CodingGhost/CCIPN/README.md

# CCIPN
Computer controlled intelligent power network
#Add Informations and news to this Project here.
#change 1
