CodingGhost/CCIPN/CCMR/Docs/CCMR.pptx

## CCMR

FPA in NWT
Klasse 10c
Lehrer: hr.Bujok

Computer Controlled Methane Reactor

## Inhalt

1. Einleitung
2. Aufbau
3. Hardware
4. Betriebsablauf
5. Software
6. Fazit

## Einleitung

- Idee:

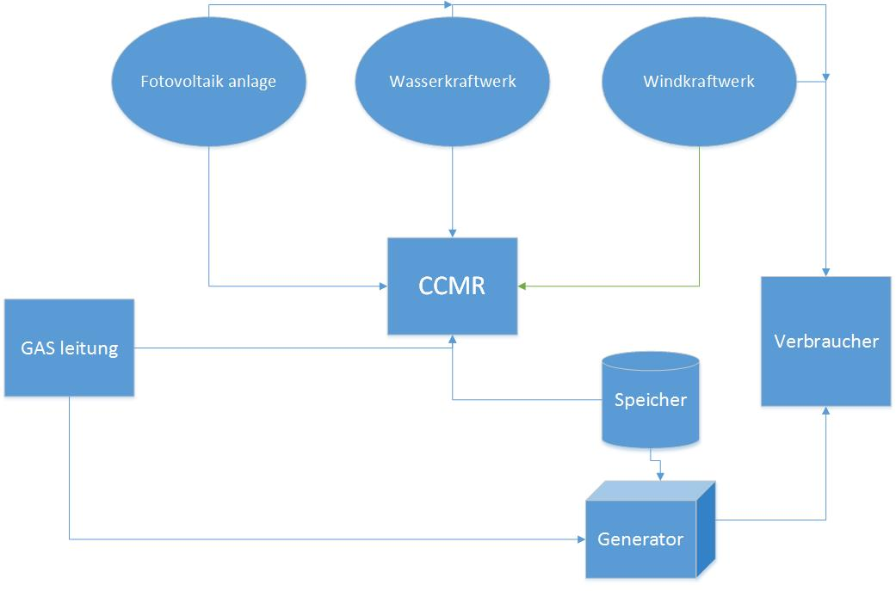
[picture p1: figure]

## Slide 4

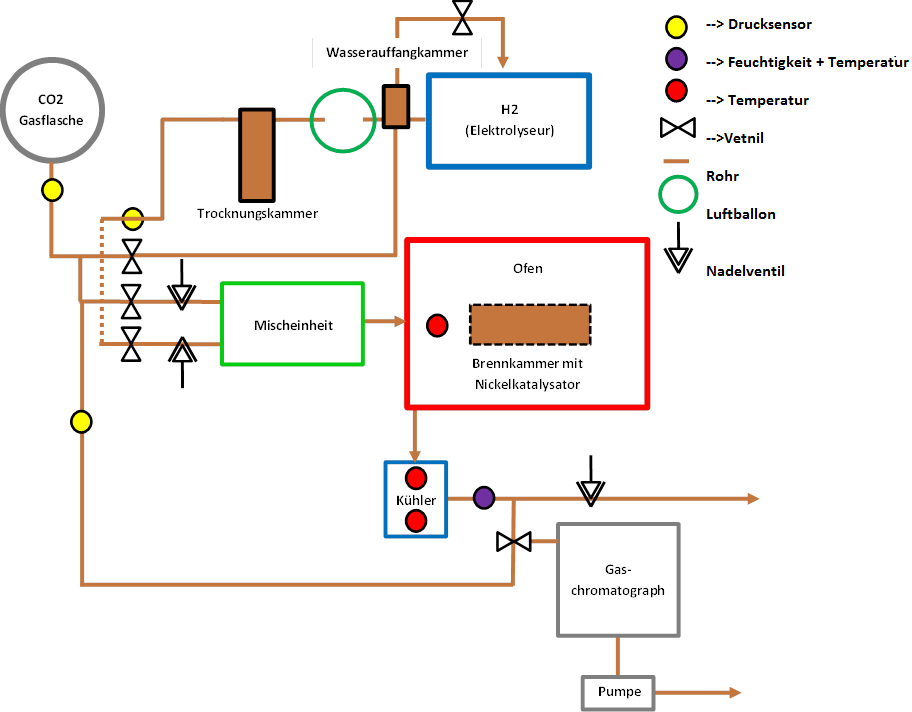
[picture p2: figure]

## Hardware

Sensoren:
- Drucksensor
- Temperatursensor
- Feuchtigkeitssensor
- Thermoelement
- Infrarotsensor
- Ultraschallsensor
- Potentiometer
- Selbstgebauter Gas Sensor

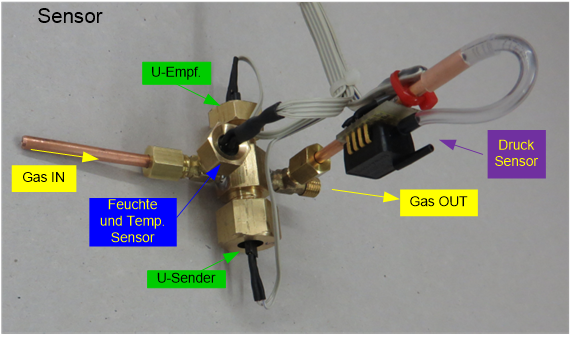
[picture p3: figure]

## Hardware

I2C Verteiler
Zur Vermeidung von Adresskonflikten

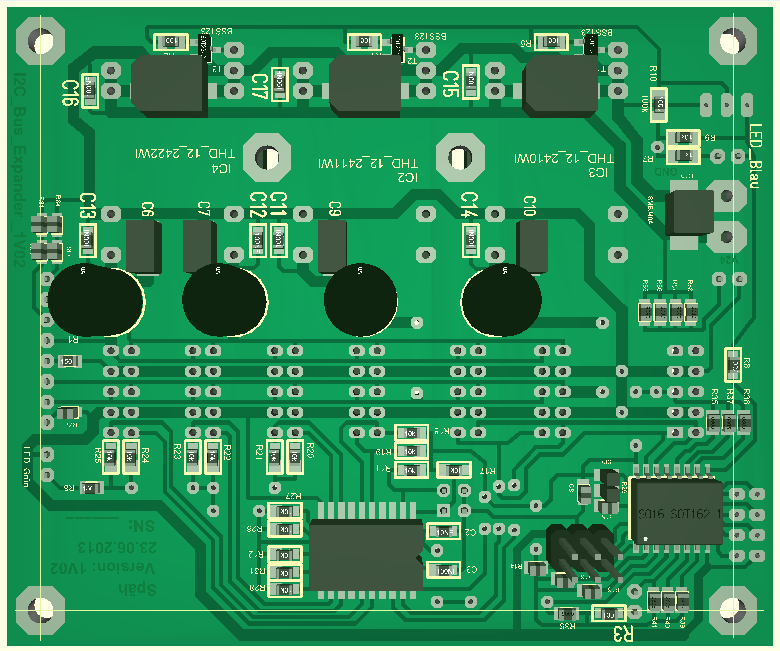
[picture p4: figure]

## Hardware

Sensor Platine
Zur Digitalisierung alle Analogwerte mittels AD Wandler
Außerdem ein DA Wandler der nicht verwendet wird.

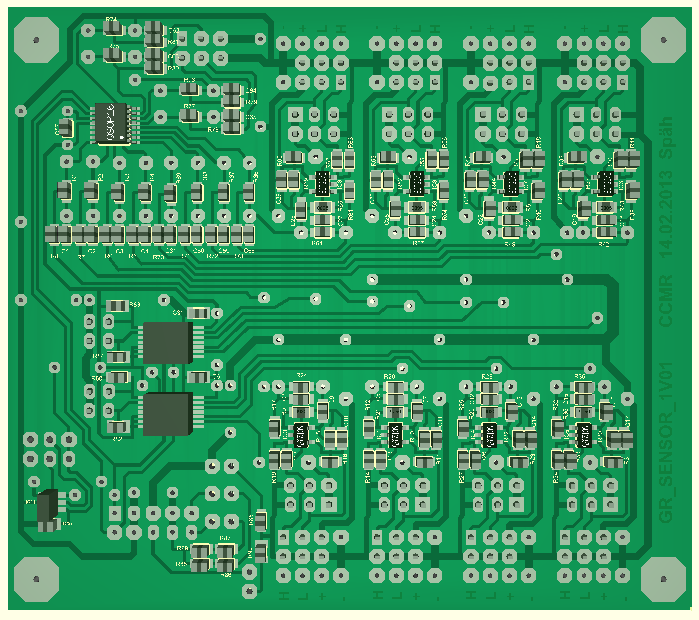
[picture p5: figure]

## Hardware

FET Platine
Zur Steuerung aller Leistungsbauteile

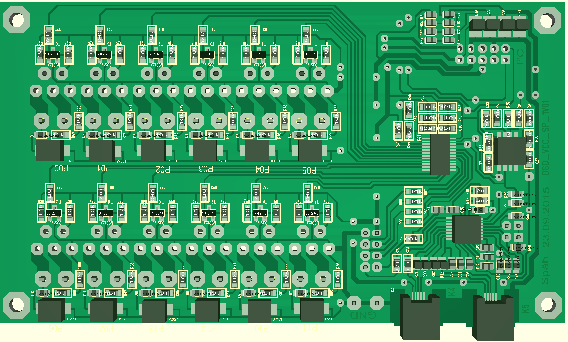
[picture p6: figure]

## Hardware

- Ultraschall Sensorplatine
- Momentan zu langsam
- Einsatz von FPGAs geplant

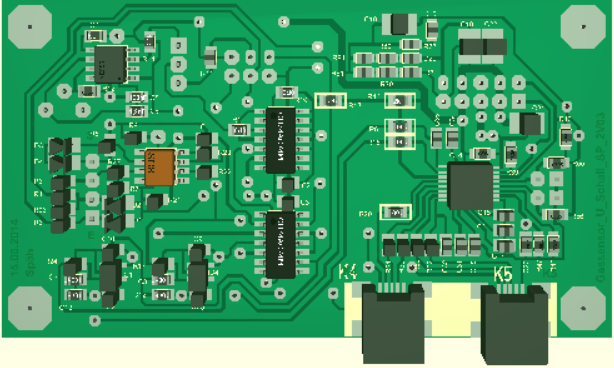
[picture p7: figure]

## Betriebsablauf

1. Gasflasche Manuell aufdrehen
2. Spülung mit Co2
3. Wasserstoff vorproduzieren
4. Ofen vorheizen
5. Beide Gase werden in de Mischkammer geleitet
6. Gase in Brennkammer leiten
7. Gase Reagieren zu CH4 = Methan

## Software

- Atmega 8 / Eclipse
- Atmega 2560 / Visual Studio
- Sprachen: VB, und C++ (später noch VHDL)

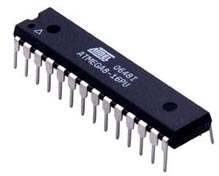
[picture p8: figure]
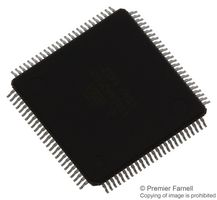
[picture p9: figure]

## Software

- Besteht aus 3 Teilen
- Hauptprogramm / Bibliothek / Adressverzeichnis
- Ventil öffnen: CCMR.valves.CO2(true/false);

## Fazit

- Dieses Modell könnte viele Probleme seitens Speicherung lösen
- Momentan Arbeit an Gemeinschaftsprojekt mit 2 CCMRs einem Speicher und Kraftwerk + Generator.

## Quellen

- http://www.newark.com/productimages/standard/en_US/68T2776-40.jpg
- http://www.robotplatform.com/images/components/Atmega8.jpg
- Frederic Forster; Tobias Dingler; Phillip Weber; Jürgen Späh (Team)
