CodingGhost/CCIPN/CCMR/Docs/ccmr-highres-V12.PNG

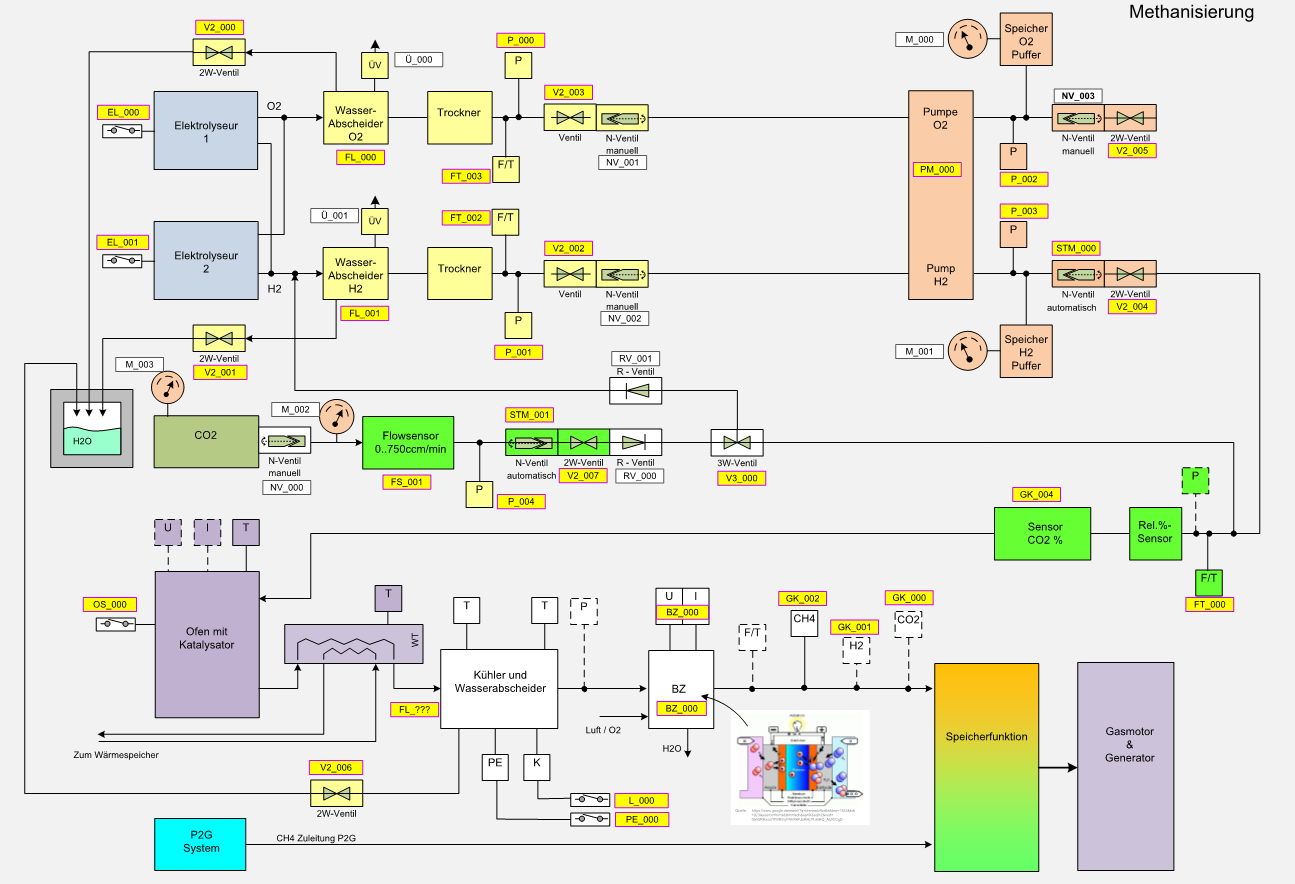
CCMR/Docs/ccmr-highres-V12.PNG
