CodingGhost/CCIPN/CCMR/Docs/ccmr.PNG

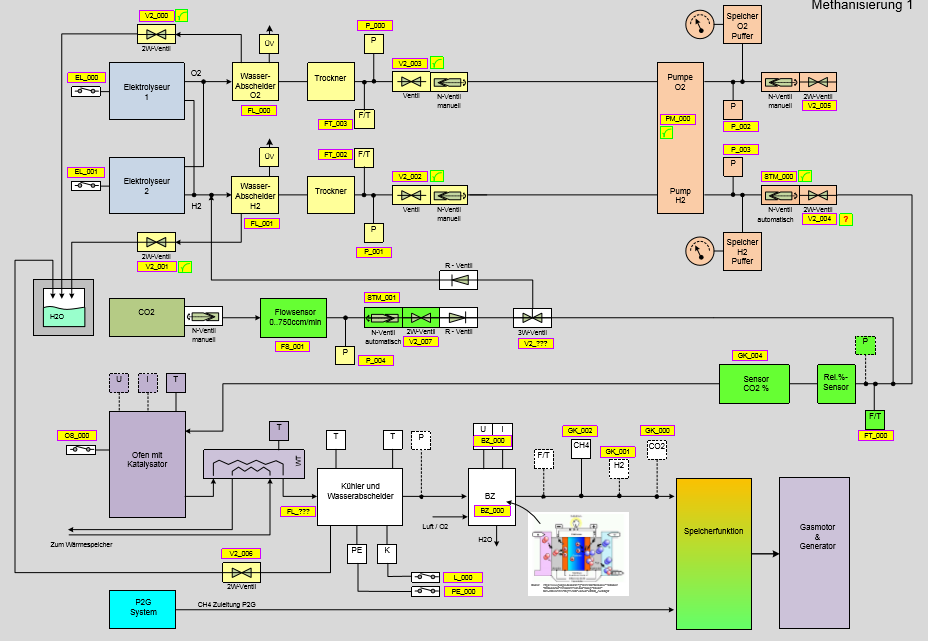
CCMR/Docs/ccmr.PNG
