CodingGhost/CCIPN/CCMR/Docs/ICD_Zayed_SP_V12_sfz.xls

Sheet: Datentransfer
Datum | 2016-03-28
File & Version | Zayed_Methanisierung_Parameter_SP_0V01
Standort | SFZ Überlingen
Parameter |  |  |  | Datenaustausch der Sub-Funktionen |  |  |  |  | Info
 |  |  |  | Methan | Speicher | Gaskr. | Internet
Betriebszustände Methanisierung | x | x | x | x | x | x | x | x | x
 | Power off |  |  |  |  |  | s
 | Initialisierung |  |  |  |  |  | s
 | Standby |  |  | r | r |  | s
 | CH4 Produktion |  |  | r | r |  | s |  | Speicherinhalt <70%
 | Shutdown |  |  | r | r |  | s
 | Fail |  |  | r | r |  | s
Betriebszustände Gaskraftwerk | x | x | x | x | x | x | x | x | x
 | Power off |  |  |  |  |  | s
 | Initialisierung |  |  |  |  |  | s
 | Standby |  |  |  | r | r | s
 | Generatorbetrieb |  |  |  | r | r | s |  | Speicherinhalt > 30%
 | Shutdown |  |  |  | r | r | s
 | Fail |  |  |  | r | r | s
Betriebszustände Speicher | x | x | x | x | x | x | x | x | x
 | Power off |  |  |  |  |  | s
 | Initialisierung |  |  |  |  |  | s
 | Standby |  |  | r | r | r | s
 | Gasspeicher leer |  |  | r | r | r | s |  | Speicherinhalt < 10%
 | Gasspeicher voll |  |  | r | r | r | s |  | Speicherinhalt > 90%
 | Gasspeicher füllen |  |  | r | r | r | s |  | 10%< Speicherinhalt < 90%
 | Gasspeicher füllen & Gasentnahme |  |  | r | r | r | s |  | 10%< Speicherinhalt < 90%
 | Gasentnahme |  |  | r | r | r | s |  | 10%< Speicherinhalt < 90%
 | Fail |  |  | r | r | r | s
Leistungsparameter | x | x | x | x | x | x | x | x | x
 | Einganssleistung Elektrolyseur | W |  | s |  |  | s
 | Elektrische Leistung Brennstoffzelle (Abgabe) | W |  | s |  |  | s
 | Elektrische Leistung Generator (Abgabe) | W |  |  |  | s | s
 | Füllstand CH4 Speicher | 0…100% |  |  | s |  | s
 | Energie eingespeist | Wh |  | s |  |  | s
 | Energie abgegeben | Wh |  |  |  | s | s
Regelparameter | x | x | x | x | x | x | x | x | x
 | Ofentemperatur | 0…400°C |  | r |  |  | o
 | Kühlertemperatur | -10…60°C |  | r |  |  | o
 | Strom Elektrolyseuer 1 | 0…5A |  | r |  |  | o
 | Strom Elektrolyseuer 2 | 0…5A |  | r |  |  | o
 | Spannung Elektrolyseuer 1 | 0…16V |  | r |  |  | o
 | Spannung Elektrolyseuer 2 | 0…16V |  | r |  |  | o
 | Brennstoffzellen Spannung | 0…16V |  | r |  |  | o
 | Brennstoffzellen Strom | 0…4A |  | r |  |  | o
 | Druck CH4 Speicher | 0…10bar |  |  | r |  | o |  | TBC
 | Druck CO2 | 0…2000mbar |  | r |  |  | o |  | TBC
 | Druck H2 | 0…2000mbar |  | r |  |  | o |  | TBC
 | Druck O2 | 0…2000mbar |  | r |  |  | o |  | TBC
 | Mischverhältnis CO2 / H2 | 0..100% |  | r |  |  | o
 | Feuchte/Temperatur Gasgemisch (Ofeneingang) | 0 … 100 % rF, -40 … 125 °C |  | r |  |  | o
 | Feuchte/Temperatur Reaktionsprodukt (Ofenausgang) | 0 … 100 % rF, -40 … 125 °C |  | r |  |  | o
 | Feuchte/Temperatur Gas Speichereingang | 0 … 100 % rF, -40 … 125 °C |  |  | r |  | o
 | Generator Strom | 0…10A |  |  |  | r | o |  | TBC
 | Generator Spannung | 0…30V |  |  |  | r | o |  | TBC
 | Gerenator Drehzahl | 0…..3000U/min |  |  |  | r | o
 | Gasmotordrehzahl | 0…1500U/min |  |  |  | r | o |  | TBC

Sheet: Daten_Protokoll
Datenprotokoll
Übertragung (File) |  |  |  |  |  |  |  |  | Zusatzinfo
Allocation |  | Index |  | Time Stamp |  | Value | Zeilen- umbruch |  | Typ | Min | Max | Einheit | Funktion | Allocation |  | Fehlercode |  |  | Index
 |  | 41 |  |  |  |  |  |  |  |  |  |  |  |  |  | Num | Value | Comment
AXXX | ; | 000 | ; | 0 | ; | 0 | CR |  | Status | 0 | 1 | - | File Anfang | MEXX | Methanisierung Eingabe | 000 | - | Kein Fehler | 000 … 099 | File Info
0XXX | ; | 000 | ; | 0 | ; | 0 | CR |  |  |  |  |  |  | MAXX | Methanisierung Ausgabe | 001 | - | Fehler in CH4-Modul | 100 … 199 | Status
 |  |  |  |  |  |  |  | x | x | x | x | x | x | GEXX | Gasmotor Eingabe | 002 | - | Fehler in Speichermodul | 200 … 599 | Parameter
MAXX | ; | 100 | ; | 0 | ; | 0 | CR |  | Status | 0 | 1 | - | System on =1 | GAXX | Gasmotor Ausgabe | 003 | - | Fehler in Gasmotormodul | …
MAXX | ; | 101 | ; | 0 | ; | 0 | CR |  | Status | 0 | 1 | - | Initialisierung = 1 | PEXX | Power 2 GAS Eingabe | … |  |  | …
MAXX | ; | 102 | ; | 0 | ; | 0 | CR |  | Status | 0 | 1 | - | Standby = 1 | PAXX | Power 2 GAS Ausgabe | 100 | - | H2 Erzeugung defekt | … 999
MAXX | ; | 103 | ; | 0 | ; | 0 | CR |  | Status | 0 | 1 | - | CH4 Produktion =1 | SEXX | Speicher Eingabe | 101 | - | Ofenheizung defekt
MAXX | ; | 104 | ; | 0 | ; | 0 | CR |  | Status | 0 | 1 | - | Shutdown =1 | SAXX | Speicher Ausgabe | 102 | - | H2 Überdruck Elektrolyseur
MAXX | ; | 105 | ; | 0 | ; | 0 | CR |  | Status | 0 | 1 | - | Fail = 1 | FAIL | Fehlermeldung | 103 |  | H2 Überdruck Druckspeicher
MAXX | ; | 200 | ; | 0 | ; | 0 | CR |  | Leistung | 0 | 150 | W | Einganssleistung Elektrolyseur | AXXX | File Anfang | 104 |  | H2 Wasserabscheider Füllstandsanzeige
MAXX | ; | 201 | ; | 0 | ; | 0 | CR |  | Leistung | 0 | 50 | W | Elektrische Leistung Brennstoffzelle (Abgabe) | EXXX | File Ende | 105 |  | CH4 Wasserabscheider Füllstandsanzeige
MAXX | ; | 202 | ; | 0 | ; | 0 | CR |  | Energie | 0 | - | Wh | Energie eingespeist ( in Elektrolyseur ) | 0XXX | No Information / Spare | 106 |  | O2 Wasserabscheider Füllstandsanzeige
MAXX | ; | 203 | ; | 0 | ; | 0 | CR |  | Temperatur | 0 | 400 | °C | Ofentemperatur |  |  | …
MAXX | ; | 204 | ; | 0 | ; | 0 | CR |  | Temperatur | -10 | 60 | °C | Kühlertemperatur |  |  | …
MAXX | ; | 205 | ; | 0 | ; | 0 | CR |  | Strom | 0 | 5 | A | Strom Elektrolyseuer 1 |  |  | …
MAXX | ; | 206 | ; | 0 | ; | 0 | CR |  | Strom | 0 | 5 | A | Strom Elektrolyseuer 2 |  |  | …
MAXX | ; | 207 | ; | 0 | ; | 0 | CR |  | Spannung | 0 | 16 | V | Spannung Elektrolyseuer 1 |  |  | …
MAXX | ; | 208 | ; | 0 | ; | 0 | CR |  | Spannung | 0 | 16 | V | Spannung Elektrolyseuer 2 |  |  | 999
MAXX | ; | 209 | ; | 0 | ; | 0 | CR |  | Druck | 0 | 2000 | mbar | Druck CO2
MAXX | ; | 210 | ; | 0 | ; | 0 | CR |  | Druck | 0 | 2000 | mbar | Druck H2
0XXX | ; | 000 | ; | 0 | ; | 0 | CR
 |  |  |  |  |  |  |  | x | x | x | x | x | x
SAXX | ; | 101 | ; | 0 | ; | 0 | CR |  | Status | 0 | 1 | - | Initialisierung =1
SAXX | ; | 102 | ; | 0 | ; | 0 | CR |  | Status | 0 | 1 | - | Standby =1
SAXX | ; | 103 | ; | 0 | ; | 0 | CR |  | Status | 0 | 1 | - | Gasspeicher leer =1
SAXX | ; | 104 | ; | 0 | ; | 0 | CR |  | Status | 0 | 1 | - | Gasspeicher voll =1
SAXX | ; | 105 | ; | 0 | ; | 0 | CR |  | Status | 0 | 1 | - | Gasspeicher füllen =1
SAXX | ; | 106 | ; | 0 | ; | 0 | CR |  | Status | 0 | 1 | - | Gasspeicher füllen & Gasentnahme =1
SAXX | ; | 107 | ; | 0 | ; | 0 | CR |  | Status | 0 | 1 | - | Gasentnahme =1
SAXX | ; | 200 | ; | 0 | ; | 0 | CR |  | Füllstand | 0 | 100 | % | Füllstand CH4 Speicher
SAXX | ; | 201 | ; | 0 | ; | 0 | CR |  | Druck | 0 | 10 | bar | Druck CH4 Speicher
0XXX | ; | 000 | ; | 0 | ; | 0 | CR
 |  |  |  |  |  |  |  | x | x | x | x | x | x
GAXX | ; | 100 | ; | 0 | ; | 0 | CR |  | Status | 0 | 1 | - | Standby = 1
GAXX | ; | 101 | ; | 0 | ; | 0 | CR |  | Status | 0 | 1 | - | Generatorbetrieb = 1
GAXX | ; | 102 | ; | 0 | ; | 0 | CR |  | Status | 0 | 1 | - | Shutdown =1
GAXX | ; | 103 | ; | 0 | ; | 0 | CR |  | Status | 0 | 1 | - | Fail = 1
GAXX | ; | 200 | ; | 0 | ; | 0 | CR |  | Drehzahl | 0 | 8000 | u/min | Gerenator Drehzahl
GAXX | ; | 201 | ; | 0 | ; | 0 | CR |  | Drehzahl | 0 | 2000 | u/min | Gasmotordrehzahl
0XXX | ; | 000 | ; | 0 | ; | 0 | CR
 |  |  |  |  |  |  |  | x | x | x | x | x | x
FAIL | ; | 001 | ; | 0 | ; | 0 | CR |  | Status | - | - | - | Methanisierung
FAIL | ; | 101 | ; | 0 | ; | 0 | CR |  | Status | - | - | - | Ofenheizung
0XXX | ; | 000 | ; | 0 | ; | 0 | CR
 |  |  |  |  |  |  |  | x | x | x | x | x | x
EXXX | ; | 000 | ; | 0 | ; | 0 | CR |  | Status | - | - | - | Ende File

Sheet: Komponentenüberischt
 |  |  |  |  |  | Platinen-bezeichnung
 |  |  |  |  | Interface | ?
ICD-Eintrag | System | Funktion | Aktuator/Sensor | System IF_Type Instanz | IF-Type | Platine | Steuerung | digital analog I2C
 |  |  |  | 85
l | Methanisierung | Zuflusseinstellung zum H2-Mixer (Steppermotor STP, POT) | Nadelventil | STM_000 | STP_1A0 | STM0 | A | a,d
l | Methanisierung | Manuelle Spülung des H2-Pfades mit CO2 | Nadelventil | NV_000 | manuell | - | M | -
l | Methanisierung | Zuflusseinstellung zum H2-Speicher | Nadelventil | NV_001 | manuell | - | M | -
l | Methanisierung | Zuflusseinstellung zum O2-Speicher | Nadelventil | NV_002 | manuell | - | M | -
l | Methanisierung | Zuflusseinstellung H2 zum Mixer | Nadelventil | NV_003 | manuell | - | M | -
l | Methanisierung | Zuflusseinstellung O2 | Nadelventil | NV_004 | manuell | - | M | -
l | Methanisierung | Zuflusseinstellung CO2 (Steppermotor STP, POT) | Nadelventil | STM_001 | STP_1A0 | STM1 | A | a,d
l | Methanisierung | Druchflussmenge CO2 aus Gasflasche | Flow-Sensor | FS_001 | AI_V0P_V2P5 | STM1 | A | a
 | Methanisierung
l | Methanisierung | Wasserabscheider H2 | Ventil 2-Weg | V2_000 | DSO 24V_OPN | P2G0 | A | d
l | Methanisierung | Wasserabscheider O2 | Ventil 2-Weg | V2_001 | DSO 24V_OPN | P2G0 | A | d
l | Methanisierung | Messung Humidity & Temperature Zufluss zum H2-Speicher | Feuchte & Temperatur | FT_002 | I2C | P2G0 | A | I2C
l | Methanisierung | Messung Humidity & Temperature Zufluss zum O2-Speicher | Feuchte & Temperatur | FT_003 | I2C | P2G0 | A | I2C
l | Methanisierung | Zufluss zum H2-Speicher | Ventil 2-Weg | V2_002 | DSO 24V_OPN | P2G0 | A | d
l | Methanisierung | Zufluss zum O2-Speicher | Ventil 2-Weg | V2_003 | DSO 24V_OPN | P2G0 | A | d
l | Methanisierung | Auslass H2-Speicher | Ventil 2-Weg | V2_004 | DSO 24V_OPN | P2G0 | A | d
l | Methanisierung | Auslass O2-Speicher | Ventil 2-Weg | V2_005 | DSO 24V_OPN | P2G0 | A | d
 | Methanisierung | Wasserabscheider Küler Syntheseprodukt (CH4) | Ventil 2-Weg | V2_006 | DSO 24V_OPN | ? | A | d
x | Methanisierung | Auslass CO2 to Mixer | Ventil 2-Weg | V2_007 | DSO 24V_OPN | P2G0 | A | d
 | Methanisierung | Bypass Wärmetauschereingang | Wärmetauscher | V2_008 | DSO 24V_OPN | ? | A | d
 | Methanisierung | Überdruckventil Druckerzeuger | Überdruckventil | ÜV_000 | manuell | - | M | -
 | Methanisierung | Überdruckventil Druckerzeuger | Überdruckventil | ÜV_000 | manuell | - | M | -
x | Methanisierung | Ofensteuerung ( Switch) | Ofensteuerung | OS_000 | DSO_GNDOPN_10A0 | PSW0 | A | d
x | Methanisierung | Brennstoffzelle ( Switch, Umon, Imon) | Brenstoffzelle | BZ_000 | DSO_GNDOPN_5A0_UI | P2G0 | A | a
x | Methanisierung | Messung Ofentemperatur | Temperatur TH-Typ-K | TH_000 | CVAI | P2G0 | A | a | Konfig als TH-Eingang mit Ensprender Wid. Beschaltung
 | Methanisierung | Messung Kühlertemperatur | Temperatur | T_000 | I2C | ? | A | I2C
 | Methanisierung | Messung Kühlertemperatur | Temperatur | T_001 | I2C | ? | A | I2C
x | Methanisierung | Steuerung Lüfter für Kühler | Lüfter | L_000 | DSI_&_DSO_HS_OPN_V12P_1 | PSW0 | A | d
x | Methanisierung | Steuerung Peltierelemente 1 und 2 (in Serie geschaltet) | Peltierelement | PE_000 | DSO_GNDOPN_10A0 | PSW0 | A | d
 | Methanisierung | Messung Raumtemperatur | Temperatur | T_002 | I2C | P2G0 | A | I2C
 | Methanisierung | Messung Verhältnis H2 <=> CO2 | Ultraschall Rel._%_Sensor | USS_000 | ?? | ? | A | a
x | Methanisierung | Pumpe für H2, O2 Speicher | Pumpe | PM_000 | DSO 24V_OPN | P2G0 | A | d
x | Methanisierung | Messung O2 Druck Eletrolyser | Drucksensor | P_000 | AI_V0P_V5P | P2G0 | A | a
x | Methanisierung | Messung H2/CO2 Druck (Eletrolyser) | Drucksensor | P_001 | AI_V0P_V5P | P2G0 | A | a
x | Methanisierung | Messung O2 Druck O2-Speicher | Drucksensor | P_002 | AI_V0P_V5P | P2G0 | A | a
x | Methanisierung | Messung H2/CO2 Druck (H2/CO2-Speicher) | Drucksensor | P_003 | AI_V0P_V5P | P2G0 | A | a
x | Methanisierung | Messung Druck CO2 | Drucksensor | P_004 | AI_V0P_V5P | STM1 | A | a
 | Methanisierung | Messung Druck zwischen Ofen und Brennstoffzelle | Drucksensor | P_005 | AI_V0P_V5P | ? | A | a
x | Methanisierung | Elektrolyser 1 (Switch, Umon, Imon) | Eletrolyser 1 | EL_000 | DSO GNDOPN_V4P_V14P | P2G0 | A | d
x | Methanisierung | Elektrolyser 2 (Switch, Umon, Imon) | Eletrolyser 2 | EL_001 | DSO GNDOPN_V4P_V14P | P2G0 | A | d
x | Methanisierung | Messung Durchflussmenge(Flow-Sensor) CO2,H2 Gemisch | Flow-Sensor | FS_000 | I2C | P2G0 | A | I2C
x | Methanisierung | Füllstandsensor O2 Wasserabscheider | Füllstandsensor | FL_000 | AI_V0P_V2P5 | P2G0 | A | a
x | Methanisierung | Füllstandsensor H2 Wasserabscheider | Füllstandsensor | FL_001 | AI_V0P_V2P5 | P2G0 | A | a
x | Methanisierung | Füllstandsensor Syntheseprodukt (CH4) Wasserabscheider | Füllstandsensor | FL_002 | AI_V0P_V5P | PSW0 | A | a
x | Methanisierung | Messung Humidity & Temperature CO2,H2 Gemisch | Feuchte & Temperatur | FT_000 | I2C | P2G0 | A | I2C
 | Methanisierung | Messung Humidity & Temperature Syntheseprodukt (CH4) | Feuchte & Temperatur | FT_001 | I2C | PSW0 | A | I2C
x | Methanisierung | Messung CO2 Konzentration von Gemisch CO2, H2 | CO2-Sensor | GK_004 | AI_V0P_V5P | STM1 | A | a
x | Methanisierung | Messung CO2 Konzentration Syntheseprodukt (CH4) | CO2-Sensor | GK_000 | CVAI | P2G0 | A | a
x | Methanisierung | Messung H2 Konzentration von Syntheseprodukt (CH4) | CO2 Sensor | GK_001 | CVAI | P2G0 | A | a
x | Methanisierung | Messung CH4 Konzentration von Syntheseprodukt (CH4) | CH4 Sensor | GK_002 | CVAI | P2G0 | A | a
 | Methanisierung | Manometer O2 Speicher | Manometer 2,5 bar | M_000 | manuell | - | M | -
 | Methanisierung | Manometer H2 Speicher | Manometer 2,5 bar | M_002 | manuell | - | M | -
 | Methanisierung | Manometer CO2 Speicher (Manometer 50bar, Druckred. 6bar) | Manometer 6 bar | M_003 | manuell | - | M | -
 | Methanisierung | Schalter Softwarehalt | Halt-Switch | HS_000 | DSI | P2G0 | A | d
 | Methanisierung | Temperatur Wärmetauscher optional | Temperatur |  | I2C | ? | A | I2C
 | Methanisierung | Spare |  |  | DSI | P2G0
 | Methanisierung | Spare |  |  | DSI | P2G0
 | Methanisierung | Spare |  |  | DSI | P2G0
 | Methanisierung | Spare |  |  | DSI | P2G0
 | Methanisierung | ???? |  |  | DSO_GNDOPN_10A0
x | x | x | x | x | x | x | x | x | x | x
 | Speicher | Manometer CH4 Speicher | Manometer 15 bar | M_100 | manuell | - | M | -
 | Speicher | Manometer CH4 Gasmotorzuführung | Manometer 1,5 bar | M_101 | manuell | - | M | -
 | Speicher | Rückschlagventil CH4 Zuleitung Methanisierung | Rückschlagventil | RV_100 | manuell | - | M | -
 | Speicher | Rückschlagventil CH4 Zuleitung P2G | Rückschlagventil | RV_101 | manuell | - | M | -
 | Speicher | Rückschlagventil CH4 Druckspeicher | Rückschlagventil | RV_102 | manuell | - | M | -
 | Speicher | Rückschlagventil Pumpe CH4 Druckerzeuger | Rückschlagventil | RV_103 | manuell | - | M | -
 | Speicher | Ventil CH4 Zuleitung Methanisierung | Ventil 2-Weg | V2_100 | DSO 24V_OPN | PSW1 | A | d | ?
 | Speicher | Ventil CH4 Zuleitung P2G | Ventil 2-Weg | V2_101 | DSO 24V_OPN | PSW1 | A | d | ?
 | Speicher | Ventil Wasserrücklauf Druckerzeuger | Ventil 2-Weg | V2_102 | DSO 24V_OPN | PSW1 | A | d | ?
 | Speicher | Ventil CH4 Druckspeicher Zuleitung | Ventil 2-Weg | V2_103 | DSO 24V_OPN | PSW1 | A | d | ?
 | Speicher | Ventil CH4 Motor Zuleitung | Ventil 2-Weg | V2_104 | DSO 24V_OPN | PSW1 | A | d | ?
 | Speicher | Ventil CH4 Motor Zuleitung | Druckreduzierer | DR_100 | manuell | - | M | m
 | Speicher | Messung CH4 Druckerzeuger | Drucksensor | P_100 | AI_V0P_V5P | PSW1 | A | a | ?
 | Speicher | Messung CH4 Druckspeicher | Drucksensor | P_101 | AI_V0P_V5P | PSW1 | A | a | ?
 | Speicher | Überdruckventil Druckerzeuger | Überdruckventil | ÜV_100 | manuell | - | M
 | Speicher | Druchflussbegrenzer Wasserückfluss Druckerzeuger | Begrenzer | B_100 | manuell | - | - | -
 | Speicher | Füllstandsensor Wasserbehälter Druckerzeuger | Füllstandsensor | FL_100 | AI_V0P_V5P | PSW1 | A | a | ?
 | Speicher | Schwingkolbenpumpe | SK-Pumpe | SK_000 | 220VAC | ACS0 |  |  | 230VAC Steuerung ansteuerbar über I2C !!
 | Speicher | Schalter Softwarehalt | Halt-Switch | HS_100 | DSI | PSW1 | A | d | ?
x | x | x | x | x | x | x | x | x | x | x
x | Gasmotor | Regelung Zufluss CH4, Butan zum Motor | Nadelventil | STM_200 | STP_1A0 | STM2 | A | a,d
x | Gasmotor | Steuerung Zufluss CH4, Butan zum Motor in/off | Ventil 2-Weg | V2_202 | DSO 24V_OPN | STM2 | A | d | Wird über HW-Wired-Or-Schaltung mit V2_200 oder V2_001 angesteuert
x | Gasmotor | Steuerung CH4 Zuleitung Motor | Ventil 2-Weg | V2_200 | DSO 24V_OPN | STM2 | A | d
x | Gasmotor | Steuerung Butan Zuleitung Motor | Ventil 2-Weg | V2_201 | DSO 24V_OPN | STM2 | A | d
x | Gasmotor | Druck Zufluss CH4, Butan zum Motor | Drucksensor | P_200 | AI_V0P_V5P | PSW1 | A
x | Gasmotor | Druchfluss CH4, Butan zum Motor | Flow-Sensor | FS_200 | I2C | PSW1 | A | I2C | ?
 | Gasmotor | Elektrosstarter Gasmotor | E-Motor | EM_200 | DSO 24V_OPN | ? | ? | ? | Optional
 | Gasmotor | Drehstrom Gleichrichter | ? | DG_200 | DSO_GNDOPN_5A0_UI | PSW1 | ? | ? | ?
 | Gasmotor | Drehzahlmessung Gasmotor | ? | D_200 | ? | ? | ? | ? | ?
x | Gasmotor | Schalter Softwarehalt | Halt-Switch | HS_200 | DSI | PSW1 | A | d
x | x | x | x | x | x | x | x | x | x | x

Sheet: Pivot
Platine | IF-Type | System IF_Type Instanz
- | manuell | B_100
 |  | DR_100
 |  | M_000
 |  | M_002
 |  | M_003
 |  | M_100
 |  | M_101
 |  | NV_000
 |  | NV_001
 |  | NV_002
 |  | NV_003
 |  | NV_004
 |  | NV_006
 |  | RV_100
 |  | RV_101
 |  | RV_102
 |  | RV_103
 |  | ÜV_000
 |  | ÜV_100
 | manuell Ergebnis
- Ergebnis
? | ? | D_200
 | ? Ergebnis
 | ?? | USS_000
 | ?? Ergebnis
 | AI_V0P_V5P | P_005
 | AI_V0P_V5P Ergebnis
 | DSO 24V_OPN | EM_200
 |  | V2_006
 |  | V2_008
 | DSO 24V_OPN Ergebnis
 | DSO_GNDOPN_10A0 | OST_000
 |  | PE_000
 | DSO_GNDOPN_10A0 Ergebnis
 | I2C | T_000
 |  | T_001
 |  | (Leer)
 | I2C Ergebnis
? Ergebnis
ACS0 | 220VAC | SK_000
 | 220VAC Ergebnis
ACS0 Ergebnis
P2G0 | AI_V0P_V2P5 | FL_000
 |  | FL_001
 | AI_V0P_V2P5 Ergebnis
 | AI_V0P_V5P | P_000
 |  | P_001
 |  | P_002
 |  | P_003
 | AI_V0P_V5P Ergebnis
 | CVAI | GK_000
 |  | GK_001
 |  | GK_002
 |  | TH_000
 | CVAI Ergebnis
 | DSI | HS_000
 |  | (Leer)
 | DSI Ergebnis
 | DSO 24V_OPN | PM_000
 |  | V2_000
 |  | V2_001
 |  | V2_002
 |  | V2_003
 |  | V2_004
 |  | V2_005
 |  | V2_007
 | DSO 24V_OPN Ergebnis
 | DSO GNDOPN_V4P_V14P | EL_000
 |  | EL_001
 | DSO GNDOPN_V4P_V14P Ergebnis
 | DSO_GNDOPN_5A0_UI | BZ_000
 | DSO_GNDOPN_5A0_UI Ergebnis
 | I2C | FS_000
 |  | FT_000
 |  | FT_002
 |  | FT_003
 |  | T_002
 | I2C Ergebnis
P2G0 Ergebnis
PSW0 | AI_V0P_V5P | FL_002
 | AI_V0P_V5P Ergebnis
 | DSI_&_DSO_HS_OPN_V12P_1 | L_000
 | DSI_&_DSO_HS_OPN_V12P_1 Ergebnis
 | I2C | FT_001
 | I2C Ergebnis
PSW0 Ergebnis
PSW1 | AI_V0P_V5P | FL_100
 |  | P_100
 |  | P_101
 |  | P_200
 | AI_V0P_V5P Ergebnis
 | DSI | HS_100
 |  | HS_200
 | DSI Ergebnis
 | DSO 24V_OPN | V2_100
 |  | V2_101
 |  | V2_102
 |  | V2_103
 |  | V2_104
 | DSO 24V_OPN Ergebnis
 | DSO_GNDOPN_5A0_UI | DG_200
 | DSO_GNDOPN_5A0_UI Ergebnis
 | I2C | FS_200
 | I2C Ergebnis
PSW1 Ergebnis
STM0 | STP_1A0 | STM_000
 | STP_1A0 Ergebnis
STM0 Ergebnis
STM1 | AI_V0P_V5P | GK_004
 |  | P_004
 | AI_V0P_V5P Ergebnis
 | STP_1A0 | STM_001
 | STP_1A0 Ergebnis
STM1 Ergebnis
STM2 | DSO 24V_OPN | V2_200
 |  | V2_201
 |  | V2_202
 | DSO 24V_OPN Ergebnis
 | STP_1A0 | STM_200
 | STP_1A0 Ergebnis
STM2 Ergebnis
x | x | x
 | x Ergebnis
x Ergebnis
(Leer) | DSO_GNDOPN_10A0 | (Leer)
 | DSO_GNDOPN_10A0 Ergebnis
 | (Leer) | 85
 |  | (Leer)
 | (Leer) Ergebnis
(Leer) Ergebnis
Gesamtergebnis

Sheet: Interface-Konzept
Typ | Interface | versatil konfig. | Config Type | Anzahl & Zuordnung |  |  |  |  |  |  | Funktion | Monitor |  | Stecker / Pin |  |  |  |  |  | Strom
 |  |  |  | P2G0 | STPM_0 | STPM_1 | STPM_2 | PSW0 | PSW1 | ACS0
Ausgänge | DSO 24V_OPN |  |  | 8 | 2 | 2 | 2 |  |  |  | on/off |  |  | OUT |  |  |  |  |  | 1A5
Ausgänge | DSO_12V_OPN |  |  |  |  |  |  |  |  |  | on/off |  |  | OUT
Ausgänge | DSI_&_DSO_HS_OPN_xxxxxx |  |  |  |  |  |  |  |  |  | on/off |  |  | OUT | IN | V5P
Ausgänge | DSI_A_&_DSO_HS_OPN_xxxxxx |  |  |  |  |  |  |  |  |  | on/off |  |  | OUT | IN | GND | V5P
Ausgänge | DSO_GNDOPN_1A5 |  |  |  |  |  |  |  |  |  | on/off |  |  | OUT |  |  |  |  |  | 1A5
Ausgänge | DSO_GNDOPN_5A0 |  |  |  |  |  |  |  |  |  | on/off |  |  | OUT | V_IO
Ausgänge | DSO_GNDOPN_5A0_I |  |  |  |  |  |  |  |  |  | on/off |  | Imon | OUT | V_IO
Ausgänge | DSO_GNDOPN_10A0 |  |  |  |  |  |  |  |  |  | on/off |  |  | OUT | V_IO
Ausgänge | DSO_GNDOPN_5A0_UI |  |  | 1 |  |  |  |  |  |  | on/off | Umon | Imon | OUT | IN+ |  |  |  |  | 5A0
Ausgänge | DSO_GNDOPN_10A0_UI |  |  |  |  |  |  |  |  |  | on/off | Umon | Imon | OUT | IN+ |  |  |  |  | 10A
Ausgänge | DSO GNDOPN_V4P_V14P | y |  | 2 |  |  |  |  |  |  | on/off | Umon | Imon | OUT | V4P…V14P |  |  |  |  | 6A0
Diskrete Eingänge | CVDI | y | H | 5 |  |  |  |  |  |  | on/off |  |  | IN | V5P |  |  |  |  | 0A2
Diskrete Eingänge | DSI_A |  |  |  |  |  |  |  |  |  | on/off |  |  | IN | GND | V5P
Analoge Eingänge | CVAI | y | HS | 4 |  |  |  |  |  |  | 0V..5V |  |  | IN+ | IN- | GND | V5P |  |  | 0A2
Analoge Eingänge | AI_V0P_V5P |  |  | 4 | 2 | 2 | 2 |  |  |  | 0V..5V |  |  | IN+ | GND | V5P |  |  |  | 0A2
Analoge Eingänge | AI_V0P_V2P5 |  |  | 2 |  |  |  |  |  |  | 0V..2V5 |  |  | IN1+ | IN2+ | GND | V5P |  |  | 0A2
Steppermotor | STP_1A0 |  |  |  | 1 | 1 | 1 |  |  |  | 4V…12V |  |  | OUT_A | OUT_B | OUT_C | OUT_D
I2C | I2C |  |  | x | x | x | x |  |  |  | I2C |  |  | SCL | SDA | GND | V5P | V12P | V12N
I2C_BusmultiplexerMUX | I2C_MUX |  |  | 1 |  |  |  |  |  |  | I2C
Rel._%_Sensor | USS |  |  |  |  |  |  |  |  |  | ?? |  |  | EX_Q- | EX_Q+ | GND | U_IN- | U_IN+
220VAC Switch | 220VAC_SW |  |  |  |  |  |  |  |  | 1 | 220VAC
INIT_CVAI |  | y | S | x |  |  |  |  |  |  | I2C
VCC_CONFIG | Konfiguraton Versorgung
ADR_CONFIG | Konfiguration Adressenvon I2C
nschluss | Pins für Anschluss
kein IF | manuell |  |  |  |  |  |  |  |  |  | -

Sheet: ICD
 |  |  | V2_xxxx |  |  |  |  |  |  |  |  |  |  |  |  | DSO 24V_OPN
 |  |  | STM1 |  |  |  | Umrechnung
 |  |  | STM0 |  |  |  | Bin | Dez | Hex |  | Wenn TBD dann |  | ? |  | eintragen
 |  |  |  |  |  |  | 100101 | 37 | 25
 |  |  |  |  |  |  | 01001010 | 74 | 4a
 |  |  |  |  |  |  | 00111111 | 63 | 3F
 |  |  |  |  |  |  |  |  |  |  |  |  |  |  |  |  |  |  |  |  |  |  | Bereiche
System | JW Status | Angschlossen | System-Funktion Interfacefunktionen | IF-Type | in / out | offset init. | System Instanz | Platine | Adr | Baustein | Port | In/Out | Name auf Platine |  | Stecker/Pin | Signale am Stecker | Comment | Value |  | Ref. | Sensor- Sig. | Sensor | Min | Max | Res. LSB == | Verstärkung | Umrechnung /Verstäkung
 |  |  |  |  |  |  |  |  |  | 15
m |  |  | Elektrolyser 1 Switch | DSO GNDOPN_V4P_V14P | o | - | EL_000 | P2G0 | 21 | PCF8575 | P05 | DSO_LS | P05 |  | K8/2 |  |  | on =0 | off=1 | -
m |  |  | Elektrolyser 2 Switch | DSO GNDOPN_V4P_V14P | o | - | EL_001 | P2G0 | 21 | PCF8575 | P06 | DSO_LS | P06 |  | K9/2 |  |  | on =0 | off=1 | -
m |  |  | Elektrolyser 1 Umon | DSO GNDOPN_V4P_V14P | i | - | EL_000 | P2G0 | 35 | MAX1238 | AIN1 | AI | VDD_1 |  | K8/1 |  |  | 0 | 4096 | 4.0960 |  |  | 0.00 V | 28.00 V | 0.011 V |  | AD* (4,096/4096)*(1/(4,99/34,99)) | 0.007012
m |  |  | Elektrolyser 2 Umon | DSO GNDOPN_V4P_V14P | i | - | EL_001 | P2G0 | 35 | MAX1238 | AIN0 | AI | VDD_2 |  | K9/1 |  |  | 0 | 4096 | 4.0960 |  |  | 0.00 V | 28.00 V | 0.011 V |  | AD* (4,096/4096)*(1/(4,99/34,99)) | 0.007012
m |  |  | Elektrolyser 1 Imon | DSO GNDOPN_V4P_V14P | i | - | EL_000 | P2G0 | 35 | MAX1238 | AIN2 | AI | Imon_1 |  | - |  |  | 0 | 4096 | 4.0960 | 0,05Ohm |  | 0.00 A | 7.00 A | 0.002 A |  | AD* (4,096/(4096)*(1/(1+(100/10)))*(1/0,05) | 0.001818 | 0.568
m |  |  | Elektrolyser 2 Imon | DSO GNDOPN_V4P_V14P | i | - | EL_001 | P2G0 | 35 | MAX1238 | AIN3 | AI | Imon_2 |  | - |  |  | 0 | 4096 | 4.0960 | 0,05Ohm |  | 0.00 A | 7.00 A | 0.002 A |  | AD* (4,096/(4096)*(1/(1+(100/10)))*(1/0,05) | 0.001818
m |  |  | Messung O2 Druck Elektrolyser | AI_V0P_V5P | i | - | P_000 | P2G0 | 35 | MAX1238 | AIN4 | AI | PR0 |  | K32/3,2,1 | IN+,V5P, GND |  | 0 | 4096 | 4.0960 | 0V..5V | MPX5100 | 0 mbar | 1000 mbar | 0.244 mbar |  | AD* (4,096/4096)*(1/(4,99/5,99)) | 0.001200
m |  |  | Messung H2/CO2 Druck Elektrolyser | AI_V0P_V5P | i | - | P_001 | P2G0 | 35 | MAX1238 | AIN5 | AI | PR1 |  | K34/3,2,1 | IN+,V5P, GND |  | 0 | 4096 | 4.0960 | 0V..5V | MPX5100 | 0 mbar | 1000 mbar | 0.244 mbar |  | AD* (4,096/4096)*(1/(4,99/5,99)) | 0.001200
m |  |  | Messung O2 Druck O2-Speicher | AI_V0P_V5P | i | - | P_002 | P2G0 | 35 | MAX1238 | AIN7 | AI | CO2 |  | K41/3,2,1 | IN+,V5P, GND |  | 0 | 4096 | 4.0960 | 0V..5V | ? | 0.00 % | 20.00 % | 0.005 % |  | AD* (4,096/4096)*(1/(4,99/5,99)) | 0.001200
m |  |  | Messung H2/CO2 Druck H2/CO2-Speicher | AI_V0P_V5P | i | - | P_003 | P2G0 | 35 | MAX1238 | AIN6 | AI | PR2 |  | K36/3,2,1 | IN+,V5P, GND
m |  |  | Brennstoffzelle Umon | DSO_GNDOPN_5A0_UI | i | - | BZ_000 | P2G0 | 48 | AD7828 | CH2 | AI | VDD_3 |  | K10/1 |  |  | 0 | 4096 | 2.5000 |  |  | 0.00 V | 28.00 V | 0.011 V |  | AD* (2,500/4096)*(1/(2/22)) | 0.006714 | Jumper K50/2-4
m |  |  | Brennstoffzelle Imon | DSO_GNDOPN_5A0_UI | i | - | BZ_000 | P2G0 | 48 | AD7828 | CH7 | AI | Imon_3 |  | - |  |  | 0 | 4096 | 2.5000 |  |  | 0.00 A | 4.54 A | 0.001 A |  | AD* (2,500/(4096)*(1/(1+(100/10)))*(1/0,05) | 0.001110 | Jumper K50/1-3
m |  |  | Brennstoffzelle Switch | DSO_GNDOPN_5A0_UI | 0 | - | BZ_000 | P2G0 | 21 | PCF8575 | P07 | DSO_LS | - |  | K10/2 | OUT |  | on =0 | off=1 | -
m |  |  | ? | CVDI | i | - | ? | P2G0 | 21 | PCF8575 | P00 | DSI | PS1_H |  | K13/2,1 | IN+,V5P |  | close =0 | open=1 | -
m |  |  | ? | CVDI | i | - | ? | P2G0 | 21 | PCF8575 | P01 | DSI | PS1_L |  | K13/3,1 | IN+,V5P |  | close =0 | open=1 | -
m |  |  | ? | CVDI | i | - | ? | P2G0 | 21 | PCF8575 | P02 | DSI | PS2_H |  | K11/2,1 | IN+,V5P |  | close =0 | open=1 | -
m |  |  | ? | CVDI | i | - | ? | P2G0 | 21 | PCF8575 | P03 | DSI | PS2_L |  | K11/3l1 | IN+,V5P |  | close =0 | open=1 | -
m |  |  | Schalter SW 2 ST/SP (Option Software Start/Stop) | DSI_A | i | - | HS_000 | P2G0 | 21 | PCF8575 | P04 | DSI | ST_SP |  | K14/2,1,3 | IN+,V5P, GND | Paralle zu SW2 auf Platine | close =1 | open=0 | -
m |  |  | Raumtemperatur Platine P2G | I2C | b | - | T_000 | P2G0 | 4E | TMP100 | - | I2C | - |  | - | - |  | - | - | - |  | TMP100 | -55.0 C° | 125.0 C° | 0.5 C°
m |  |  | ? | DSO 24V_OPN | o | - | ? | P2G0 | 21 | PCF8575 | P17 | DSO_HS | - |  | K7/1 | OUT | 40V @ 10A (Achtung Kühlung) | on =0 | off=1 |  |  |  |  | 40V@10A |  |  |  |  | 40V @ 10A (Achtung Kühlung)
m |  |  | ? | DSO 24V_OPN | o | - | ? | P2G0 | 21 | PCF8575 | P15 | DSO_HS | - |  | K6/1 | OUT | 40V @ 10A (Achtung Kühlung) | on =0 | off=1 |  | 0V …0,04V |  |  | 40V@10A |  |  |  |  | 40V @ 10A (Achtung Kühlung)
m |  |  | Füllstandsensor O2 Wasserabscheider | AI_V0P_V2P5 | i | - | FL_000 | P2G0 | 48 | AD7828 | CH3 | AI | - |  | K48/2,1,5 | IN+,V5P, GND | Wasserabscheider high | 0 | 4096 | 2.5000
m |  |  | Füllstandsensor O2 Wasserabscheider | AI_V0P_V2P5 | i | - | FL_000 | P2G0 | 48 | AD7828 | CH4 | AI | - |  | K48/3,1,5 | IN+,V5P, GND | Wasserabscheider low | 0 | 4096 | 2.5000
m |  |  | Füllstandsensor H2 Wasserabscheider | AI_V0P_V2P5 | i | - | FL_001 | P2G0 | 48 | AD7828 | CH6 | AI | - |  | K47/2,1,5 | IN+,V5P, GND | Wasserabscheider high | 0 | 4096 | 2.5000
m |  |  | Füllstandsensor H2 Wasserabscheider | AI_V0P_V2P5 | i | - | FL_001 | P2G0 | 48 | AD7828 | CH5 | AI | - |  | K47/3,1,5 | IN+,V5P, GND | Wasserabscheider low | 0 | 4096 | 2.5000
m |  |  | Phase 0 Gassensor Mischverhältnis | USS | i | - | ? | P2G0 | 48 | AD7828 | CH0 | AI | PHASE_0 |  | -
m |  |  | Phase 1 Gassensor Mischverhältnis | USS | i | - | ? | P2G0 | 48 | AD7828 | CH1 | AI | PHASE_1 |  | -
m | y |  | Wasserabscheider O2 | DSO 24V_OPN | o | - | V2_000 | P2G0 | 21 | PCF8575 | P11 | DSO_HS | - | blau | K26/1 | OUT |  | on =0 | off=1 |  | 0V …40V |  |  |  |  |  | ? | ?
m | y |  | Zufluss zum H2-Speicher (nach Trockner zur Pumpe) | DSO 24V_OPN | o | - | V2_002 | P2G0 | 21 | PCF8575 | P12 | DSO_HS | - | gel/grün | K1/2 | OUT |  | on =0 | off=1 |  | 0V …40V |  |  |  |  |  | ? | ?
m | y |  | Zufluss zum O2-Speicher (nach Trockner zur Pumpe) | DSO 24V_OPN | o | - | V2_003 | P2G0 | 21 | PCF8575 | P13 | DSO_HS | - | schwarz | K1/1 | OUT |  | on =0 | off=1 |  | 0V …40V |  |  |  |  |  | ? | ?
m |  |  | Pumpe für H2, O2 Speicher | DSO 24V_OPN | o | - | PM_000 | P2G0 | 21 | PCF8575 | P14 | DSO_HS | - | orange | K6/2 | OUT |  | on =0 | off=1 |  | 0V …40V |  |  |  |  |  | ? | ?
m | y |  | Auslass O2-Speicher | DSO 24V_OPN | o | - | V2_005 | P2G0 | 21 | PCF8575 | P16 | DSO_HS | - | Weiß | K7/2 | OUT |  | on =0 | off=1 |  | 0V …40V |  |  |  |  |  | ? | ?
m | y |  | Wasserabscheider H2 | DSO 24V_OPN | o | - | V2_001 | P2G0 | 21 | PCF8575 | P10 | DSO_HS | - | grau | K26/2 | OUT |  | on =0 | off=1 |  | 0V …40V |  |  |  |  |  | ? | ?
m |  |  | Messung Ofentemperatur | CVAI | i | y | TH_000 | P2G0 | 35 | MAX1238 | AIN11 | AI | TH |  | K23/1,2,3,4 | GND, V5P, IN+, IN- | Konfig als TH mit Verstärkung _001
m |  |  | Messung CO2 Konzentration Syntheseprodukt (CH4) | CVAI | i | y | GK_000 | P2G0 | 35 | MAX1238 | AIN10 | AI | Spare1 |  | K40/1,2,3,4 | GND, V5P, IN+, IN- | Konfig als AI_V0P_V5P _002
m |  |  | Messung H2 Konzentration von Syntheseprodukt (CH4) | CVAI | i | y | GK_001 | P2G0 | 35 | MAX1238 | AIN9 | AI | Spare2 |  | K30/1,2,3,4 | GND, V5P, IN+, IN- | Konfig als AI_V0P_V5P _003
m |  |  | Messung CH4 Konzentration von Syntheseprodukt (CH4) | CVAI | i | y | GK_002 | P2G0 | 35 | MAX1238 | AIN8 | AI | Spare3 |  | K39/1,2,3,4 | GND, V5P, IN+, IN- | Konfig als AI_V0P_V5P _004
m |  |  | ? | DSO 24V_OPN | o | - | ? | STM0 | 26 | PCF8574 | P00 | DSO_HS |  |  | K9/1 | OUT
m | y |  | Zuflusseinstellung H2 nach Speicher zum Ofen (Steppermotor STP) | STP_1A0 | o | - | STM_000 | STM0 | 26 | PCF8574 | P01 | DIR |  |  | - |  | Steppermotor Richtung
m | y |  | Zuflusseinstellung H2 nach Speicher zum Ofen (Steppermotor STP) | STP_1A0 | o | - | STM_000 | STM0 | 26 | PCF8574 | P02 | STEP |  |  | - |  | Steppermotor Schritt
m | y |  | Zuflusseinstellung H2 nach Speicher zum Ofen (Steppermotor STP) | STP_1A0 | o | - | STM_000 | STM0 | 26 | PCF8574 | P03 | ENABLEn |  |  | - |  | Steppermotor Enable (active low)
m | y |  | Ventil Zufluß H2 nach Speicher zum Ofen | DSO 24V_OPN | o | - | V2_004 | STM0 | 26 | PCF8574 | P04 | DSO_HS |  |  | K9/2 | OUT
m | y |  | Zuflusseinstellung H2 nach Speicher zum Ofen (Steppermotor STP) | STP_1A0 | o | - | STM_000 | STM0 | 26 | PCF8574 | P05 | RESET |  |  | - |  | Steppermotor Reset (active high)
m | y |  | Zuflusseinstellung H2 nach Speicher zum Ofen (Steppermotor STP) | STP_1A0 | o | - | STM_000 | STM0 | 26 | PCF8574 | P06 | MS1n |  |  | - |  | Steppermotor MS1 (Schrittgröße)
m | y |  | Zuflusseinstellung H2 nach Speicher zum Ofen (Steppermotor STP) | STP_1A0 | o | - | STM_000 | STM0 | 26 | PCF8574 | P07 | MS0n |  |  | - |  | Steppermotor MS0 (Schrittgröße)
m | y |  | Zuflusseinstellung H2 nach Speicher zum Ofen (Steppermotor POT) | CVAI | i | - | STM_000 | STM0 | 4B | AD7828 | CH0 | OUT01 |  |  | K23/1,2,3,4 | GND,V5P,IN-,IN+ | Spannung Poti für Steppermotor Position | 0 | 4096 | 2.5000 | 0V …5V | Poti (5k) | 0.00 V | 5.00 V |  | k= 0,5
m |  |  | ? | AI_V0P_V5P | i | - | ? | STM0 | 4B | AD7828 | CH1 | AI |  |  | K15/1,2,3 | GND,V5P,IN |  | 0 | 4096 | 2.5000 | 0V …5V | Poti (5k) | 0.00 V | 5.00 V |  | k= 0,5
m |  |  | ? | AI_V0P_V5P | i | - | ? | STM0 | 4B | AD7828 | CH2 | AI |  |  | K32/1,2,3 | GND,V5P,IN |  | 0 | 4096 | 2.5000 | 0V …5V | Poti (5k) | 0.00 V | 5.00 V |  | k= 0,5
m |  |  | Versogungsspannung Steppermotor STM0 | AI_V0P_V5P | i | - | STM_000 | STM0 | 4B | AD7828 | CH3 | VDD4 |  |  | - | VDD_4 für STM | Versorgungsspannung für Steppermotor | 0 | 4096 | 2.5000 | 0V…32V | PSU |  |  |  | k = 0,07692
m |  |  | GND | connected to GND | i | - | - | STM0 | 4B | AD7828 | CH4 | GND | - |  | - | - |  | 0 | 4096 | 2.5000
m |  |  | GND | connected to GND | i | - | - | STM0 | 4B | AD7828 | CH5 | GND | - |  | - | - |  | 0 | 4096 | 2.5000
m |  |  | GND | connected to GND | i | - | - | STM0 | 4B | AD7828 | CH6 | GND | - |  | - | - |  | 0 | 4096 | 2.5000
m |  |  | GND | connected to GND | i | - | - | STM0 | 4B | AD7828 | CH7 | GND | - |  | - | - |  | 0 | 4096 | 2.5000
m | y |  | Zufluß CO2 on/off | DSO 24V_OPN | o | - | V2_007 | STM1 | 25 | PCF8574 | P00 | DSO_HS |  |  | K9/1 | OUT
m | y |  | Zuflusseinstellung CO2 (Steppermotor STP) | STP_1A0 | o | - | STM_001 | STM1 | 25 | PCF8574 | P01 | DIR |  |  | - |  | Steppermotor Richtung
m | y |  | Zuflusseinstellung CO2 (Steppermotor STP) | STP_1A0 | o | - | STM_001 | STM1 | 25 | PCF8574 | P02 | STEP |  |  | - |  | Steppermotor Schritt
m | y |  | Zuflusseinstellung CO2 (Steppermotor STP) | STP_1A0 | o | - | STM_001 | STM1 | 25 | PCF8574 | P03 | ENABLEn |  |  | - |  | Steppermotor Enable (active low)
m | y |  | Spülung CO2 oder Zumischung CO2 | DSO 24V_OPN | o | - | V3_000 | STM1 | 25 | PCF8574 | P04 | DSO_HS |  |  | K9/2 | OUT | 3 Wege-Ventil
m | y |  | Zuflusseinstellung CO2 (Steppermotor STP) | STP_1A0 | o | - | STM_001 | STM1 | 25 | PCF8574 | P05 | RESET |  |  | - |  | Steppermotor Reset (active high)
m | y |  | Zuflusseinstellung CO2 (Steppermotor STP) | STP_1A0 | o | - | STM_001 | STM1 | 25 | PCF8574 | P06 | MS1n |  |  | - |  | Steppermotor MS0 (Schrittgröße)
m | y |  | Zuflusseinstellung CO2 (Steppermotor STP) | STP_1A0 | o | - | STM_001 | STM1 | 25 | PCF8574 | P07 | MS0n |  |  | - |  | Steppermotor MS0 (Schrittgröße)
m | y |  | Zuflusseinstellung CO2 (Steppermotor POT) | CVAI | i | - | STM_001 | STM1 | 4A | AD7828 | CH0 | OUT01 |  |  | K23/1,2,3,4 | GND,V5P,IN-,IN+ | Spannung Poti für Steppermotor Position | 0 | 4096 | 2.5000 | 0V …5V | Poti (5k) | 0.00 V | 5.00 V |  | k= 0,5
m |  |  | Messung Druck CO2 | AI_V0P_V5P | i | - | P_004 | STM1 | 4A | AD7828 | CH1 | AI |  |  | K15/1,2,3 | GND,V5P,IN |  | 0 | 4096 | 2.5000 | 0V …5V | Poti (5k) | 0.00 V | 5.00 V |  | k= 0,5
m |  |  | Messung CO2 Konzentration von Gemisch CO2, H2 | AI_V0P_V5P | i | - | GK_004 | STM1 | 4A | AD7828 | CH2 | AI |  |  | K32/1,2,3 | GND,V5P,IN |  | 0 | 4096 | 2.5000 | 0V …5V | Poti (5k) | 0.00 V | 5.00 V |  | k= 0,5
m | y |  | Zuflusseinstellung CO2 (Steppermotor STP, POT) | AI_V0P_V5P | i | - | STM_001 | STM1 | 4A | AD7828 | CH3 | VDD4 |  |  | - | VDD_4 für STM | Versorgungsspannung für Steppermotor | 0 | 4096 | 2.5000 | 0V…32V | PSU |  |  |  | k = 0,07692
m |  |  | GND | connected to GND | i | - | - | STM1 | 4A | AD7828 | CH4 | GND | - |  | - | - |  | 0 | 4096 | 2.5000
m |  |  | GND | connected to GND | i | - | - | STM1 | 4A | AD7828 | CH5 | GND | - |  | - | - |  | 0 | 4096 | 2.5000
m |  |  | GND | connected to GND | i | - | - | STM1 | 4A | AD7828 | CH6 | GND | - |  | - | - |  | 0 | 4096 | 2.5000
m |  |  | GND | connected to GND | i | - | - | STM1 | 4A | AD7828 | CH7 | GND | - |  | - | - |  | 0 | 4096 | 2.5000
gs |  |  | ? | DSO 24V_OPN | o | - | ? | STM2 | 20 | PCF8574 | P00 | DSO_HS |  |  | K9/1 | OUT
gs |  |  | Regelung Zufluss CH4, Butan zum Motor | STP_1A0 | o | - | STM_200 | STM2 | 20 | PCF8574 | P01 | DIR |  |  | - |  | Steppermotor Richtung
gs |  |  | Regelung Zufluss CH4, Butan zum Motor | STP_1A0 | o | - | STM_200 | STM2 | 20 | PCF8574 | P02 | STEP |  |  | - |  | Steppermotor Schritt
gs |  |  | Regelung Zufluss CH4, Butan zum Motor | STP_1A0 | o | - | STM_200 | STM2 | 20 | PCF8574 | P03 | ENABLEn |  |  | - |  | Steppermotor Enable (active low)
gs |  |  | ? | DSO 24V_OPN | o | - | ? | STM2 | 20 | PCF8574 | P04 | DSO_HS |  |  | K9/2 | OUT
gs |  |  | Regelung Zufluss CH4, Butan zum Motor | STP_1A0 | o | - | STM_200 | STM2 | 20 | PCF8574 | P05 | RESET |  |  | - |  | Steppermotor Reset (active high)
gs |  |  | Regelung Zufluss CH4, Butan zum Motor | STP_1A0 | o | - | STM_200 | STM2 | 20 | PCF8574 | P06 | MS1n |  |  | - |  | Steppermotor MS0 (Schrittgröße)
gs |  |  | Regelung Zufluss CH4, Butan zum Motor | STP_1A0 | o | - | STM_200 | STM2 | 20 | PCF8574 | P07 | MS0n |  |  | - |  | Steppermotor MS0 (Schrittgröße)
gs |  |  | Regelung Zufluss CH4, Butan zum Motor | CVAI | i | - | STM_200 | STM2 | 4B | AD7828 | CH0 | OUT01 |  |  | K23/1,2,3,4 | GND,V5P,IN-,IN+ | Spannung Poti für Steppermotor Position | 0 | 4096 | 2.5000 | 0V …5V | Poti (5k) | 0.00 V | 5.00 V |  | k= 0,5
gs |  |  | ? | AI_V0P_V5P | i | - | ? | STM2 | 4B | AD7828 | CH1 | AI |  |  | K15/1,2,3 | GND,V5P,IN |  | 0 | 4096 | 2.5000 | 0V …5V | Poti (5k) | 0.00 V | 5.00 V |  | k= 0,5
gs |  |  | ? | AI_V0P_V5P | i | - | ? | STM2 | 4B | AD7828 | CH2 | AI |  |  | K32/1,2,3 | GND,V5P,IN |  | 0 | 4096 | 2.5000 | 0V …5V | Poti (5k) | 0.00 V | 5.00 V |  | k= 0,5
gs |  |  | Regelung Zufluss CH4, Butan zum Motor | AI_V0P_V5P | i | - | STM_200 | STM2 | 4B | AD7828 | CH3 | VDD4 |  |  | - | VDD_4 für STM | Versorgungsspannung für Steppermotor | 0 | 4096 | 2.5000 | 0V…32V | PSU |  |  |  | k = 0,07692
gs |  |  | GND | connected to GND | i | - | - | STM2 | 4B | AD7828 | CH4 | GND | - |  | - | - |  | 0 | 4096 | 2.5000
gs |  |  | GND | connected to GND | i | - | - | STM2 | 4B | AD7828 | CH5 | GND | - |  | - | - |  | 0 | 4096 | 2.5000
gs |  |  | GND | connected to GND | i | - | - | STM2 | 4B | AD7828 | CH6 | GND | - |  | - | - |  | 0 | 4096 | 2.5000
gs |  |  | GND | connected to GND | i | - | - | STM2 | 4B | AD7828 | CH7 | GND | - |  | - | - |  | 0 | 4096 | 2.5000
m |  |  | Steuerung Lüfter für Kühler | DSI_&_DSO_HS_OPN_xxxxxx | b | - | L_000 | PSW0 | 21 | PCF8575 | P00 | DSI/DSO | PS1_H |  | K13/2,1 ; K1/1 | IN+,V5P, OUT ( 12V, VIO, VIN) | DSI und HS-Switch ohne Monitor U,I | on =0 | off=1
 |  |  | ? | DSI_&_DSO_HS_OPN_xxxxxx | b | - | ? | PSW0 | 21 | PCF8575 | P01 | DSI/DSO | PS1_L |  | K13/3,1 ; K26/1 | IN+,V5P, OUT ( 12V, VIO, VIN) | DSI und HS-Switch ohne Monitor U,I | on =0 | off=1
 |  |  | ? | DSI_&_DSO_HS_OPN_xxxxxx | b | - | ? | PSW0 | 21 | PCF8575 | P02 | DSI/DSO | PS2_H |  | K11/2,1 ; K1/2 | IN+,V5P, OUT ( 12V, VIO, VIN) | DSI und HS-Switch ohne Monitor U,I | on =0 | off=1
 |  |  | ? | DSI_&_DSO_HS_OPN_xxxxxx | b | - | ? | PSW0 | 21 | PCF8575 | P03 | DSI/DSO | PS2_L |  | K11/3,1, ; K26/2 | IN+,V5P, OUT ( 12V, VIO, VIN) | DSI und HS-Switch ohne Monitor U,I | on =0 | off=1
 |  |  | ? | DSI_A_&_DSO_GNDOPN_xxxxxx | b | - | ? | PSW0 | 21 | PCF8575 | P04 | DSI/DSO | ST_SP |  | K14/2,1,3; K52/2; K52/1 | IN+,V5P, GND, OUT, (V_IO1) | DSI und LS-Switch ohne Monitor U,I | on =0 | off=1
m |  |  | Ofensteuerung ( Switch) | DSO_GNDOPN_10A0 | o | - | OS_000 | PSW0 | 21 | PCF8575 | P05 | DSO |  |  | K8/2,1 | OUT, V_IO | LS-Switch I Monitor TBD da 10A output | on =0 | off=1
m |  |  | Steuerung Peltierelemente 1 und 2 (in Serie geschaltet) | DSO_GNDOPN_10A0 | o | - | PE_000 | PSW0 | 21 | PCF8575 | P06 | DSO |  |  | K42/2,1 | OUT, V_IO | LS-Switch I Monitor TBD da 10A output | on =0 | off=1
 |  |  | ? | DSO_GNDOPN_10A0 | o | - | ? | PSW0 | 21 | PCF8575 | P07 | DSO |  |  | K43/2,1 | OUT, V_IO | LS-Switch I Monitor TBD da 10A output | on =0 | off=1
 |  |  | ? | DSO_GNDOPN_10A0 | o | - | ? | PSW0 | 21 | PCF8575 | P10 | DSO |  |  | K44/2,1 | OUT, V_IO | LS-Switch I Monitor TBD da 10A output | on =0 | off=1
m |  |  | Wasserabscheider Kühler Syntheseprodukt (CH4) Switch | DSO_GNDOPN_5A0_I | o | - | V2_006 | PSW0 | 21 | PCF8575 | P11 | DSO |  |  | K45/2,1 | OUT, V_IO | LS-Switch I Monitor | on =0 | off=1
 |  |  | ? | DSO_GNDOPN_5A0_I | o | - | ? | PSW0 | 21 | PCF8575 | P12 | DSO |  |  | K46/2,1 | OUT, V_IO | LS-Switch I Monitor | on =0 | off=1
 |  |  | ? | DSO_GNDOPN_5A0_I | o | - | ? | PSW0 | 21 | PCF8575 | P13 | DSO |  |  | K47/2,1 | OUT, V_IO | LS-Switch I Monitor | on =0 | off=1
 |  |  | ? | DSO_GNDOPN_5A0_I | o | - | ? | PSW0 | 21 | PCF8575 | P14 | DSO |  |  | K48/2,1 | OUT, V_IO1 | LS-Switch I Monitor | on =0 | off=1
 |  |  | ? | DSO_GNDOPN_5A0_I | o | - | ? | PSW0 | 21 | PCF8575 | P15 | DSO |  |  | K49/2,1 | OUT, V_IO1 | LS-Switch I Monitor | on =0 | off=1
 |  |  | ? | DSO_GNDOPN_5A0_I | o | - | ? | PSW0 | 21 | PCF8575 | P16 | DSO |  |  | K50/2,1 | OUT, V_IO1 | LS-Switch I Monitor | on =0 | off=1
 |  |  | ? | DSO_GNDOPN_5A0_I | o | - | ? | PSW0 | 21 | PCF8575 | P17 | DSO |  |  | K51/2,1 | OUT, V_IO1 | LS-Switch I Monitor | on =0 | off=1
m |  |  | Ofensteuerung ( Switch) | Imon | i | - | OS_000 | PSW0 | 35 | MAx1238 | CH0 | AI | P05_Imon |  | - |  |  | 0 | 4096 | 4.0960 | 0V..5V |  |  |  |  | k=11
m |  |  | Steuerung Peltierelemente 1 und 2 (in Serie geschaltet) | Imon | i | - | PE_000 | PSW0 | 35 | MAx1238 | CH1 | AI | P06_Imon |  | - |  |  | 0 | 4096 | 4.0960 | 0V..5V |  |  |  |  | k=11
 |  |  | ? | Imon | i | - | ? | PSW0 | 35 | MAx1238 | CH2 | AI | P07_Imon |  | - |  |  | 0 | 4096 | 4.0960 | 0V..5V |  |  |  |  | k=11
 |  |  | ? | Imon | i | - | ? | PSW0 | 35 | MAx1238 | CH3 | AI | P10_Imon |  | - |  |  | 0 | 4096 | 4.0960 | 0V..5V |  |  |  |  | k=11
m |  |  | Wasserabscheider Kühler Syntheseprodukt (CH4) Imon | Imon | i | - | V2_006 | PSW0 | 35 | MAx1238 | CH4 | AI | P11_Imon |  | - |  |  | 0 | 4096 | 4.0960 | 0V..5V |  |  |  |  | k=11
 |  |  | ? | Imon | i | - | ? | PSW0 | 35 | MAx1238 | CH5 | AI | P12_Imon |  | - |  |  | 0 | 4096 | 4.0960 | 0V..5V |  |  |  |  | k=11
 |  |  | ? | Imon | i | - | ? | PSW0 | 35 | MAx1238 | CH6 | AI | P13_Imon |  | - |  |  | 0 | 4096 | 4.0960 | 0V..5V |  |  |  |  | k=11
 |  |  | ? | Imon | i | - | ? | PSW0 | 35 | MAx1238 | CH7 | AI | P14_Imon |  | - |  |  | 0 | 4096 | 4.0960 | 0V..5V |  |  |  |  | k=11
 |  |  | ? | Imon | i | - | ? | PSW0 | 35 | MAx1238 | CH8 | AI | P15_Imon |  | - |  |  | 0 | 4096 | 4.0960 | 0V..5V |  |  |  |  | k=11
 |  |  | ? | Imon | i | - | ? | PSW0 | 35 | MAx1238 | CH9 | AI | P16_Imon |  | - |  |  | 0 | 4096 | 4.0960 | 0V..5V |  |  |  |  | k=11
 |  |  | ? | Imon | i | - | ? | PSW0 | 35 | MAx1238 | CH10 | AI | P17_Imon |  | - |  |  | 0 | 4096 | 4.0960 | 0V..5V |  |  |  |  | k=11
 |  |  | ? | Umon | i | - | ? | PSW0 | 35 | MAx1238 | CH11 | AI | V_IO_Umon |  | - | gemessen gegen GND_1 |  | 0 | 4096 | 4.0960 | 0V..32V |  |  |  |  | k=1/11
m |  |  | Raumtemperatur Platine PSW0 | I2C | b | - | T_001 | PSW0 | 4E | TMP100 | - | I2C | - |  | - | - |  | - | - | - |  | TMP100 | -55.0 C° | 125.0 C° | 0.5 C°
m |  |  | Füllstandsensor Syntheseprodukt (CH4) Wasserabscheider | AI_V0P_V5P | i | - | FL_002 | PSW0 | 35 | MAX1238 | AIN1 | AI | AIN_1 |  | K54/1,2,5 | V5P, IN+, GND | Wasserabscheider high | 0 | 4096 | 4.0960 | 0V..5V
 |  |  | Strommonitor für für V_IO auf PSW-Platine | internal use | i |  | internal use | PSW0 | 35 | MAX1238 | AIN0 | AI | Imon_V_IO |  | - | Strommonitor für Versorgung V_IO | 0A…10A | 0 | 4096 | 4.0960 | 0V..5V
m |  |  | Füllstandsensor Syntheseprodukt (CH4) Wasserabscheider | AI_V0P_V5P | i | - | FL_002 | PSW0 | 35 | MAX1238 | AIN2 | AI | AIN_2 |  | K54/1,3,5 | V5P, IN+, GND | Wasserabscheider low | 0 | 4096 | 4.0960 | 0V..5V
 |  |  | not used, da Füllstandsensor angeschlossen auf dem Stecker | internal use | i |  | internal use | PSW0 | 35 | MAX1238 | AIN3 | AI | V5P |  | - | - | for internal use V5P/2 for Offest shift ACS72 LL10AB | 0 | 4096 | 4.0960 | 0V..5V
 |  |  | ? | AI_V0P_V5P | i |  | ? | PSW0 | 35 | MAX1238 | AIN4 | AI | PR0 |  | K32/3,2,1 | IN+,V5P, GND |  | 0 | 4096 | 4.0960 | 0V..5V
 |  |  | ? | AI_V0P_V5P | i |  | ? | PSW0 | 35 | MAX1238 | AIN5 | AI | PR1 |  | K34/3,2,1 | IN+,V5P, GND |  | 0 | 4096 | 4.0960 | 0V..5V
 |  |  | ? | AI_V0P_V5P | i |  | ? | PSW0 | 35 | MAX1238 | AIN7 | AI | PR3 |  | K41/3,2,1 | IN+,V5P, GND |  | 0 | 4096 | 4.0960 | 0V..5V
 |  |  | ? | AI_V0P_V5P | i |  | ? | PSW0 | 35 | MAX1238 | AIN6 | AI | PR2 |  | K36/3,2,1 | IN+,V5P, GND |  | 0 | 4096 | 4.0960 | 0V..5V
 |  |  | ? | CVAI | i | y | ? | PSW0 | 35 | MAX1238 | AIN11 | CVAI |  |  | K23/1,2,3,4 | GND, V5P, IN+, IN- | _001 | 0 | 4096 | 4.0960 | 0V..5V
 |  |  | ? | CVAI | i | y | ? | PSW0 | 35 | MAX1238 | AIN10 | CVAI |  |  | K40/1,2,3,4 | GND, V5P, IN+, IN- | _002 | 0 | 4096 | 4.0960 | 0V..5V
 |  |  | ? | CVAI | i | y | ? | PSW0 | 35 | MAX1238 | AIN9 | CVAI |  |  | K30/1,2,3,4 | GND, V5P, IN+, IN- | _003 | 0 | 4096 | 4.0960 | 0V..5V
 |  |  | ? | CVAI | i | y | ? | PSW0 | 35 | MAX1238 | AIN8 | CVAI |  |  | K39/1,2,3,4 | GND, V5P, IN+, IN- | _004 | 0 | 4096 | 4.0960 | 0V..5V
gs |  |  | ? | DSI_&_DSO_HS_OPN_xxxxxx | b | - | ? | PSW1 | 21 | PCF8575 | P00 | DSI/DSO | PS1_H |  | K13/2,1 ; K1/1 | IN+,V5P, OUT ( 12V, VIO, VIN) | DSI und HS-Switch ohne Monitor U,I | on =0 | off=1
gs |  |  | ? | DSI_&_DSO_HS_OPN_xxxxxx | b | - | ? | PSW1 | 21 | PCF8575 | P01 | DSI/DSO | PS1_L |  | K13/3,1 ; K26/1 | IN+,V5P, OUT ( 12V, VIO, VIN) | DSI und HS-Switch ohne Monitor U,I | on =0 | off=1
gs |  |  | ? | DSI_&_DSO_HS_OPN_xxxxxx | b | - | ? | PSW1 | 21 | PCF8575 | P02 | DSI/DSO | PS2_H |  | K11/2,1 ; K1/2 | IN+,V5P, OUT ( 12V, VIO, VIN) | DSI und HS-Switch ohne Monitor U,I | on =0 | off=1
gs |  |  | ? | DSI_&_DSO_HS_OPN_xxxxxx | b | - | ? | PSW1 | 21 | PCF8575 | P03 | DSI/DSO | PS2_L |  | K11/3,1, ; K26/2 | IN+,V5P, OUT ( 12V, VIO, VIN) | DSI und HS-Switch ohne Monitor U,I | on =0 | off=1
gs |  |  | Schalter Softwarehalt | DSI_A_&_DSO_GNDOPN_xxxxxx | b | - | HS_200 | PSW1 | 21 | PCF8575 | P04 | DSI/DSO | ST_SP |  | K14/2,1,3; K52/2; K52/1 | IN+,V5P, GND, OUT (V_IO1) | DSI und LS-Switch ohne Monitor U,I | on =0 | off=1
gs |  |  | Speicher CH4 Zuleitung Methanisierung | DSO_GNDOPN_5A0_I | o | - | V2_100 | PSW1 | 21 | PCF8575 | P05 | DSO |  |  | K8/2,1 | OUT, V_IO | LS-Switch I Monitor | on =0 | off=1
gs |  |  | Speicher CH4 Zuleitung Power to Gas P2G | DSO_GNDOPN_5A0_I | o | - | V2_101 | PSW1 | 21 | PCF8575 | P06 | DSO |  |  | K42/2,1 | OUT, V_IO | LS-Switch I Monitor | on =0 | off=1
gs |  |  | Absperrventil Druckerzeiger zu CH4 Speicher | DSO_GNDOPN_5A0_I | o | - | V2_103 | PSW1 | 21 | PCF8575 | P07 | DSO |  |  | K43/2,1 | OUT, V_IO | LS-Switch I Monitor | on =0 | off=1
gs |  |  | Steuerung CH4 Zuleitung Motor | DSO_GNDOPN_5A0_I | o | - | V2_200 | PSW1 | 21 | PCF8575 | P10 | DSO |  |  | K44/2,1 | OUT, V_IO | LS-Switch I Monitor | on =0 | off=1
gs |  |  | Steuerung Butan Zuleitung Motor | DSO_GNDOPN_5A0_I | o | - | V2_201 | PSW1 | 21 | PCF8575 | P11 | DSO |  |  | K45/2,1 | OUT, V_IO | LS-Switch I Monitor | on =0 | off=1
gs |  |  | Auslassventil CH4 Speicher zu Druckregler | DSO_GNDOPN_5A0_I | o | - | V2_104 | PSW1 | 21 | PCF8575 | P12 | DSO |  |  | K46/2,1 | OUT, V_IO | LS-Switch I Monitor | on =0 | off=1
gs |  |  | ? | DSO_GNDOPN_5A0_I | o | - | ? | PSW1 | 21 | PCF8575 | P13 | DSO |  |  | K47/2,1 | OUT, V_IO | LS-Switch I Monitor | on =0 | off=1
gs |  |  | ? | DSO_GNDOPN_5A0_I | o | - | ? | PSW1 | 21 | PCF8575 | P14 | DSO |  |  | K48/2,1 | OUT, V_IO1 | LS-Switch I Monitor | on =0 | off=1
gs |  |  | ? | DSO_GNDOPN_5A0_I | o | - | ? | PSW1 | 21 | PCF8575 | P15 | DSO |  |  | K49/2,1 | OUT, V_IO1 | LS-Switch I Monitor | on =0 | off=1
gs |  |  | ? | DSO_GNDOPN_5A0_I | o | - | ? | PSW1 | 21 | PCF8575 | P16 | DSO |  |  | K50/2,1 | OUT, V_IO1 | LS-Switch I Monitor | on =0 | off=1
gs |  |  | ? | DSO_GNDOPN_5A0_I | o | - | ? | PSW1 | 21 | PCF8575 | P17 | DSO |  |  | K51/2,1 | OUT, V_IO1 | LS-Switch I Monitor | on =0 | off=1
gs |  |  | Speicher CH4 Zuleitung Methanisierung | Imon | i | - | V2_100 | PSW1 | 35 | MAx1238 | CH0 | AI | P05_Imon |  | - |  |  | 0 | 4096 | 4.0960 | 0V..5V |  |  |  |  | k=11
gs |  |  | Speicher CH4 Zuleitung Power to Gas P2G | Imon | i | - | V2_101 | PSW1 | 35 | MAx1238 | CH1 | AI | P06_Imon |  | - |  |  | 0 | 4096 | 4.0960 | 0V..5V |  |  |  |  | k=11
gs |  |  | Absperrventil Druckerzeiger zu CH4 Speicher | Imon | i | - | V2_103 | PSW1 | 35 | MAx1238 | CH2 | AI | P07_Imon |  | - |  |  | 0 | 4096 | 4.0960 | 0V..5V |  |  |  |  | k=11
gs |  |  | Steuerung CH4 Zuleitung Motor | Imon | i | - | V2_200 | PSW1 | 35 | MAx1238 | CH3 | AI | P10_Imon |  | - |  |  | 0 | 4096 | 4.0960 | 0V..5V |  |  |  |  | k=11
gs |  |  | Steuerung Butan Zuleitung Motor | Imon | i | - | V2_201 | PSW1 | 35 | MAx1238 | CH4 | AI | P11_Imon |  | - |  |  | 0 | 4096 | 4.0960 | 0V..5V |  |  |  |  | k=11
gs |  |  | Auslassventil CH4 Speicher zu Druckregler | Imon | i | - | V2_104 | PSW1 | 35 | MAx1238 | CH5 | AI | P12_Imon |  | - |  |  | 0 | 4096 | 4.0960 | 0V..5V |  |  |  |  | k=11
 |  |  | ? | Imon | i | - | ? | PSW1 | 35 | MAx1238 | CH6 | AI | P13_Imon |  | - |  |  | 0 | 4096 | 4.0960 | 0V..5V |  |  |  |  | k=11
 |  |  | ? | Imon | i | - | ? | PSW1 | 35 | MAx1238 | CH7 | AI | P14_Imon |  | - |  |  | 0 | 4096 | 4.0960 | 0V..5V |  |  |  |  | k=11
 |  |  | ? | Imon | i | - | ? | PSW1 | 35 | MAx1238 | CH8 | AI | P15_Imon |  | - |  |  | 0 | 4096 | 4.0960 | 0V..5V |  |  |  |  | k=11
 |  |  | ? | Imon | i | - | ? | PSW1 | 35 | MAx1238 | CH9 | AI | P16_Imon |  | - |  |  | 0 | 4096 | 4.0960 | 0V..5V |  |  |  |  | k=11
 |  |  | ? | Imon | i | - | ? | PSW1 | 35 | MAx1238 | CH10 | AI | P17_Imon |  | - |  |  | 0 | 4096 | 4.0960 | 0V..5V |  |  |  |  | k=11
 |  |  | ? | Umon | i | - | ? | PSW1 | 35 | MAx1238 | CH11 | AI | V_IO_Umon |  | - | gemessen gegen GND_1 |  | 0 | 4096 | 4.0960 | 0V..32V |  |  |  |  | k=1/11
gs |  |  | Raumtemperatur Platine PSW1 | I2C | b | - | T_200 | PSW1 | 4E | TMP100 | - | I2C | - |  | - | - |  | - | - | - |  | TMP100 | -55.0 C° | 125.0 C° | 0.5 C°
gs |  |  | Füllstandsensor Verdichter Wassersnad | AI_V0P_V5P | i |  | FL_100 | PSW1 | 35 | MAX1238 | AIN1 | AI | AIN_1 |  | K54/1,2,5 | V5P, IN+, GND |  | 0 | 4096 | 4.0960 | 0V..5V
gs |  |  | Strommonitor für für V_IO auf PSW-Platine | internal use | i |  | internal use | PSW1 | 35 | MAX1238 | AIN0 | AI | Imon_V_IO |  | - | Strommonitor für Versorgiung V_IO | 0A…10A | 0 | 4096 | 4.0960 | 0V..5V
gs |  |  | Füllstandsensor Verdichter Wassersnad | AI_V0P_V5P | i |  | FL_100 | PSW1 | 35 | MAX1238 | AIN2 | AI | AIN_2 |  | K54/1,3,5 | V5P, IN+, GND |  | 0 | 4096 | 4.0960 | 0V..5V
gs |  |  | not used, da Füllstandsensor angeschlossen auf dem Stecker | internal use | i |  | internal use | PSW1 | 35 | MAX1238 | AIN3 | AI | V5P |  | - | - | for internal use V5P/2 for Offest shift ACS72 LL10AB | 0 | 4096 | 4.0960 | 0V..5V
gs |  |  | Druck Zufluss CH4, Butan zum Motor | AI_V0P_V5P | i |  | P_200 | PSW1 | 35 | MAX1238 | AIN4 | AI | PR0 |  | K32/3,2,1 | IN+,V5P, GND |  | 0 | 4096 | 4.0960 | 0V..5V
gs |  |  | Druckmesser CH4 Druckerzeuger | AI_V0P_V5P | i |  | P_100 | PSW1 | 35 | MAX1238 | AIN5 | AI | PR1 |  | K34/3,2,1 | IN+,V5P, GND |  | 0 | 4096 | 4.0960 | 0V..5V
gs |  |  | Druckmesser CH4 Speicher | AI_V0P_V5P | i |  | P_101 | PSW1 | 35 | MAX1238 | AIN7 | AI | PR3 |  | K41/3,2,1 | IN+,V5P, GND |  | 0 | 4096 | 4.0960 | 0V..5V
 |  |  | ? | AI_V0P_V5P | i |  | ? | PSW1 | 35 | MAX1238 | AIN6 | AI | PR2 |  | K36/3,2,1 | IN+,V5P, GND |  | 0 | 4096 | 4.0960 | 0V..5V
 |  |  | ? | CVAI | i | y | ? | PSW1 | 35 | MAX1238 | AIN11 | CVAI |  |  | K23/1,2,3,4 | GND, V5P, IN+, IN- | _001 | 0 | 4096 | 4.0960 | 0V..5V
 |  |  | ? | CVAI | i | y | ? | PSW1 | 35 | MAX1238 | AIN10 | CVAI |  |  | K40/1,2,3,4 | GND, V5P, IN+, IN- | _002 | 0 | 4096 | 4.0960 | 0V..5V
 |  |  | ? | CVAI | i | y | ? | PSW1 | 35 | MAX1238 | AIN9 | CVAI |  |  | K30/1,2,3,4 | GND, V5P, IN+, IN- | _003 | 0 | 4096 | 4.0960 | 0V..5V
 |  |  | ? | CVAI | i | y | ? | PSW1 | 35 | MAX1238 | AIN8 | CVAI |  |  | K39/1,2,3,4 | GND, V5P, IN+, IN- | _004 | 0 | 4096 | 4.0960 | 0V..5V
gs |  |  | Ansterung Schwingkolbenpumpe | 220VAC_SW | o | n | SK_100 | ASP1 | ? | PCF8574 | P00 | DSO
gs |  |  | not used and not connected (pullup) | not used | - | n | not connected | ASP1 | ? | PCF8574 | P01 | DSO
gs |  |  | not used and not connected (pullup) | not used | - | n | not connected | ASP1 | ? | PCF8574 | P02 | DSO
gs |  |  | not used and not connected (pullup) | not used | - | n | not connected | ASP1 | ? | PCF8574 | P03 | DSO
gs |  |  | not used and not connected (pullup) | not used | - | n | not connected | ASP1 | ? | PCF8574 | P04 | DSO
gs |  |  | not used and not connected (pullup) | not used | - | n | not connected | ASP1 | ? | PCF8574 | P05 | DSO
gs |  |  | not used and not connected (pullup) | not used | - | n | not connected | ASP1 | ? | PCF8574 | P06 | DSO
gs |  |  | not used and not connected (pullup) | not used | - | n | not connected | ASP1 | ? | PCF8574 | P07 | DSO
x |  |  | Anschlüsse Interface z.B. Motoren | x |  | x | x | x | x | x | x | x | x |  | x | x | x | x | x | x | x | x | x | x | x |  | x | x | x
m |  |  | Steppermotoranschluß STM0 | Anschluss | o |  | STM_000 | STM0 | - |  |  |  |  |  | K4/1,2,3,4 | OAM,OBM,OAP,OBP | Steppermotor- Anschluss | 00 HEX
m |  |  | Steppermotoranschluß STM1 | Anschluss | o |  | STM_001 | STM1 | - |  |  |  |  |  | K4/1,2,3,4 | OAM,OBM,OAP,OBP | Steppermotor- Anschluss | 00 HEX
gs |  |  | Steppermotoranschluß STM2 | Anschluss | o |  | STM_200 | STM2 | - |  |  |  |  |  | K4/1,2,3,4 | OAM,OBM,OAP,OBP | Steppermotor- Anschluss | 00 HEX
x |  |  | Allgemeine Systemfunktionen | x |  | x | x | x | x | x | x | x | x |  | x | x | x | x | x | x | x | x | x | x | x |  | x | x | x
m |  |  | Umschaltung I2C Bussysteme | I2C_MUX | b | - | internal | P2G0 | 70 | PCA9545 | - | I2C | - |  | - |  | I2C-BUS_0…3 off | 00 HEX
m |  |  | Umschaltung I2C Bussysteme | I2C_MUX | b | - | internal | P2G0 | 70 | PCA9545 | SCL0,SDA0 | I2C | I2C_Bus_0 |  | K12 |  | I2C-BUS_0 on | 01 HEX
m |  |  | Umschaltung I2C Bussysteme | I2C_MUX | b | - | internal | P2G0 | 70 | PCA9545 | SCL1,SDA1 | I2C | I2C_Bus_1 |  | K15 |  | I2C-BUS_1 on | 02 HEX
m |  |  | Umschaltung I2C Bussysteme | I2C_MUX | b | - | internal | P2G0 | 70 | PCA9545 | SCL2,SDA2 | I2C | I2C_Bus_2 |  | K16 |  | I2C-BUS_2 on | 04 HEX
m |  |  | Umschaltung I2C Bussysteme | I2C_MUX | b | - | internal | P2G0 | 70 | PCA9545 | SCL3,SDA3 | I2C | I2C_Bus_3 |  | K17 |  | I2C-BUS_3 on | 08 HEX
m |  |  | Umschaltung I2C Bussysteme | I2C_MUX | b | - | internal | PSW0 | 71 | PCA9545 |  | I2C | - |  | - |  | I2C-BUS_0…3 off | 00 HEX
m |  |  | Umschaltung I2C Bussysteme | I2C_MUX | b | - | internal | PSW0 | 71 | PCA9545 | SCL0,SDA0 | I2C | I2C_Bus_0 |  | K12 |  | I2C-BUS_0 on | 01 HEX
m |  |  | Umschaltung I2C Bussysteme | I2C_MUX | b | - | internal | PSW0 | 71 | PCA9545 | SCL1,SDA1 | I2C | I2C_Bus_1 |  | K15 |  | I2C-BUS_1 on | 02 HEX
m |  |  | Umschaltung I2C Bussysteme | I2C_MUX | b | - | internal | PSW0 | 71 | PCA9545 | SCL2,SDA2 | I2C | I2C_Bus_2 |  | K16 |  | I2C-BUS_2 on | 04 HEX
m |  |  | Umschaltung I2C Bussysteme | I2C_MUX | b | - | internal | PSW0 | 71 | PCA9545 | SCL3,SDA3 | I2C | I2C_Bus_3 |  | K17 |  | I2C-BUS_3 on | 08 HEX
gs |  |  | Umschaltung I2C Bussysteme | I2C_MUX | b | - | internal | PSW1 | 71 | PCA9545 | - | I2C | - |  | - |  | I2C-BUS_0…3 off | 00 HEX
gs |  |  | Umschaltung I2C Bussysteme | I2C_MUX | b | - | internal | PSW1 | 71 | PCA9545 | SCL0,SDA0 | I2C | I2C_Bus_0 |  | K12 |  | I2C-BUS_0 on | 01 HEX
gs |  |  | Umschaltung I2C Bussysteme | I2C_MUX | b | - | internal | PSW1 | 71 | PCA9545 | SCL1,SDA1 | I2C | I2C_Bus_1 |  | K15 |  | I2C-BUS_1 on | 02 HEX
gs |  |  | Umschaltung I2C Bussysteme | I2C_MUX | b | - | internal | PSW1 | 71 | PCA9545 | SCL2,SDA2 | I2C | I2C_Bus_2 |  | K16 |  | I2C-BUS_2 on | 04 HEX
gs |  |  | Umschaltung I2C Bussysteme | I2C_MUX | b | - | internal | PSW1 | 71 | PCA9545 | SCL3,SDA3 | I2C | I2C_Bus_3 |  | K17 |  | I2C-BUS_3 on | 08 HEX
x |  |  | Initialisierungen | x |  | x | x | x | x | x | x | x | x |  | x | x | x | x | x | x | x | x | x | x | x |  | x | x | x
m |  |  | Offset Messung Ofentemperatur | INIT_CVAI | b | x | TH_000 | P2G0 | 10 | MAX5815 | OUT_A | I2C | - |  | - | - | Offset für CVAI-Interface _001 | 0
m |  |  | Offset Messung CO2 Konzentration von Syntheseprodukt (CH4) | INIT_CVAI | b | x | ? | P2G0 | 10 | MAX5815 | OUT_B | I2C | - |  | - | - | Offset für CVAI-Interface _002 | 0
m |  |  | Offset Messung H2 Konzentration von Syntheseprodukt (CH4) | INIT_CVAI | b | x | ? | P2G0 | 10 | MAX5815 | OUT_C | I2C | - |  | - | - | Offset für CVAI-Interface _003 | 0
m |  |  | Offset Messung CH4 Konzentration von Syntheseprodukt (CH4) | INIT_CVAI | b | x | ? | P2G0 | 10 | MAX5815 | OUT_D | I2C | - |  | - | - | Offset für CVAI-Interface _004 | 0
m |  |  | Offset für CVAI (OUT_001) | INIT_CVAI | b | x | ? | PSW0 | 10 | MAX5815 | OUT_A | I2C | - |  | - | - | Offset für CVAI-Interface _001 | 0
m |  |  | Offset für CVAI (OUT_002) | INIT_CVAI | b | x | ? | PSW0 | 10 | MAX5815 | OUT_B | I2C | - |  | - | - | Offset für CVAI-Interface _002 | 0
m |  |  | Offset für CVAI (OUT_003) | INIT_CVAI | b | x | ? | PSW0 | 10 | MAX5815 | OUT_C | I2C | - |  | - | - | Offset für CVAI-Interface _003 | 0
m |  |  | Offset für CVAI (OUT_004) | INIT_CVAI | b | x | ? | PSW0 | 10 | MAX5815 | OUT_D | I2C | - |  | - | - | Offset für CVAI-Interface _004 | 0
gs |  |  | Offset für CVAI (OUT_001) | INIT_CVAI | b | x | ? | PSW1 | 10 | MAX5815 | OUT_A | I2C | - |  | - | - | Offset für CVAI-Interface _001 | 0
gs |  |  | Offset für CVAI (OUT_002) | INIT_CVAI | b | x | ? | PSW1 | 10 | MAX5815 | OUT_B | I2C | - |  | - | - | Offset für CVAI-Interface _002 | 0
gs |  |  | Offset für CVAI (OUT_003) | INIT_CVAI | b | x | ? | PSW1 | 10 | MAX5815 | OUT_C | I2C | - |  | - | - | Offset für CVAI-Interface _003 | 0
gs |  |  | Offset für CVAI (OUT_004) | INIT_CVAI | b | x | ? | PSW1 | 10 | MAX5815 | OUT_D | I2C | - |  | - | - | Offset für CVAI-Interface _004 | 0
x |  |  | Sensoren auf I2C-Buserweiterung | x |  | x | x | x | x | x | x | x | x |  | x | x | x | x | x | x | x | x | x | x | x |  | x | x | x
m |  |  | Messung Humidity & Temperature CO2,H2 Gemisch | I2C | b | - | FT_000 | P2G0 | 28 | HTY_271 | - | I2C | I2C_0 |  | K12
m |  |  | Messung Humidity & Temperature Zufluss zum H2-Speicher | I2C | b | - | FT_002 | P2G0 | 28 | HTY_271 | - | I2C | I2C_1 |  | K15
m |  |  | Messung Humidity & Temperature Zufluss zum O2-Speicher | I2C | b | - | FT_003 | P2G0 | 28 | HTY_271 | - | I2C | I2C_2 |  | K16
m |  |  | Messung Durchflussmenge(Flow-Sensor) CO2,H2 Gemisch | I2C | b | - | FS_000 | P2G0 | 49 | HAF750SCCM | - | I2C | I2C_3 |  | K17 |  | no other components to be connected !!
m |  |  | Messung Humidity & Temperature Syntheseprodukt (CH4) | I2C | b | - | FT_001 | PSW0 | 28 | HTY_271 | - | I2C | I2C_2 |  | K16
m |  |  | Kühlertemperatur (Lüfter) | I2C | b | - | T_002 | PSW0 | 4D | LM75 | - | I2C | I2C_2 |  | K16
m |  |  | Peltiertemperatur (Gastrockner) | I2C | b | - | T_003 | PSW0 | 4E | LM75 | - | I2C | I2C_2 |  | K16
m |  |  | Wärmetauschertemperatur (Wasser) | I2C | b | - | T_004 | PSW0 | 4F | LM75 | - | I2C | I2C_2 |  | K16
 |  |  | ? | I2C |  |  | ? | PSW0 | 49 | HAF750SCCM
gs |  |  | Druchfluss CH4, Butan zum Motor | I2C |  | - | FS_200 | PSW1 | 28 | HAF250SCCM | - | I2C | I2C_3 |  | K17
 |  |  | Druck H2-Speicher Drucksensor SM5812-060-G-3-LR | ? |  |  | ? |  | 95 | SM5812 | - | I2C
 |  |  | Druck O2-Speicher Drucksensor SM5812-060-G-3-LR | ? |  |  | ? |  | 95 | SM5812 | - | I2C
x |  |  | Stromversorgungen | x |  | x | x | x | x | x | x | x | x |  | x | x | x | x | x | x | x | x | x | x | x |  | x | x | x
m |  |  | Spannungsversorgung Platine | PSU |  | - | - | P2G0 | - | - |  |  |  |  | K27/1, K27/2 | VCC, GND |  |  |  |  |  |  | 9V | 36V |  |  | Pin1 == VCC, Pin2 == GND
m |  |  | Elektrolyser 1 Versorgungsspannung einstellen | VDD1 |  | - | EL_000 | P2G0 | - | R111 |  |  |  |  | - | - | Einstellung Versorgung VDD1
m |  |  | Elektrolyser 2 Versorgungsspannung einstellen | VDD2 |  | - | EL_001 | P2G0 | - | R102 |  |  |  |  | - | - | Einstellung Versorgung VDD2
m |  |  | Einstellung Versorgungsspannung Steppermotor STM0 | VDD_4 |  | - | STM_000 | STM0 | - | R35 |  |  |  |  | - | - | Spannungsversorgung( 12V) VDD_4 Poti -Einstellung Spannung
m |  |  | Spannungsversorgung Platine 24V | PSU |  | - | - | STM0 | - | - |  |  |  |  | K2/1, K2/2 | V24P, GND | Spannungsversorgung Platine 24V
m |  |  | Einstellung Versorgungsspannung Steppermotor STM1 | VDD_4 |  | - | STM_001 | STM1 | - | R35 |  |  |  |  | - | - | Spannungsversorgung( 12V) VDD_4 Poti -Einstellung Spannung
m |  |  | Spannungsversorgung Platine 24V | PSU |  | - | - | STM1 | - | - |  |  |  |  | K2/1, K2/2 | V24P, GND | Spannungsversorgung Platine 24V
gs |  |  | Einstellung Versorgungsspannung Steppermotor STM2 | VDD_4 |  | - | STM_200 | STM2 | - | R35 |  |  |  |  | - | - | Spannungsversorgung( 12V) VDD_4 Poti -Einstellung Spannung
gs |  |  | Spannungsversorgung Platine 24V | PSU |  | - | - | STM2 | - | - |  |  |  |  | K2/1, K2/2 | V24P, GND | Spannungsversorgung Platine 24V
m |  |  | Spannungsversorgung Platine | PSU |  | - | - | P2G0 | - | SW1 | - | - | - |  | - |  | Power off für alle PSU's | -
m |  |  | Spannungsversorgung Platine | PSU |  | - | - | PSW0 | - | SW1 | - | - | - |  | - |  | Power off für alle PSU's | -
m |  |  | Versorgung VIN | PSU |  | - | - | PSW0 | - | - |  |  | VIN |  | K9/4,4 |  | Versorgung VIN
m |  |  | Versorgung V_IO_0 | PSU |  | - | - | PSW0 | - | - |  |  | V_IO_0 |  | K9/1,2 |  | Versorgung V_IO_0
m |  |  | Versorgung V_IO | PSU |  | - | - | PSW0 | - | - |  |  | V_IO |  | K53/2; K24/1,2 |  | Versorgung V_IO
m |  |  | Versorgung V_IO_1 | PSU |  | - | - | PSW0 | - | - |  |  | V_IO_1 |  | K53/1 |  | Versorgung V_IO_1
m |  |  | Versorgung GND | PSU |  | - | - | PSW0 | - | - |  |  | GND |  | K7/3,4 |  | Versorgung GND
m |  |  | Versorgung GND_1 | PSU |  | - | - | PSW0 | - | - |  |  | GND_1 |  | K7/1,2 |  | Versorgung GND_1
gs |  |  | Spannungsversorgung Platine | PSU |  | - | - | PSW1 | - | SW1 | - |  |  |  |  |  | Power off für alle PSU's | -
 |  |  | Versorgung VIN | PSU |  | - | - | PSW1 | - | - |  |  | VIN |  | K9/4,4 |  | Versorgung VIN
 |  |  | Versorgung V_IO_0 | PSU |  | - | - | PSW1 | - | - |  |  | V_IO_0 |  | K9/1,2 |  | Versorgung V_IO_0
 |  |  | Versorgung V_IO | PSU |  | - | - | PSW1 | - | - |  |  | V_IO |  | K53/2; K24/1,2 |  | Versorgung V_IO
 |  |  | Versorgung V_IO_1 | PSU |  | - | - | PSW1 | - | - |  |  | V_IO_1 |  | K53/1 |  | Versorgung V_IO_1
 |  |  | Versorgung GND | PSU |  | - | - | PSW1 | - | - |  |  | GND |  | K7/3,4 |  | Versorgung GND
 |  |  | Versorgung GND_1 | PSU |  | - | - | PSW1 | - | - |  |  | GND_1 |  | K7/1,2 |  | Versorgung GND_1
x |  |  | I2C-Anschlüsse | x |  | x | x | x | x | x | x | x | x |  | x | x | x | x | x | x | x | x | x | x | x |  | x | x | x
m |  |  | I2C-Bus 6 Pin | I2C |  | - | - | STM0 | - | - |  |  |  |  | K12 |  | I2C-Bus 6 Pin
m |  |  | I2C-Bus 10 Pin | I2C |  | - | - | STM0 | - | - |  |  |  |  | K25 |  | I2C-Bus 10 Pin
m |  |  | I2C-Bus 6 Pin | I2C |  | - | - | STM1 | - | - |  |  |  |  | K12 |  | I2C-Bus 6 Pin
m |  |  | I2C-Bus 10 Pin | I2C |  | - | - | STM1 | - | - |  |  |  |  | K25 |  | I2C-Bus 10 Pin
gs |  |  | I2C-Bus 6 Pin | I2C |  | - | - | STM2 | - | - |  |  |  |  | K12 |  | I2C-Bus 6 Pin
gs |  |  | I2C-Bus 10 Pin | I2C |  | - | - | STM2 | - | - |  |  |  |  | K25 |  | I2C-Bus 10 Pin
m |  |  | I2C-Bus 10 Pin | I2C |  | - | - | P2G0 | - | - |  |  |  |  | K25 |  | I2C-Bus 10 Pin
m |  |  | I2C-Bus 6 Pin | I2C |  | - | - | P2G0 | - | - |  |  |  |  | K12 |  | I2C-Bus 6 Pin
m |  |  | I2C-Bus 6 Pin | I2C |  | - | - | P2G0 | - | - |  |  |  |  | K15 |  | I2C-Bus 6 Pin
m |  |  | I2C-Bus 6 Pin | I2C |  | - | - | P2G0 | - | - |  |  |  |  | K16 |  | I2C-Bus 6 Pin
m |  |  | I2C-Bus 6 Pin | I2C |  | - | - | P2G0 | - | - |  |  |  |  | K17 |  | I2C-Bus 6 Pin
m |  |  | I2C-Bus 10 Pin | I2C |  | - | - | PSW0 | - | - |  |  |  |  | K25 |  | I2C-Bus 10 Pin
m |  |  | I2C-Bus 6 Pin | I2C |  | - | - | PSW0 | - | - |  |  |  |  | K12 |  | I2C-Bus 6 Pin
m |  |  | I2C-Bus 6 Pin | I2C |  | - | - | PSW0 | - | - |  |  |  |  | K15 |  | I2C-Bus 6 Pin
m |  |  | I2C-Bus 6 Pin | I2C |  | - | - | PSW0 | - | - |  |  |  |  | K16 |  | I2C-Bus 6 Pin
m |  |  | I2C-Bus 6 Pin | I2C |  | - | - | PSW0 | - | - |  |  |  |  | K17 |  | I2C-Bus 6 Pin
 |  |  | I2C-Bus 10 Pin | I2C |  | - | - | PSW1 | - | - |  |  |  |  | K25 |  | I2C-Bus 10 Pin
 |  |  | I2C-Bus 6 Pin | I2C |  | - | - | PSW1 | - | - |  |  |  |  | K12 |  | I2C-Bus 6 Pin
 |  |  | I2C-Bus 6 Pin | I2C |  | - | - | PSW1 | - | - |  |  |  |  | K15 |  | I2C-Bus 6 Pin
 |  |  | I2C-Bus 6 Pin | I2C |  | - | - | PSW1 | - | - |  |  |  |  | K16 |  | I2C-Bus 6 Pin
 |  |  | I2C-Bus 6 Pin | I2C |  | - | - | PSW1 | - | - |  |  |  |  | K17 |  | I2C-Bus 6 Pin
x |  |  | Sonstige Config. | x |  | x | x | x | x | x | x | x | x |  | x | x | x | x | x | x | x | x | x | x | x |  | x | x | x
m |  |  | ? | US_SENES |  | ? | ? | P2G0 | - |  |  |  | - |  | K43/1,2,3,4,5 | U_EX+,U_EX-, GND, U_IN-, U_IN+
m |  |  | Jumper für Adresse P2G0 IF-Zugriffe über PCA9545 | ADR_CONFIG |  | - | P2G0 | P2G0 | 70 | PCA9545 |  |  |  |  | K18/1-2 , K18/3-4 |  | Jumper für Adresse PCA9545
m |  |  | Jumper für Messung Brennstoffzelle Umon | DSO_GNDOPN_5A0_UI |  | - | BZ_000 | P2G0 | - |  |  |  |  |  | K50/2-4 |  | ?
m |  |  | Jumper für Messung Brennstoffzelle Imon | DSO_GNDOPN_5A0_UI |  | - | BZ_000 | P2G0 | - |  |  |  |  |  | K50/1-3 |  | ?
m |  |  | Jumper für Adresse Raumtemperatur sensor | ADR_CONFIG | - | - | T_000 | P2G0 | 4E | TMP100 | - | - | - |  | K28/1-3;2-4 |  | Jumper für Adresse Raumtemperatur sensor
m |  |  | Jumper für Messung Ofentemperatur | INIT_CVAI |  | - | TH_000 | P2G0 | - | Jumper | - | - | - |  | K31/3-5 | - | Jumper für Sensor-Signal-Conditioning_001
m |  |  | Jumper für Messung CO2 Konzentration Syntheseprodukt (CH4) | INIT_CVAI |  | - | ? | P2G0 | - |  |  |  |  |  | K33/ |  | Jumper für Sensor-Signal-Conditioning_002
m |  |  | Jumper für Messung H2 Konzentration von Syntheseprodukt (CH4) | INIT_CVAI |  | - | ? | P2G0 | - |  |  |  |  |  | K35/ |  | Jumper für Sensor-Signal-Conditioning_003
m |  |  | Jumper für Messung CH4 Konzentration von Syntheseprodukt (CH4) | INIT_CVAI |  | - | ? | P2G0 | - |  |  |  |  |  | K37/ |  | Jumper für Sensor-Signal-Conditioning_004
m |  |  | Jumper für Adresse INIT_CVAI | ADR_CONFIG |  | - | ? | P2G0 | 10 | MAX5815 |  |  |  |  | K29/1-2;K38/1-2 |  | Jumper für Adresse INIT_CVAI
m |  |  | Jumper für Versorgung VDD1 | VCC_CONFIG |  | - | - | P2G0 | - |  |  |  |  |  | K5/1-2 |  | Jumper für Versorgung VDD1
m |  |  | Jumper für Versorgung VDD2 | VCC_CONFIG |  | - | - | P2G0 | - |  |  |  |  |  | K4/1-2 |  | Jumper für Versorgung VDD2
m |  |  | Jumper für Versorgung V5P | VCC_CONFIG |  | - | - | P2G0 | - |  |  |  |  |  | K21/1-2 |  | Jumper für Versorgung V5P
m |  |  | Jumper für Versorgung V12P | VCC_CONFIG |  | - | - | P2G0 | - |  |  |  |  |  | K20/1-2 |  | Jumper für Versorgung V12P
m |  |  | Jumper für Versorgung V12N | VCC_CONFIG |  | - | - | P2G0 | - |  |  |  |  |  | K22/1-2 |  | Jumper für Versorgung V12N
m |  |  | Jumper für Versorgung V12N vom I2C Bus | VCC_CONFIG |  | - | - | P2G0 | - |  |  |  |  |  | K2/- |  | Jumper für Versorgung V12N vom I2C Bus
m |  |  | Jumper für Versorgung V12P vom I2C Bus | VCC_CONFIG |  | - | - | P2G0 | - |  |  |  |  |  | K3/- |  | Jumper für Versorgung V12P vom I2C Bus
m |  |  | Jumper für Versorgung V5P vom I2C Bus | VCC_CONFIG |  | - | - | P2G0 | - |  |  |  |  |  | K19/- |  | Jumper für Versorgung V5P vom I2C Bus
m |  |  | Jumper Adresse ADS7828 | ADR_CONFIG |  | - | STM_000 | STM0 | 4B | ADS7828 |  |  |  |  | K6/1-2 ;K5/1-2 |  | Jumper Adresse ADS7828
m |  |  | Jumper Adresse PCF8574 | ADR_CONFIG |  | - | STM_000 | STM0 | 20 | PCF8574 |  |  |  |  | K1/ 1-2 ,3-4 , 5-6 |  | Jumper Adresse PCF8574
m |  |  | Configuration analoge Eingangsinterface für Poti-Input | INIT_CVAI |  | - | STM_000 | STM0 | - |  |  |  |  |  | K10/1-2, - |  | Jumper Ue- auf GND , Einagan Ue+ ist aktiv
m |  |  | Jumper Adresse ADS7828 | ADR_CONFIG |  | - | STM_001 | STM1 | 4A | ADS7828 |  |  |  |  | K6/ - ;K5/1-2 |  | Jumper Adresse ADS7828
m |  |  | Jumper Adresse PCF8574 | ADR_CONFIG |  | - | STM_001 | STM1 | 25 | PCF8574 |  |  |  |  | K1/ - ,3-4 , - |  | Jumper Adresse PCF8574
m |  |  | Configuration analoge Eingangsinterface für Poti-Input | INIT_CVAI |  | - | STM_001 | STM1 | - |  |  |  |  |  | K10/1-2, - |  | Jumper Ue- auf GND , Einagan Ue+ ist aktiv
gs |  |  | Jumper Adresse ADS7828 | ADR_CONFIG |  | - | STM_200 | STM2 | 4B | ADS7828 |  |  |  |  | K6/ - ;K5/1-2 |  | Jumper Adresse ADS7828
gs |  |  | Jumper Adresse PCF8574 | ADR_CONFIG |  | - | STM_200 | STM2 | 20 | PCF8574 |  |  |  |  | K1/ 1-2 ,3-4 , - |  | Jumper Adresse PCF8574
gs |  |  | Configuration analoge Eingangsinterface für Poti-Input | INIT_CVAI |  | - | STM_200 | STM2 | - |  |  |  |  |  | K10/1-2, - |  | Jumper Ue- auf GND , Einagan Ue+ ist aktiv
m |  |  | Jumper für Adresse PSW0 IF-Zugriffe über PCA9545 | ADR_CONFIG |  | - | PSW0 | PSW0 | 71 | PCA9545 |  |  |  |  | K18/- , K18/3-4 |  | Jumper für Adresse PCA9545
m |  |  | Jumper für Versorgung DSI_&_DSO_HS_OPN_CVONF | VCC_CONFIG |  | - | L_000 | PSW0 | - |  |  |  |  |  | K6/ - ; 3-4 ; - | VIN, V12P_1, V_IO | Jumper für DSO HS
 |  |  | Jumper für Versorgung DSI_&_DSO_HS_OPN_CVONF | VCC_CONFIG |  | - | ? | PSW0 | - |  |  |  |  |  | K27/ - ; - ; - | VIN, V12P_1, V_IO | Jumper für DSO HS
 |  |  | Jumper für Versorgung DSI_&_DSO_HS_OPN_CVONF | VCC_CONFIG |  | - | ? | PSW0 | - |  |  |  |  |  | K10/ - ; - ; - | VIN, V12P_1, V_IO | Jumper für DSO HS
 |  |  | Jumper für Versorgung DSI_&_DSO_HS_OPN_CVONF | VCC_CONFIG |  | - | ? | PSW0 | - |  |  |  |  |  | K4/ - ; - ; - | VIN, V12P_1, V_IO | Jumper für DSO HS
 |  |  | Jumper für Versorgung V12N vom I2C Bus | VCC_CONFIG |  | - | - | PSW0 | - |  |  |  |  |  | K2/- |  | Jumper für Versorgung V12N vom I2C Bus
 |  |  | Jumper für Versorgung V12P vom I2C Bus | VCC_CONFIG |  | - | - | PSW0 | - |  |  |  |  |  | K3/- |  | Jumper für Versorgung V12P vom I2C Bus
 |  |  | Jumper für Versorgung V5P vom I2C Bus | VCC_CONFIG |  | - | - | PSW0 | - |  |  |  |  |  | K19/- |  | Jumper für Versorgung V5P vom I2C Bus
 |  |  | Jumper für Versorgung V12N_1 DC/DC | VCC_CONFIG |  | - | - | PSW0 | - |  |  |  |  |  | K22/- | V12N_1 <=> V12N | Jumper für Versorgung V12N_1 DC/DC
 |  |  | Jumper für Versorgung V12P_1 DC/DC | VCC_CONFIG |  | - | - | PSW0 | - |  |  |  |  |  | K20/- | V12P_1 <=> V12P | Jumper für Versorgung V12P_1 DC/DC
 |  |  | Jumper für Versorgung V5P_1 DC/DC | VCC_CONFIG |  | - | - | PSW0 | - |  |  |  |  |  | K21/- | V5P_1 <=> V5P | Jumper für Versorgung V5P_1 DC/DC
 |  |  | Jumper für Versorgung V5P_1 DC/DC | VCC_CONFIG |  | - | - | PSW0 | - |  |  |  |  |  | K5/- | GND <=> GND_1 | Jumper für Versorgung V5P_1 DC/DC
m |  |  | Jumper für Adresse INIT_CVAI | ADR_CONFIG |  | - | ? | PSW0 | 10 | MAX5815 |  |  |  |  | K29/1-2;K38/1-2 |  | Jumper für Adresse INIT_CVAI
m |  |  | Jumper für Adresse Raumtemperatur sensor | ADR_CONFIG | - | - | T_001 | PSW0 | 4E | TMP100 | - | - | - |  | K28/1-3;2-4 |  | Jumper für Adresse Raumtemperatur sensor
 |  |  | Jumper für Sensor-Signal-Conditioning_001 | INIT_CVAI |  | - | ? | PSW0 | - |  |  |  |  |  | K31/ - |  | Jumper für Sensor-Signal-Conditioning_001
 |  |  | Jumper für Sensor-Signal-Conditioning_002 | INIT_CVAI |  | - | ? | PSW0 | - |  |  |  |  |  | K33/ - |  | Jumper für Sensor-Signal-Conditioning_002
 |  |  | Jumper für Sensor-Signal-Conditioning_003 | INIT_CVAI |  | - | ? | PSW0 | - |  |  |  |  |  | K35/ - |  | Jumper für Sensor-Signal-Conditioning_003
 |  |  | Jumper für Sensor-Signal-Conditioning_004 | INIT_CVAI |  | - | ? | PSW0 | - |  |  |  |  |  | K37/ - |  | Jumper für Sensor-Signal-Conditioning_004
gs |  |  | Jumper für Adresse PCA9545 | ADR_CONFIG |  | - | ? | PSW1 | 71 | PCA9545 |  |  |  |  | K18/- , K18/3-4 |  | Jumper für Adresse PCA9545
 |  |  | Jumper für Versorgung DSI_&_DSO_HS_OPN_CVONF | VCC_CONFIG |  | - | ? | PSW1 | - |  |  |  |  |  | K6/ - ; 3-4 ; - | VIN, V12P_1, V_IO | Jumper für DSO HS
 |  |  | Jumper für Versorgung DSI_&_DSO_HS_OPN_CVONF | VCC_CONFIG |  | - | ? | PSW1 | - |  |  |  |  |  | K27/ - ; - ; - | VIN, V12P_1, V_IO | Jumper für DSO HS
 |  |  | Jumper für Versorgung DSI_&_DSO_HS_OPN_CVONF | VCC_CONFIG |  | - | ? | PSW1 | - |  |  |  |  |  | K10/ - ; - ; - | VIN, V12P_1, V_IO | Jumper für DSO HS
 |  |  | Jumper für Versorgung DSI_&_DSO_HS_OPN_CVONF | VCC_CONFIG |  | - | ? | PSW1 | - |  |  |  |  |  | K4/ - ; - ; - | VIN, V12P_1, V_IO | Jumper für DSO HS
 |  |  | Jumper für Versorgung V12N vom I2C Bus | VCC_CONFIG |  | - | - | PSW1 | - |  |  |  |  |  | K2/- |  | Jumper für Versorgung V12N vom I2C Bus
 |  |  | Jumper für Versorgung V12P vom I2C Bus | VCC_CONFIG |  | - | - | PSW1 | - |  |  |  |  |  | K3/- |  | Jumper für Versorgung V12P vom I2C Bus
 |  |  | Jumper für Versorgung V5P vom I2C Bus | VCC_CONFIG |  | - | - | PSW1 | - |  |  |  |  |  | K19/- |  | Jumper für Versorgung V5P vom I2C Bus
 |  |  | Jumper für Versorgung V12N_1 DC/DC | VCC_CONFIG |  | - | - | PSW1 | - |  |  |  |  |  | K22/- | V12N_1 <=> V12N | Jumper für Versorgung V12N_1 DC/DC
 |  |  | Jumper für Versorgung V12P_1 DC/DC | VCC_CONFIG |  | - | - | PSW1 | - |  |  |  |  |  | K20/- | V12P_1 <=> V12P | Jumper für Versorgung V12P_1 DC/DC
 |  |  | Jumper für Versorgung V5P_1 DC/DC | VCC_CONFIG |  | - | - | PSW1 | - |  |  |  |  |  | K21/- | V5P_1 <=> V5P | Jumper für Versorgung V5P_1 DC/DC
 |  |  | Jumper für Versorgung V5P_1 DC/DC | VCC_CONFIG |  | - | - | PSW1 | - |  |  |  |  |  | K5/- | GND <=> GND_1 | Jumper für Versorgung V5P_1 DC/DC
gs |  |  | Jumper für Adresse INIT_CVAI | ADR_CONFIG |  | - | ? | PSW1 | 10 | MAX5815 |  |  |  |  | K29/1-2;K38/1-2 |  | Jumper für Adresse INIT_CVAI
gs |  |  | Jumper für Adresse Raumtemperatur sensor | ADR_CONFIG | - | - | T_200 | PSW1 | 4E | TMP100 | - | - | - |  | K28/1-3;2-4 |  | Jumper für Adresse Raumtemperatur sensor
 |  |  | Jumper für Sensor-Signal-Conditioning_001 | INIT_CVAI |  | - | ? | PSW1 | - |  |  |  |  |  | K31/ - |  | Jumper für Sensor-Signal-Conditioning_001
 |  |  | Jumper für Sensor-Signal-Conditioning_002 | INIT_CVAI |  | - | ? | PSW1 | - |  |  |  |  |  | K33/ - |  | Jumper für Sensor-Signal-Conditioning_002
 |  |  | Jumper für Sensor-Signal-Conditioning_003 | INIT_CVAI |  | - | ? | PSW1 | - |  |  |  |  |  | K35/ - |  | Jumper für Sensor-Signal-Conditioning_003
 |  |  | Jumper für Sensor-Signal-Conditioning_004 | INIT_CVAI |  | - | ? | PSW1 | - |  |  |  |  |  | K37/ - |  | Jumper für Sensor-Signal-Conditioning_004
gs |  |  | Jumper für für Adresse Ansteuerung Schwingkolbenpumpe | 220VAC_SW |  | - | SK_100 | ASP1 | 25 |  |  |  |  |  | K1/ - ; 3-4 ; -
x |  |  | Manuelle Steuerelemente | x |  | x | x | x | x | x | x | x | x |  | x | x | x | x | x | x | x | x | x | x | x |  | x | x | x
m |  |  | CO2 Durchflusseinstellung CO2 Quelle | manuell |  |  | NV_000 | other
m |  |  | O2 Durchflusseinstellung vor Pumpe | manuell |  |  | NV_001 | other
m |  |  | H2 Durchflusseinstellung vor Pumpe | manuell |  |  | NV_002 | other
m |  |  | O2 Durchflusseinstellung nach O2 Speicher | manuell |  |  | NV_003 | other
m |  |  | O2 Überdruckventil 1 bar | manuell |  |  | ÜV_000 | other
m |  |  | H2 Überdruckventil 1 bar | manuell |  |  | ÜV_001 | other
m |  |  | O2 Manometer Speicher | Manometer 0….4 bar |  |  | M_000 | other
m |  |  | H2 Manometer Speicher | Manometer 0….4 bar |  |  | M_001 | other
m |  |  | CO2 Manometer CO2-Flasche reduziert | Manometer 0….2 bar |  |  | M_002 | other
m |  |  | CO2 Manometer CO2-Flasche | Manometer 0….50 bar |  |  | M_003 | other
m |  |  | Rückschalgventil CO2 zu V2_007 | 0,1 bar |  |  | RV_000 | other
m |  |  | Rückschalgventil H2 zu V3_000 | 0,1 bar |  |  | RV_001 | other
 |  |  | Manometer CH4 Speicher | Manometer 15 bar |  |  |  | other
 |  |  | Manometer CH4 Gasmotorzuführung | Manometer 1,5 bar |  |  |  | other
 |  |  | Rückschlagventil CH4 Zuleitung Methanisierung | Rückschlagventil |  |  |  | other
 |  |  | Rückschlagventil CH4 Zuleitung P2G | Rückschlagventil |  |  |  | other
 |  |  | Rückschlagventil CH4 Druckspeicher | Rückschlagventil |  |  |  | other
 |  |  | Rückschlagventil Pumpe CH4 Druckerzeuger | Rückschlagventil |  |  |  | other
 |  |  | Ventil CH4 Motor Zuleitung | Druckreduzierer |  |  |  | other
 |  |  | Überdruckventil Druckerzeuger | Überdruckventil |  |  |  | other
 |  |  | Druchflussbegrenzer Wasserückfluss Druckerzeuger | Begrenzer |  |  |  | other
 |  |  | Gasmotor | Drehzahlmessung Gasmotor |  |  | ? | ?
 |  |  | Rückschlagventil Speicher CH4 Zuleitung Methanisierung |  |  |  | RV_100 | other
 |  |  | Rückschlagventil Speicher CH4 Zuleitung Power to Gas P2G |  |  |  | RV_101 | other
 |  |  | Rückschlagventil Wasserzuführung Druckerzeuger |  |  |  | RV_102 | other
 |  |  | Rückschlagventil CH4 Druckspeicher |  |  |  | RV_103 | other
 |  |  | Durchflussbegrenzer Druckerzeuger |  |  |  | DB_100 | other
 |  |  | Rückschlagventil CH4 Druckspeicher |  |  |  | ÜV_100 | other
 |  |  | Druckredurierer CH4 Speicher mit Manuellem Absperrventil | 10 => 0,6bar |  |  |  | other

Sheet: Info_2_ICD
Montor und Abschaltung Steppermotor

Sheet: Platinen
Platinen | Version | Platinen Nr.
P2G0 | Power_2_Gas_4L_SP_5V00 | 0
STM0 | Steppermotor Platine | 0
STM1 | Steppermotor Platine | 1
STM2 | Steppermotor Platine | 2
PSW0 | Power Switch | 0
PSW1 | Power Switch | 1
Bus Expand | Expand und PSU | -
USB to I2C | USB to I2C converter | -

Sheet: Busystem_Pullup
 | Bussystem pull up |  |  | 1724.137931 |  | Versorgung | 5.0 V
 | Strom |  |  | 2.9 mA
Platinen | Bussystem & Subsystem |  | Select Subsys | pull up | 1/R | Komponente
 |  |  |  |  | 0.00058
P2G0 | Methanisierung | Main | - | 50000 | 0.00002 | Stecker
STM0 | Methanisierung | Main | - | 50000 | 0.00002 | Stecker
STM1 | Methanisierung | Main | - | 50000 | 0.00002 | Stecker
PSW0 | Methanisierung | Main | - | 50000 | 0.00002 | Stecker
USB to I2C | Methanisierung | Main | - | 10000 | 0.00010 | Stecker
PSW1 | Speicher & Motor | Main | - | 50000 | 0.00002 | Stecker
STM2 | Speicher & Motor | Main | - | 50000 | 0.00002 | Stecker
USB to I2C | Speicher & Motor | Main | - | 10000 | 0.00010 | Stecker
P2G0 | Methanisierung | Bus 0 | P2G0_Bus 0 | 50000 | 0.00002 | Stecker
P2G0 | Methanisierung | Bus 0 | P2G0_Bus 0 | 50000 | 0.00002 | AD7828
P2G0 | Methanisierung | Bus 1 | P2G0_Bus 1 | 50000 | 0.00002 | Stecker
P2G0 | Methanisierung | Bus 2 | P2G0_Bus 2 | 50000 | 0.00002 | Stecker
P2G0 | Methanisierung | Bus 3 | P2G0_Bus 3 | 50000 | 0.00002 | Stecker
PSW0 | Methanisierung | Bus 0 | PSW0_Bus 0 | 50000 | 0.00002 | Stecker
PSW0 | Methanisierung | Bus 1 | PSW0_Bus 1 | 50000 | 0.00002 | Stecker
PSW0 | Methanisierung | Bus 2 | PSW0_Bus 2 | 50000 | 0.00002 | Stecker
PSW0 | Methanisierung | Bus 3 | PSW0_Bus 3 | 50000 | 0.00002 | Stecker
PSW1 | Speicher & Motor | Bus 0 | PSW1_Bus 0 | 50000 | 0.00002 | Stecker
PSW1 | Speicher & Motor | Bus 1 | PSW1_Bus 1 | 50000 | 0.00002 | Stecker
PSW1 | Speicher & Motor | Bus 2 | PSW1_Bus 2 | 50000 | 0.00002 | Stecker
PSW1 | Speicher & Motor | Bus 3 | PSW1_Bus 3 | 50000 | 0.00002 | Stecker
 |  |  | _
 |  |  | _
 |  |  | _
 |  |  | _
 |  |  | _
 |  |  | _
 |  |  | _
 |  |  | _
 |  |  | _
 |  |  | _
 |  |  | _
 |  |  | _
 |  |  | _

Sheet: I2C_Auslastung
SCL |  | 1e-05 |  |  |  |  |  |  |  |  |  | System
 |  |  |  |  |  |  |  |  |  |  |  | Bit/s
 |  |  |  |  |  |  |  |  |  |  |  | 0.44 ms
Timing Berechnung |  |  |  |  |  |  | Boards
 |  |  |  |  | Summe | Anzahl der SW Zugriffe | P2G | STPM_0 | STPM_1 | STPM_2 | Sensoren
PCF_8575 | 1 | Start | 1 | 1 | 31 | 4 | 1 |  |  |  |  | 1.24 ms
 | 1 | Adressen | 8 | 8
 | 2 | Daten | 8 | 16
 | 3 | ACK | 1 | 3
 | 1 | Stop | 1 | 1
 | 2 | Idel | 1 | 2
MAX_1238 | 1 | Start | 1 | 1 | 229 | 1 | 1 |  |  |  |  | 2.29 ms
 | 1 | Adressen | 8 | 8
 | 24 | Daten | 8 | 192
 | 25 | ACK | 1 | 25
 | 1 | Stop | 1 | 1
 | 2 | Idel | 1 | 2
AD_7828 | 1 | Start | 1 | 1 | 53 | 16 | 1 | 1 | 1 | 1 |  | 33.92 ms
 | 1 | Adressen | 8 | 8
 | 1 | Init Channel | 8 | 8
 | 2 | ACK | 1 | 2
 | 1 | Stop | 1 | 1
 | 2 | Idel | 1 | 2
 | 1 | Start | 1 | 1
 | 1 | Adressen | 8 | 8
 | 2 | Daten | 8 | 16
 | 3 | ACK | 1 | 3
 | 1 | Stop | 1 | 1
 | 2 | Idel | 1 | 2
TMP100 | 1 | Start | 1 | 1 | 31 | 1 | 1 |  |  |  |  | 0.31 ms
 | 1 | Adressen | 8 | 8
 | 2 | Daten | 8 | 16
 | 3 | ACK | 1 | 3
 | 1 | Stop | 1 | 1
 | 2 | Idel | 1 | 2
HTY_271 | 1 | Start | 1 | 1 | 49 | 3 |  |  |  |  | 2 | 2.94 ms
 | 1 | Adressen | 8 | 8
 | 4 | Daten | 8 | 32
 | 5 | ACK | 1 | 5
 | 1 | Stop | 1 | 1
 | 2 | Idel | 1 | 2
PCF_8574 | 1 | Start | 1 | 1 | 22 | 1 |  | 1 | 1 | 1 |  | 0.66 ms
 | 1 | Adressen | 8 | 8
 | 1 | Daten | 8 | 8
 | 2 | ACK | 1 | 2
 | 1 | Stop | 1 | 1
 | 2 | Idel | 1 | 2
PCA_9545 | 1 | Start | 1 | 1 | 22 | 14 | 1 |  |  |  |  | 3.08 ms
 | 1 | Adressen | 8 | 8
 | 1 | Daten | 8 | 8
 | 2 | ACK | 1 | 2
 | 1 | Stop | 1 | 1
 | 2 | Idel | 1 | 2

Sheet: STM_PCB
Funktion | Pins pro Funktion | Klemmen
Motorsteuerung | 4 | Schraubklemme 2x2 polig
Versorgung 24V | 2 | Schraubklemme 2 polig
24V auf 12V Wandler | 1 | -
Position (Poti) mit Versorgung | 3 | Federklemme 3 polig
Window Komp HW-Abschaltung | - | -
DSO_24V_OPN | 2 | Schraubklemme 2 polig
I2C Bus | 10 | Wanne 10-polig
I2C Bus | 6 | Wanne 6-polig
Postion einlesen | - | -
Messen der 24V | - | -
Messen der 12V | - | -
3 Analoge Eingang mit Versorgung | 3 | Federklemme 3 x 3 polig
4 analoge Eingänge spare V5P, GND | - | Postenleiste 6polig
Adresseinestellung ADS7828 | - | Postenleiste 6polig
Adresseinestellung PCF8574 | - | Postenleiste 6polig

Sheet: Tabelle1
HAFBLF0750C4AX5

Sheet: Layout_Regelung
Druck |  |  | Motor
Wert [mbar] | Bezeichnung | Instanz | Wert | Bezeichnung | Instanz
0 | H2 Eletrolyser | P_001 | 0 E/A | CH4 Ventil
0 | O2 Eletrolyser | P_000 | 0 E/A | Butan Ventil
0 | H2 Speicher | P_003 | 0 ml/s | Gas Duchflussmenge
0 | O2 Speicher | P_002 | 0 mbar | Druck Gaszufuhr
0
0
0
0
Gaskonzentration
Wert [%] | Bezeichnung | Instanz
0 | H2 Gemisch
0 | CO2 Gemisch
0 | CH4 Synthese
0 | H2 Synthese
0 | CO2 Synthese
Gasfluss
Wert [%] | Bezeichnung | Instanz
0 | H2 Gemisch
0 | CO2 Gemisch
