CodingGhost/CCIPN/CCMR/Docs/Steppermotor_Test_I2C_Control_0V01.xls

Sheet: Software
 |  |  |  |  |  | Instanz |  | FS_000 | STM_000 | P_000 | P_001 | P_002 | P_003 | FL_001 | FL_001 | FL_002 | STM_001 | P_00 | FS_000
 |  |  |  |  |  | Einheit |  | ccm/min | % | mbar | mbar | mbar | mbar | mV | mV | mV | % | mbar | ccm/min
 |  |  |  |  |  | Min, Low-Thr, |  | - | 20.0 | - | - | 200 | 200 | 1250 | 1250 | 1250 | 12.0 | 200 | -
 |  |  | PC-Time | 81213.62 |  | Max,High-Thr |  | - | 80.0 | 600 | 600 | 1800 | 1800 | 1250 | 1250 | 1250 | 88.0 | 1800 | -
 |  |  |  |  |  | Soll-Wert tol. |  | 200 | - | 100 | 100 | - | - | - | - | - | - | - | 200
 | Bin |  | Dez | HEX |  | Soll-Wert |  | 500 | - | 500 | 500 | 1500 | 1500 | - | - | - | - | 1500 | 500
 | 10000 |  | 16 | 10 |  | Ist-Wert
 | 11010111 |  | 215 | D7 |  | Step | Time | Flowsensor | H2/CO2 Vent. Postion | O2 Druck Elektorl. | H2 Druck Elektorl. | O2 Druck Puffersp. | H2 Druck Puffersp. | O2 Abscheider H2O | H2 Abscheider H2O | CH4 Abscheider H2O | CO2 Vent. Postion | H2 Druck Puffersp. | Flowsensor
 | 01001001 |  | 73 | 49
 | SystemParameter |  | MAF | MIF
 | Zyklus 1 |  | 10.0s | 1.00s
 | Zyklus 2
 | Motor Steptime |  |  | 0.010s
Karte | I2C Component | Bus | DEZ | HEX |  | 9 | 9.0 | 0 | 10.2 |  |  |  |  | 0.0 | 0.0 | 0.0 |  |  |  | 254.5166016 | 1 | 0 | 0.0
 |  |  |  |  | 0 | 0 | 0.0 | 0 | 0 | 0 | 0 | 0 | 0 |  |  |  | 0 | 0 | 0
 | Main_PCF8574 | M | 39 | 27 |  | 1 | 1.0 | 0 | 16.30859375 |  |  |  |  | 0 | 0 | 0 |  |  |  | 407.7148438 | 1 | 0 | 0.0
 |  |  |  |  |  | 2 | 2.0 | 0 | 14.42871094 |  |  |  |  | 0 | 0 | 0 |  |  |  | 360.7177734 | 1 | 0 | 0.0
P2G | P2G_PCA9545 | M | 112 | 70 |  | 3 | 3.0 | 0 | 12.67089844 |  |  |  |  | 0 | 0 | 0 |  |  |  | 316.7724609 | 1 | 0 | 0.0
P2G | P2G_MAX1238 | 0 | 53 | 35 |  | 4 | 4.0 | 0 | 10.7421875 |  |  |  |  | 0 | 0 | 0 |  |  |  | 268.5546875 | 1 | 0 | 0.0
P2G | P2G_MAX5815 | 0 | 00 | 00 |  | 5 | 5.0 | 0 | 10.20507812 |  |  |  |  | 0 | 0 | 0 |  |  |  | 255.1269531 | 1 | 0 | 0.0
P2G | P2G_TMP100 | 0 | 00 | 00 |  | 6 | 6.0 | 0 | 10.20507812 |  |  |  |  | 0 | 0 | 0 |  |  |  | 255.1269531 | 1 | 0 | 0.0
P2G | P2G_PCF8575 | 0 | 00 | 00 |  | 7 | 7.0 | 0 | 10.20507812 |  |  |  |  | 0 | 0 | 0 |  |  |  | 255.1269531 | 1 | 0 | 0.0
P2G | P2G_ADS7828 | 0 | 75 | 4B |  | 8 | 8.0 | 0 | 10.20507812 |  |  |  |  | 0 | 0 | 0 |  |  |  | 255.1269531 | 1 | 0 | 0.0
 |  |  |  |  |  | 9 | 9.0 | 0 | 10.18066406 |  |  |  |  | 0 | 0 | 0 |  |  |  | 254.5166016 | 1 | 0 | 0.0
PSW | PSW0_PCA9545 | M | 114 | 72
PSW | PSW1_PCA9545 | M | 113 | 71
PSW | PSWx_MAX1238 | 0 | 53 | 35
PSW | PSWx_MAX5815 | 0 | 16 | 10
PSW | PSWx_TMP100 | 0 | 72 | 48
PSW | PSWx_PCF8575 | 1 | 32 | 20
PSW | PSWx_MAX1238 | 1 | 53 | 35
STM | STM0_ADS7828 | M | 75 | 4B
STM | STM0_PCF8574 | M | 32 | 20
STM | STM1_ADS7828 | M | 75 | 4B
STM | STM1_PCF8574 | M | 32 | 20
STM | STM2_ADS7828 | M | 75 | 4B
STM | STM2_PCF8574 | M | 32 | 20
P2G | HYT271_0 (F/T) | 0 | 40 | 28
P2G | HYT271_1 (F/T) | 1 | 40 | 28
P2G | HYT271_2 (F/T) | 2 | 40 | 28
 | LM75_0 (Lüfter) | x | 00 | 00
 | LM75_1 (Kühler) | x | 00 | 00
P2G | HAFBL750_0 (Flow) | 3 | 73 | 49
PSW0 | HAFBL750_0 (Flow) | 3 | 73 | 49

Sheet: Funktionen
 |  |  |  |  |  |  | Struktur
 |  |  |  |  |  |  | Funktion: | Adresse | x Daten | I2C-Mux-Adr. | I2C-Bus
 |  |  |  |  |  |  | Adressdefintion | ADR | Board | I2C-Bus | Komponente
Funktionsnamen | Convert | Read | Write | Werte | I2C Umschaltung
Data_MAX1238 |  | x |  | 24 | x
DSO_manipulate | x |  |  | 1
Data_LM75 | x | x |  | 1 | x
Druck_MPX5100 | x |  |  | 1
Data_HYT271 | x | x |  | 2 | x
Data_ADS7828 |  | x |  | 8 | x
Data_ADS7828_M |  | x |  | 8
Write_Read_PCF8574 |  | x | x | 1 | x
Write_Read_PCF8575 |  | x | x | 2 | x
Write_PCF8574 |  |  | x | 1 | x
Write_PCF8575 |  |  | x | 2 | x
Write_PCF8574 |  |  | x | 1
Read_FLOW_750 |  | x |  | 1 | x | Variant
Init_MAX1238 |  |  | x |  | x
Init_MAX5815 |  |  | x |  | x
Init_Flow |  | x |  |  | x

Sheet: Daten_Speich.
Position im Array | Speicherung Daten
0
1 | Zeile
2 | Aktuelle abgelaufene Zeit
3 | Leer
4 | Position Motor Platine STM0
5
6
7
8
9
10
11
12
13
14
15
16
17
18
19
20
21
22
23
24
25
26
27
28
29
30
31
32
33

Sheet: SW-Ablauf
State | State Nr. | MAF | MIF | loop | Function
Powerup | 0 |  |  |  | Power on
Powerup | 1 |  |  |  | Read system configuration
Init | 10 |  |  |  | CO2 Spülung Elektrolyseur
Init | 11 |  |  |  | CO2 Spülung Reaktor
Control | 20 |  |  |  | Start Produktion und Regelung
Control | 20 |  |  |  | Calculate number of steps
Control | 20 | x |  |  | Start MAF
Control | 20 | x |  |  | Abfrage Notaus
Control | 20 | x |  |  | Berechnung Zeit für prozentuale Gasmischung H2 & CO2
Control | 20 | x |  |  | Berechnung MIF Counter
Control | 20 | x | x |  | Berechnung neue Loop-Timer
Control | 20 | x | x | x | Sensoren auslesen: Druck; Temperatur; Feuchtigkeit
Control | 20 | x | x | x | Berechnung der Sensorwerte
Control | 20 | x | x | x | Temperaturregelung Ofen ====>>>> SW_CMD_T_Ofen
Control | 20 | x | x | x | Temperaturregelung Lüfter ====>>>> SW_CMD_Lüfter
Control | 20 | x | x | x | Temperaturregelung Kühler ====>>>> SW_CMD_Kühler
Control | 20 | x | x | x | Regelparameter ===>>> SW_CMD_H2_Gen [H2]-Erzeugung
Control | 20 | x | x | x | Regelparameter ===>>> [H2,CO2]-Gemisch prozentuale Regelung über Time_H2_CO2_input
Control | 20 | x | x | x | Regelparameter ===>>> Einlassventil Gas Reaktor in
Control | 20 | x | x | x | Ausgabe der Parameter an HW (OFF, ON): ===>>> Ofen, Kühler, Lüfter,Ventile
Control | 20 | x |  |  | Speichern der Werte
Control | 20 | x |  |  | Anzeigen der Parameter für Step, Time, Eingabe, Control, Temperatur, Druck, Feuchte, Gas etc
Control | 20 | x |  |  | Increment Step und Zeile
Control | 20 | x |  |  | Increment MIF (Step und Zeile)
Fail | 40 |  |  |  | Notaus & Shutdown

Sheet: Kalibartion_TH
Kanal (8) | Kanal (8) |  | Gemessen
TH_raw_Value /4 | TH_[°C] | TH_berechnet | TH_[°C] | mV | °C
0 | 0.0 | 0.000 | Offset | 0.000 | 0
1 | 0.0 | 0.000 | Offset | 0.432 | 10
2 | 0.0 | 0.000 | Offset | 0.833 | 20
3 | 0.0 | 0.000 | Offset | 1.238 | 30
4 | 0.0 | 0.000 | Offset | 1.647 | 40
5 | 0.0 | 0.000 | Offset | 2.058 | 50
6 | 0.0 | 0.000 | Offset | 2.472 | 60
7 | 0.0 | 0.000 | Offset | 2.886 | 70
8 | 0.0 | 0.000 | Offset | 3.302 | 80
9 | 0.0 | 0.000 | Offset | 3.717 | 90
10 | 0.0 | 0.000 | Offset | 4.131 | 100
11 | 0.0 | 0.000 | Offset | 4.544 | 110
12 | 0.0 | 0.000 | Offset | 4.955 | 120
13 | 0.0 | 0.000 | Offset | 5.364 | 130
14 | 0.0 | 0.000 | Offset | 5.770 | 140
15 | 0.0 | 0.000 | Offset | 6.174 | 150
16 | 0.0 | 0.000 | Offset | 6.575 | 160
17 | 0.0 | 0.000 | Offset | 6.976 | 170
18 | 0.0 | 0.000 | Offset | 7.375 | 180
19 | 0.0 | 0.000 | Offset | 7.774 | 190
20 | 0.0 | 0.000 | Offset | 8.174 | 200
21 | 0.0 | 0.000 | Offset | 8.574 | 210
22 | 0.0 | 0.000 | Offset | 8.975 | 220
23 | 0.0 | 0.000 | Offset | 9.378 | 230
24 | 0.0 | 0.000 | Offset | 9.782 | 240
25 | 0.0 | 0.000 | Offset | 10.189 | 250
26 | 0.0 | 0.000 | Offset | 10.597 | 260
27 | 0.0 | 0.000 | 0 | 11.006 | 270
28 | 1.0 | 0.962 |  | 11.417 | 280
29 | 1.9 | 0.962 |  | 11.830 | 290
30 | 2.9 | 0.962 |  | 12.244 | 300
31 | 3.8 | 0.962 |  | 12.659 | 310
32 | 4.8 | 0.962 |  | 13.075 | 320
33 | 5.8 | 0.962 |  | 13.492 | 330
34 | 6.7 | 0.962 |  | 13.910 | 340
35 | 7.7 | 0.962 |  | 14.328 | 350
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
1003 | 1000.0
1004 | 1000.0
1005 | 1000.0
1006 | 1000.0
1007 | 1000.0
1008 | 1000.0
1009 | 1000.0
1010 | 1000.0
1011 | 1000.0
1012 | 1000.0
1013 | 1000.0
1014 | 1000.0
1015 | 1000.0
1016 | 1000.0
1017 | 1000.0
1018 | 1000.0
1019 | 1000.0
1020 | 1000.0
1021 | 1000.0
1022 | 1000.0
1023 | 1000.0

Sheet: PCA9545
P0 = 0 == Reset activ PCA9545
P0 = 1 == Reset inactiv PCA9545
P1 = 0 == Control LED on
P1 = 1 == Control LED off
P4 = 0 == Power on
P4 = 1 == Power off

Sheet: TH_K-Typ
Thermoelement Typ K
(Thermospannung in mV, bezogen auf eine Vergleichsstellentemperatur von 0°C)
 | 0 | 1 | 2 | 3 | 4 | 5 | 6 | 7 | 8 | 9 | 10
-270 | -6.458 | -6.457 | -6.456 | -6.455 | -6.453 | -6.452 | -6.450 | -6.448 | -6.446 | -6.444 | -6.441 | 0.001 | 0.001 | 0.001 | 0.002 | 0.001 | 0.002 | 0.002 | 0.002 | 0.002 | 0.003
-260 | -6.441 | -6.438 | -6.435 | -6.432 | -6.429 | -6.425 | -6.421 | -6.417 | -6.413 | -6.408 | -6.404 | 0.003 | 0.003 | 0.003 | 0.003 | 0.004 | 0.004 | 0.004 | 0.004 | 0.005 | 0.004
-250 | -6.404 | -6.399 | -6.393 | -6.388 | -6.382 | -6.377 | -6.370 | -6.364 | -6.358 | -6.351 | -6.344 | 0.005 | 0.006 | 0.005 | 0.006 | 0.005 | 0.007 | 0.006 | 0.006 | 0.007 | 0.007
-240 | -6.344 | -6.337 | -6.329 | -6.322 | -6.314 | -6.306 | -6.297 | -6.289 | -6.280 | -6.271 | -6.262 | 0.007 | 0.008 | 0.007 | 0.008 | 0.008 | 0.009 | 0.008 | 0.009 | 0.009 | 0.009
-230 | -6.262 | -6.252 | -6.243 | -6.233 | -6.223 | -6.213 | -6.202 | -6.192 | -6.181 | -6.170 | -6.158 | 0.010 | 0.009 | 0.010 | 0.010 | 0.010 | 0.011 | 0.010 | 0.011 | 0.011 | 0.012
-220 | -6.158 | -6.147 | -6.135 | -6.123 | -6.111 | -6.099 | -6.087 | -6.074 | -6.061 | -6.048 | -6.035 | 0.011 | 0.012 | 0.012 | 0.012 | 0.012 | 0.012 | 0.013 | 0.013 | 0.013 | 0.013
-210 | -6.035 | -6.021 | -6.007 | -5.994 | -5.980 | -5.965 | -5.951 | -5.936 | -5.922 | -5.907 | -5.891 | 0.014 | 0.014 | 0.013 | 0.014 | 0.015 | 0.014 | 0.015 | 0.014 | 0.015 | 0.016
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
1320 | 53.141 | 53.176 | 53.210 | 53.245 | 53.279 | 53.314 | 53.348 | 53.383 | 53.417 | 53.452 | 53.486 | 0.035 | 0.034 | 0.035 | 0.034 | 0.035 | 0.034 | 0.035 | 0.034 | 0.035 | 0.034
1330 | 53.486 | 53.521 | 53.555 | 53.590 | 53.624 | 53.659 | 53.693 | 53.727 | 53.762 | 53.796 | 53.830 | 0.035 | 0.034 | 0.035 | 0.034 | 0.035 | 0.034 | 0.034 | 0.035 | 0.034 | 0.034
1340 | 53.830 | 53.865 | 53.899 | 53.933 | 53.968 | 54.002 | 54.036 | 54.070 | 54.105 | 54.139 | 54.173 | 0.035 | 0.034 | 0.034 | 0.035 | 0.034 | 0.034 | 0.034 | 0.035 | 0.034 | 0.034
1350 | 54.173 | 54.207 | 54.241 | 54.275 | 54.310 | 54.344 | 54.378 | 54.412 | 54.446 | 54.480 | 54.514 | 0.034 | 0.034 | 0.034 | 0.035 | 0.034 | 0.034 | 0.034 | 0.034 | 0.034 | 0.034
1360 | 54.514 | 54.548 | 54.582 | 54.616 | 54.650 | 54.684 | 54.718 | 54.752 | 54.786 | 54.820 | 54.854 | 0.034 | 0.034 | 0.034 | 0.034 | 0.034 | 0.034 | 0.034 | 0.034 | 0.034 | 0.034
1370 | 54.854 | 54.888 | 54.922

Sheet: STM
0.485
4.55
