CodingGhost/CCIPN/CCMR/Docs/Visio-Zayed_SP_2V10.pdf

# Methanisierung 1

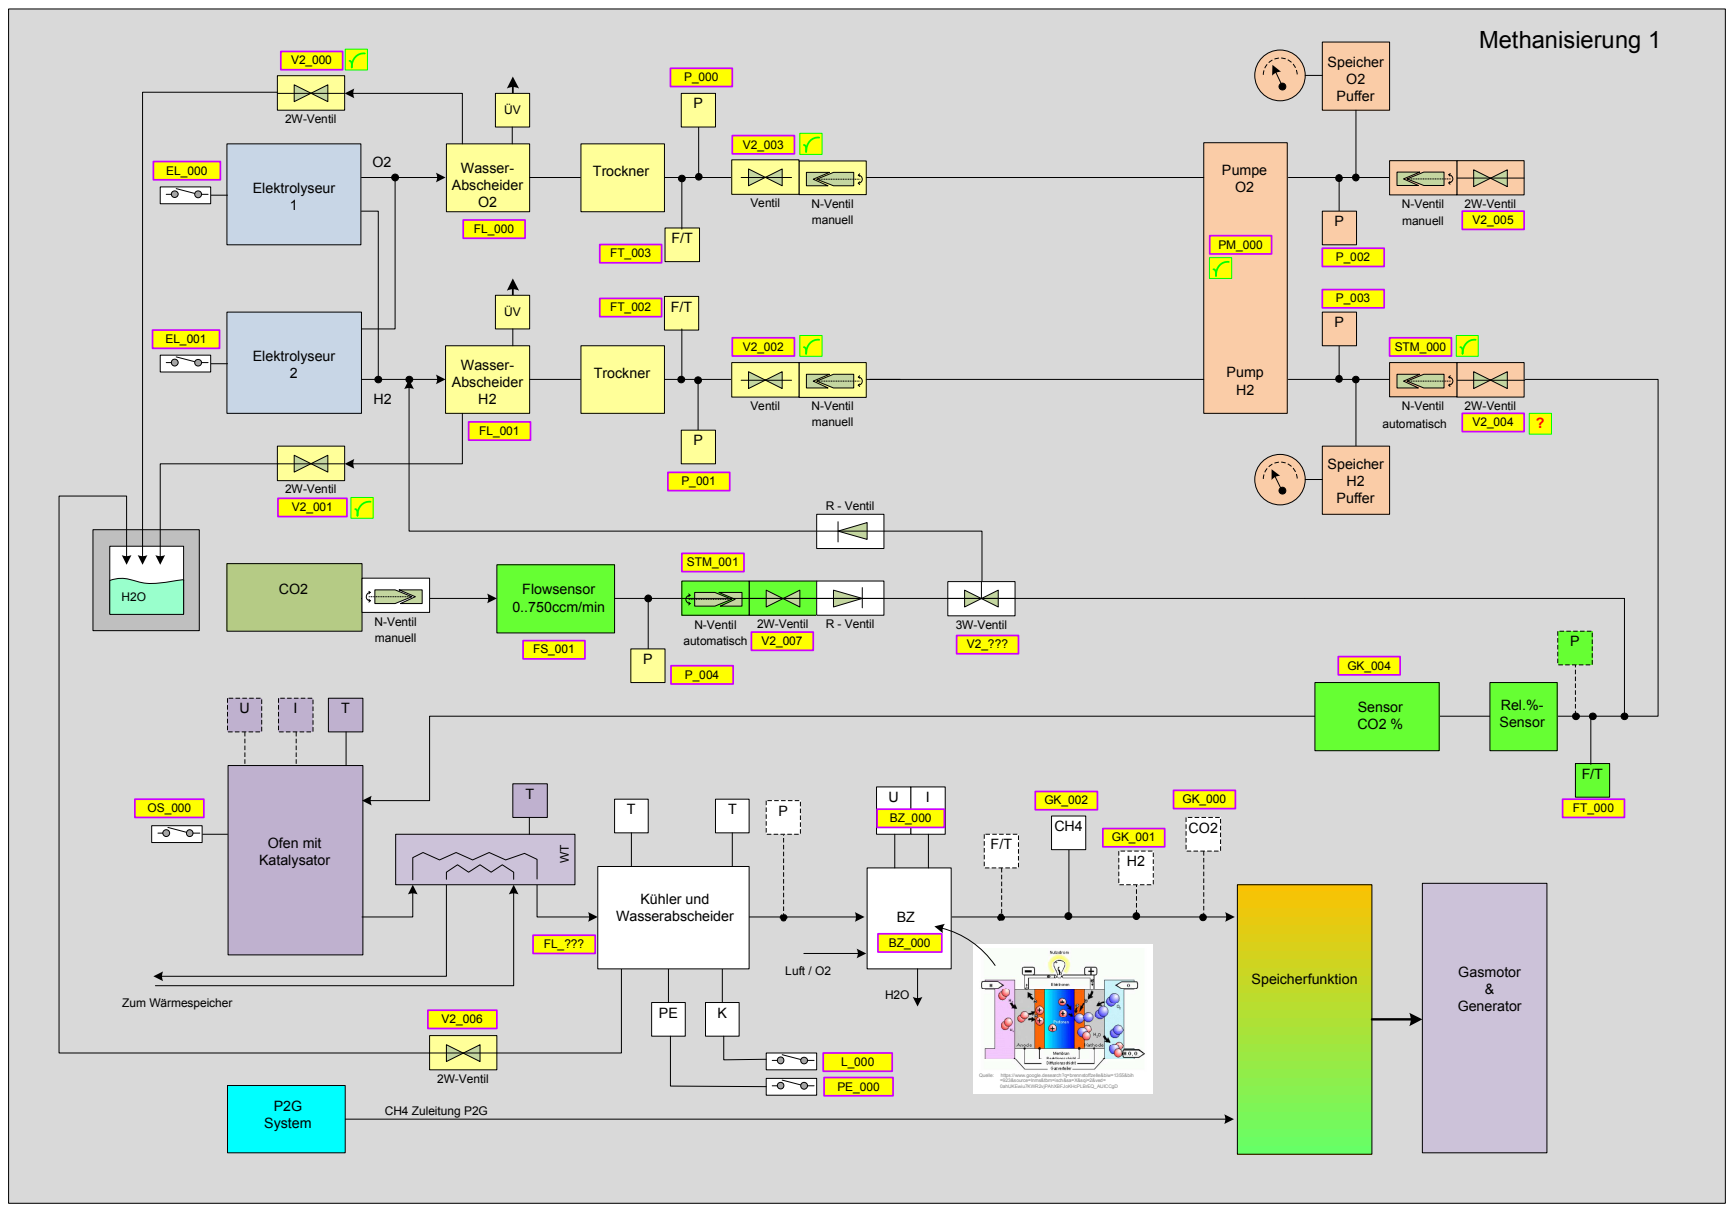
[picture p12: page 1]
Elektrolyseur 2; Elektrolyseur 1; Wasser-; Abscheider O2; Trockner; Pump H2; N-Ventil; Pumpe O2; Ventil; Speicher O2 Puffer; Speicher H2 Puffer; 2W-Ventil; manuell; automatisch; Ofen mit Katalysator; Speicherfunktion; CH4 Zuleitung P2G; Gasmotor & Generator; P2G System; Luft / O2; H2O Zum Wärmespeicher; N-Ventil manuell; Kühler und Wasserabscheider; STM_000; STM_001; Flowsensor 0..750ccm/min; R - Ventil; Quelle:; https://www.google.desearch?q=brennstoffzelle&biw=1355&bih; Rel.%- Sensor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

Trockner Wasser- Abscheider

=923&source=lnms&tbm=isch&sa=X&sqi=2&ved=
0ahUKEwiu7KWR2vjPAhXBFJoKHcPLBrEQ_AUICCgD

# Methanisierung

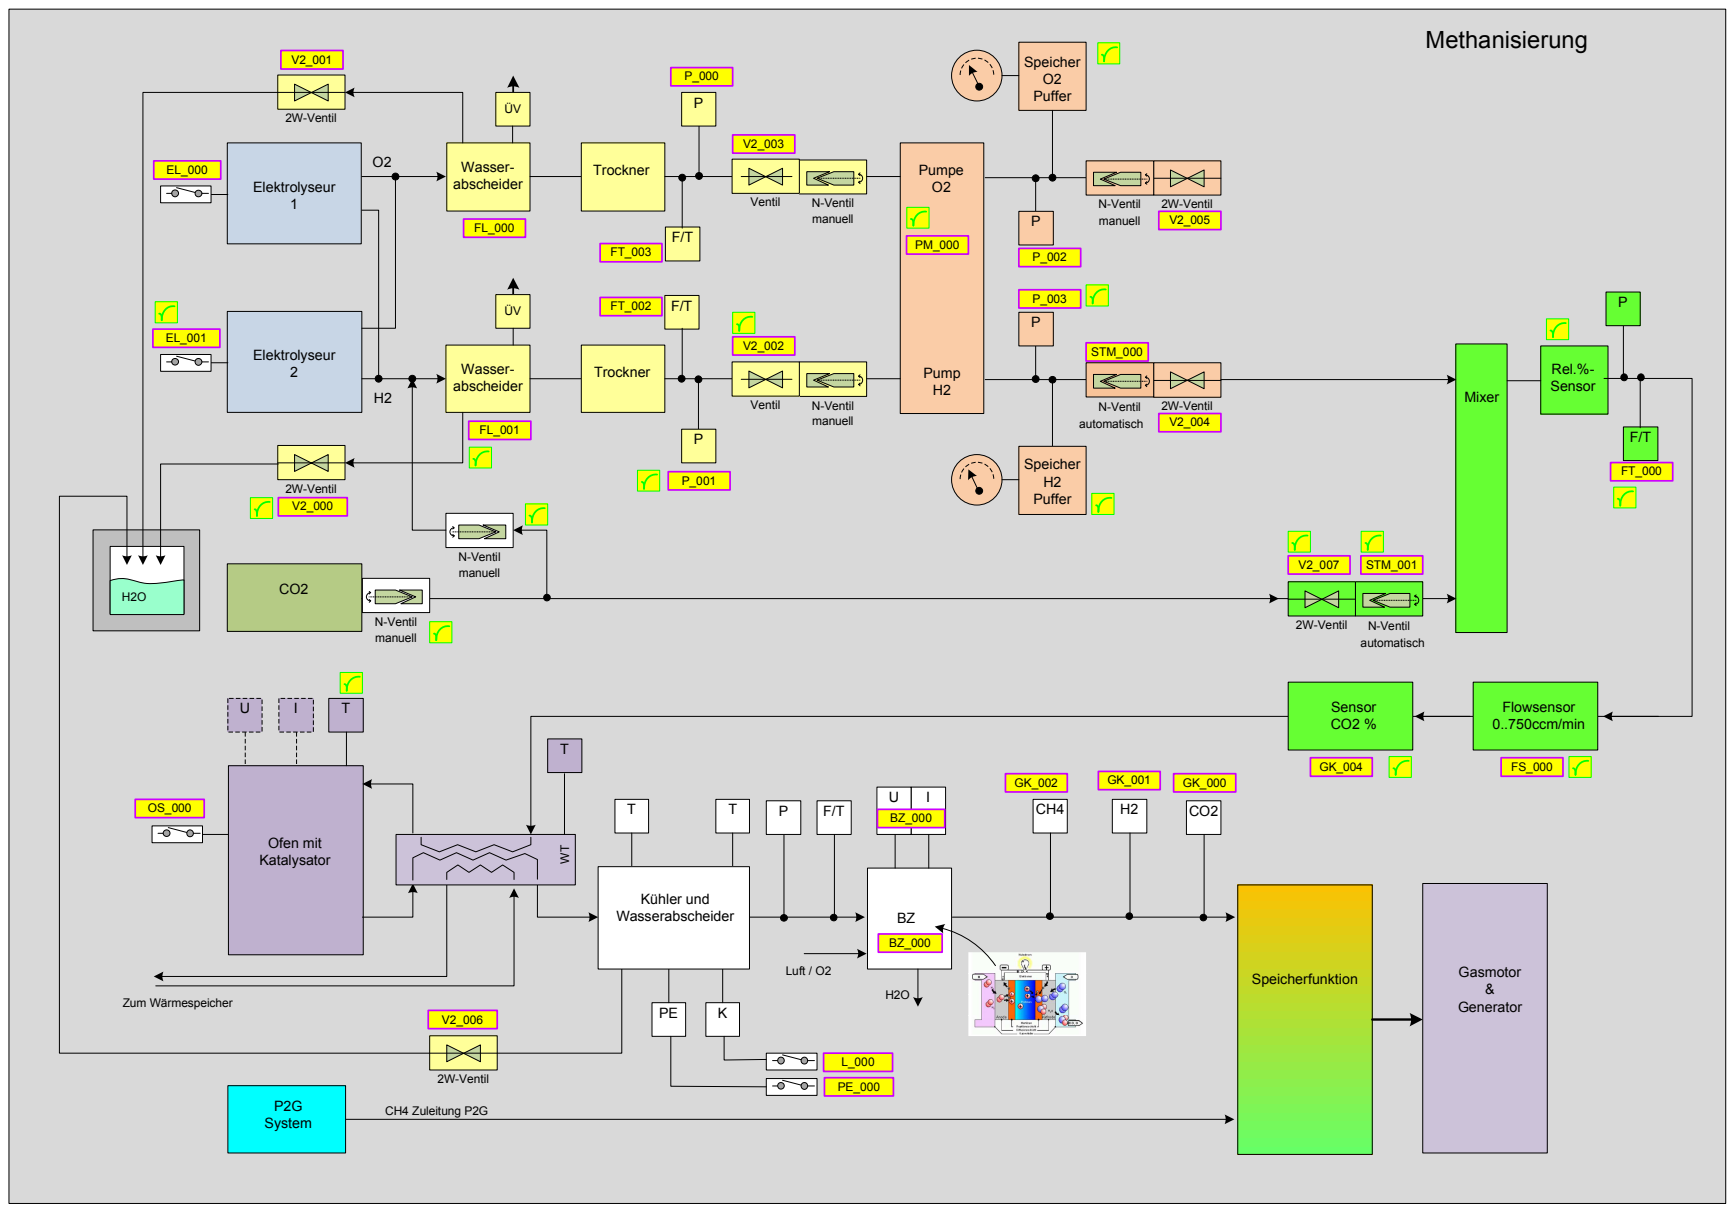
[picture p13: page 2]
Elektrolyseur 2; Elektrolyseur 1; Wasser-; Trockner; abscheider; Pump H2; N-Ventil; Pumpe O2; Ventil; Speicher O2 Puffer; Speicher H2 Puffer; 2W-Ventil; Mixer; Rel.%- Sensor; manuell; automatisch; N-Ventil manuell; Ofen mit Katalysator; Speicherfunktion; CH4 Zuleitung P2G; Gasmotor & Generator; Flowsensor 0..750ccm/min; Sensor CO2 %; P2G System; Luft / O2; H2O Zum Wärmespeicher; Kühler und Wasserabscheider; STM_000; STM_001

# Methanisierung 1

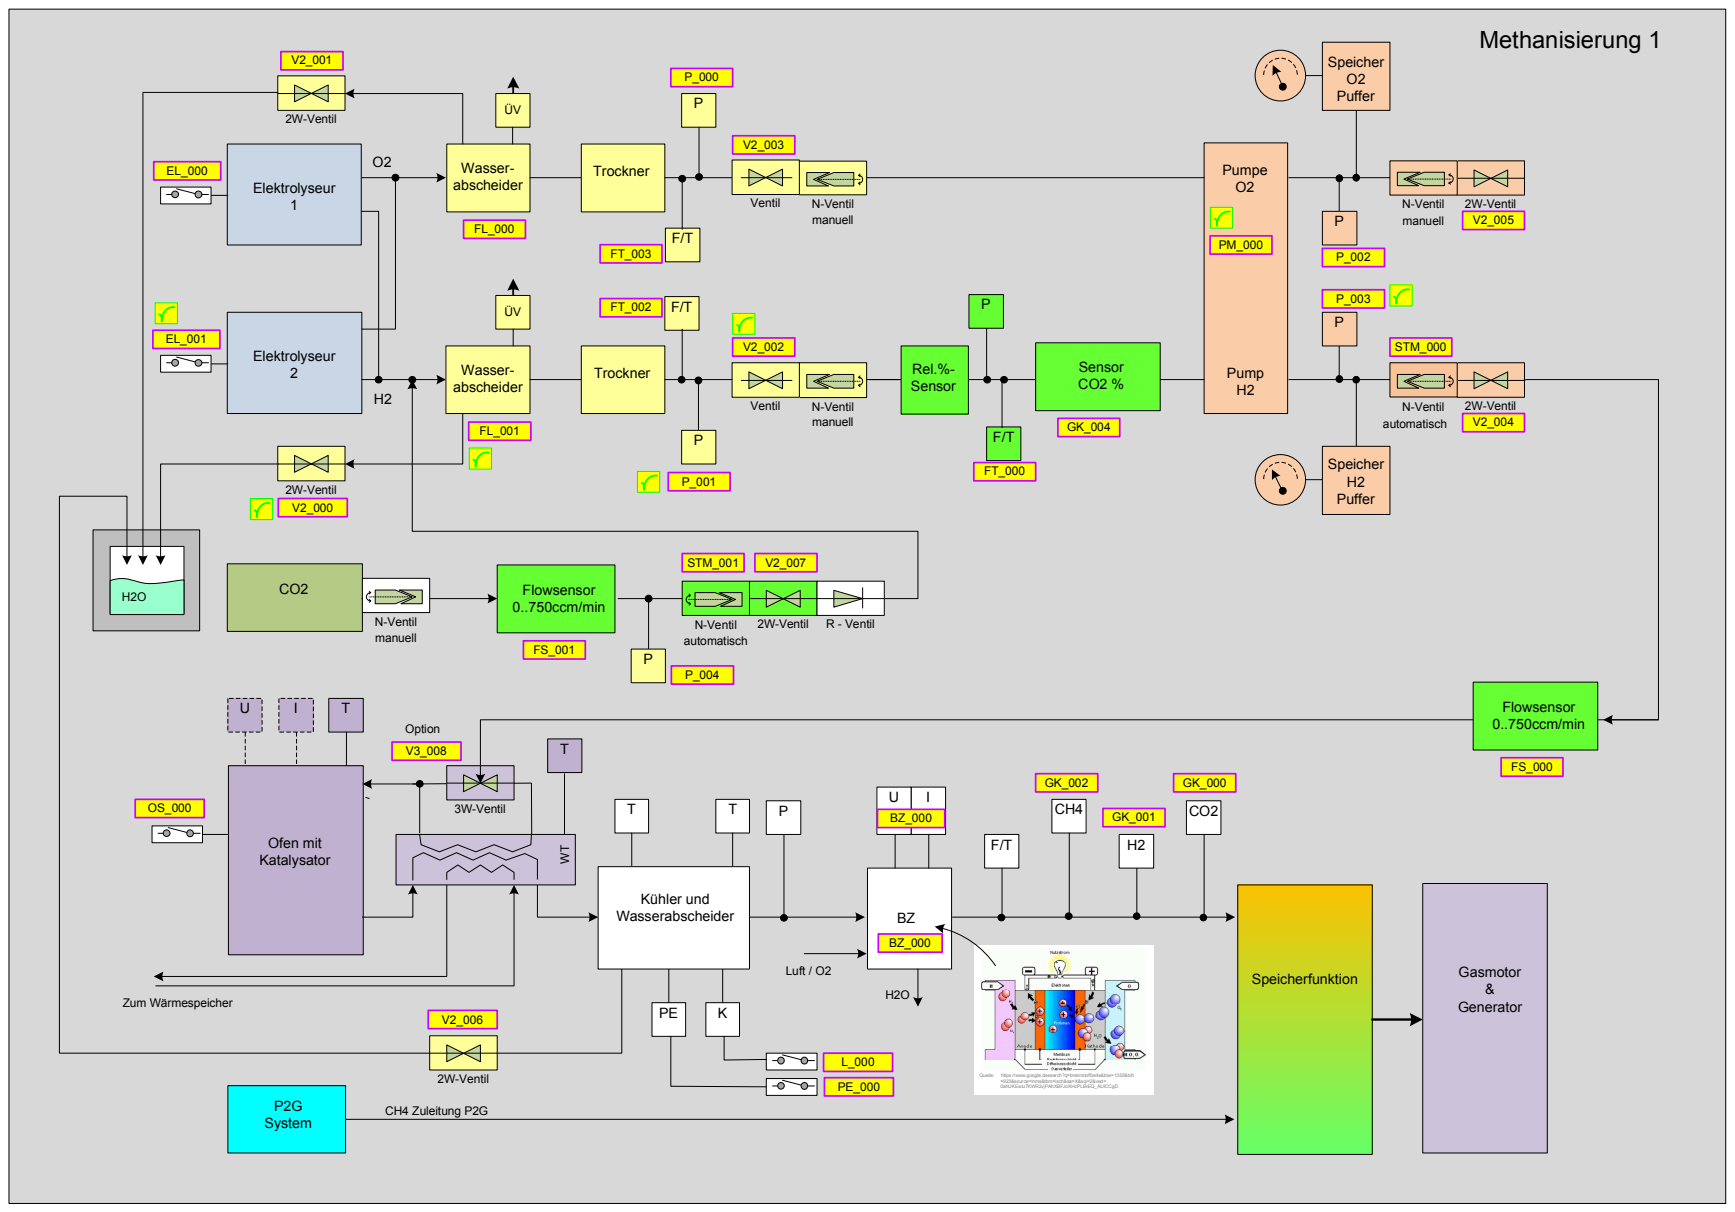
[picture p14: page 3]
Elektrolyseur 2; Elektrolyseur 1; Wasser-; Trockner; abscheider; Pump H2; N-Ventil; Pumpe O2; Ventil; Speicher O2 Puffer; Speicher H2 Puffer; 2W-Ventil; manuell; automatisch; Ofen mit Katalysator; Speicherfunktion; CH4 Zuleitung P2G; Gasmotor & Generator; Sensor CO2 %; P2G System; Luft / O2; H2O Zum Wärmespeicher; Option; N-Ventil manuell; 3W-Ventil; Kühler und Wasserabscheider; STM_000; STM_001; Rel.%- Sensor; Flowsensor 0..750ccm/min; R - Ventil; Quelle: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

=923&source=lnms&tbm=isch&sa=X&sqi=2&ved=
0ahUKEwiu7KWR2vjPAhXBFJoKHcPLBrEQ_AUICCgD

# Gasspeicher

# Volumen

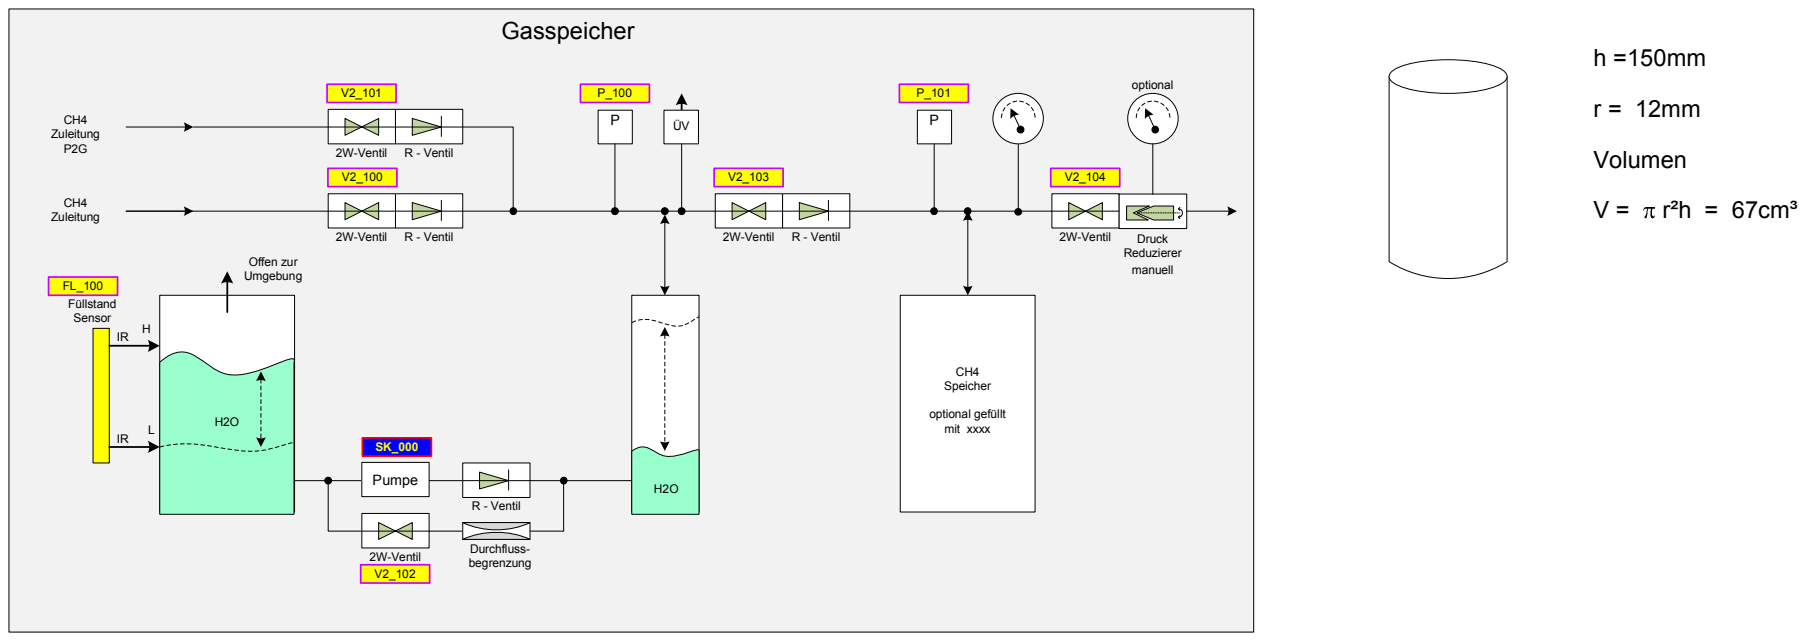
[picture p15: page 4]
2W-Ventil; Druck Reduzierer; manuell; H2O Pumpe; R - Ventil; optional; Offen zur Umgebung; Füllstand Sensor; CH4 Zuleitung; Durchfluss- begrenzung; ÜV CH4 Zuleitung; CH4 Speicher; optional gefüllt mit xxxx; r²h = 67cm³

# Gasmotor

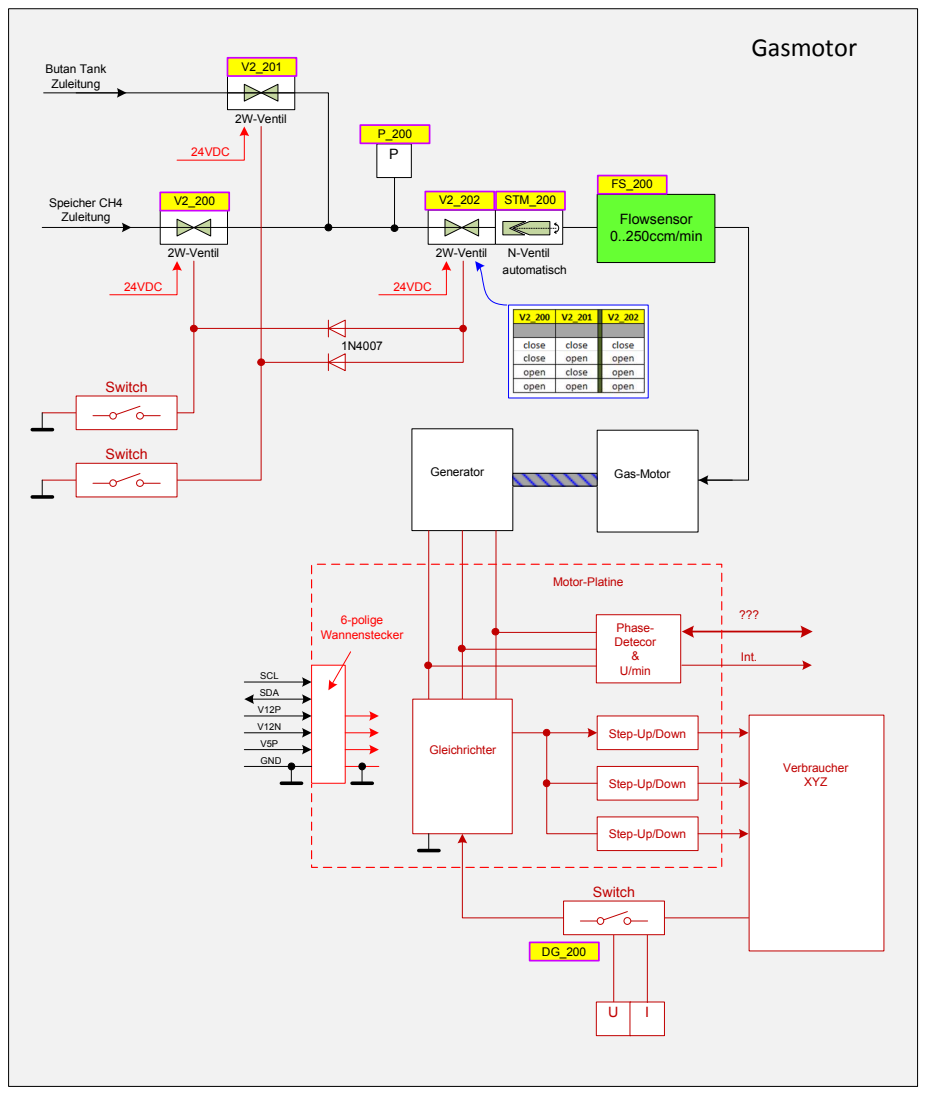
[picture p16: page 5]
2W-Ventil; N-Ventil; Flowsensor 0..250ccm/min; Generator; Gas-Motor; Gleichrichter; Phase- Detecor & U/min; Switch; Verbraucher XYZ; Butan Tank Zuleitung; Speicher CH4 Zuleitung; Motor-Platine; Int.; SCL; SDA; GND; 6-polige Wannenstecker; 24VDC; automatisch; STM_200

Step-Up/Down

## Raspberry

PI

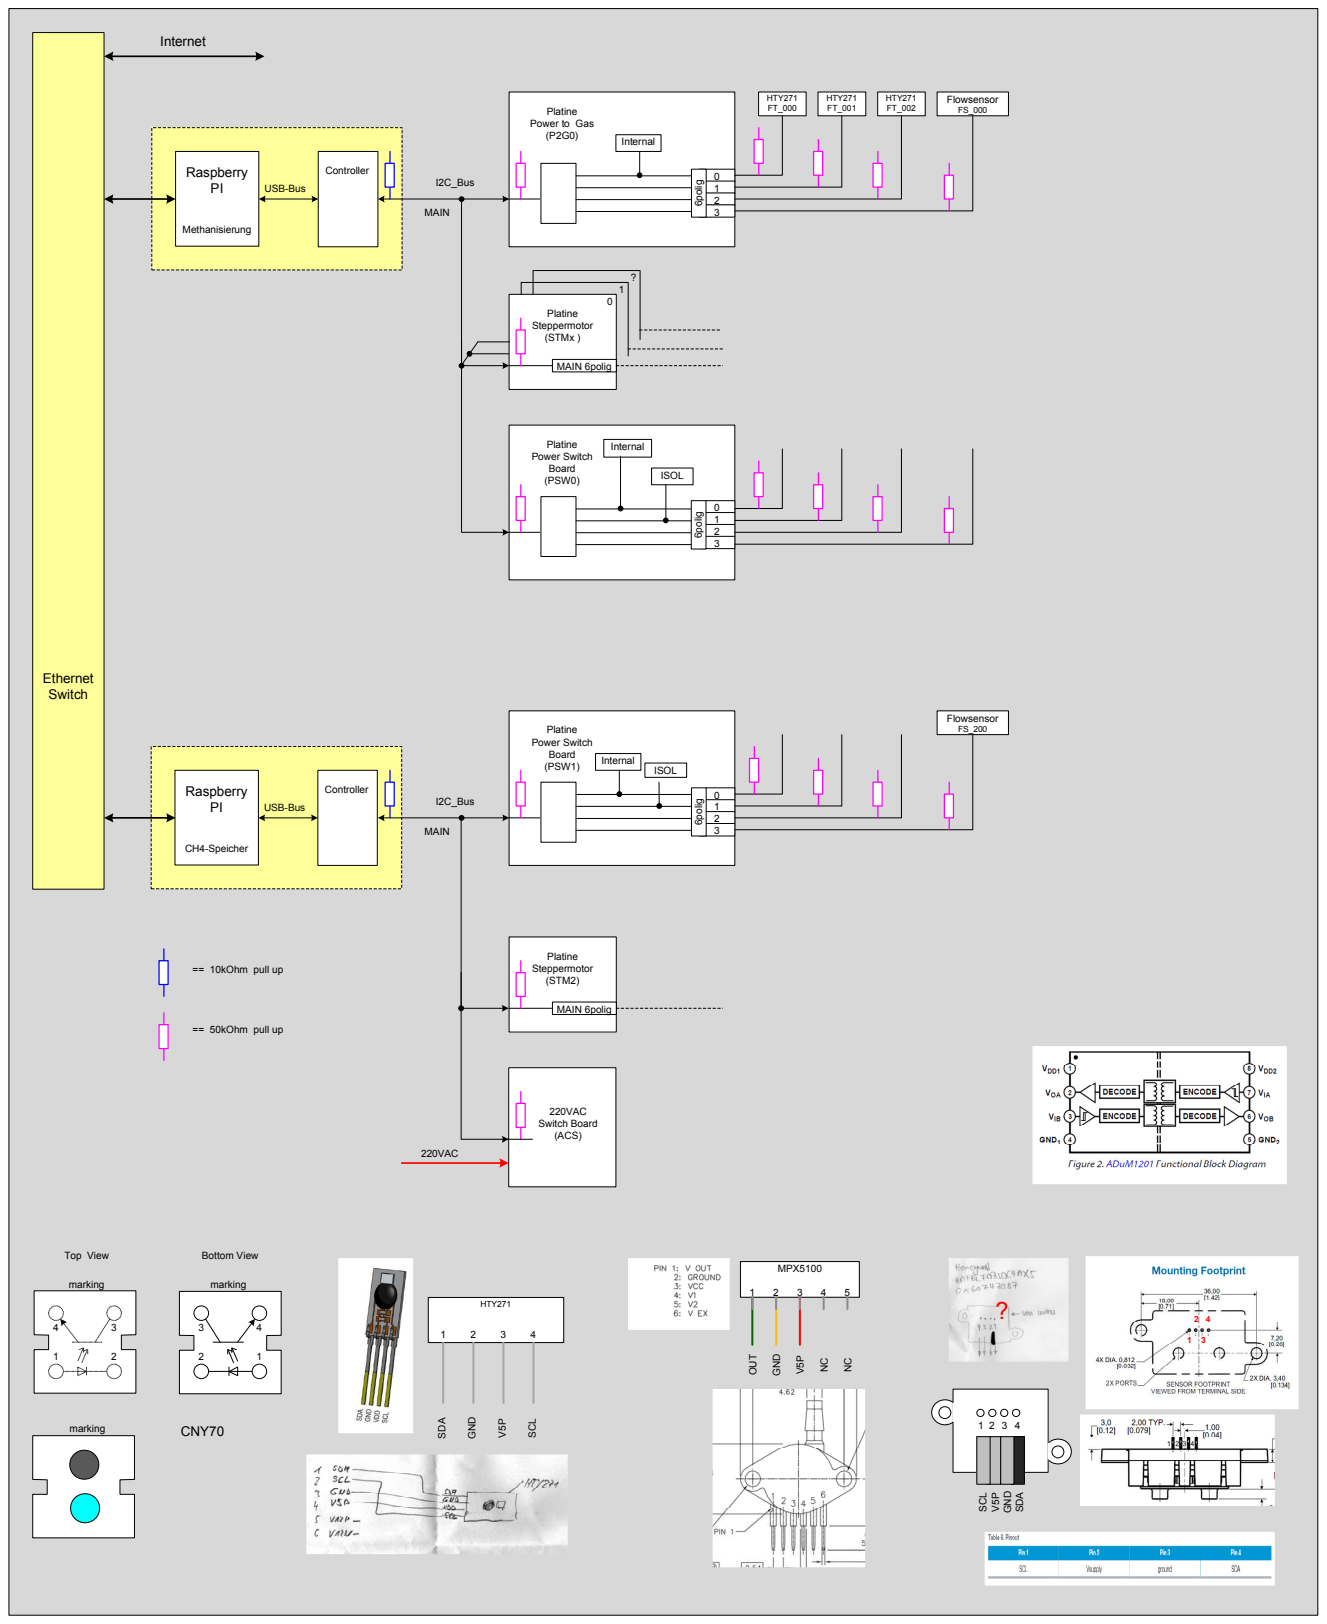
[picture p17: page 6]
Platine Power to Gas (P2G0); Platine Steppermotor (STMx ); Controller; I2C_Bus; Platine Power Switch Board (PSW0); MAIN; Internal; ISOL; USB-Bus; MAIN 6polig; HTY271 FT_000; HTY271 FT_001; HTY271 FT_002; Ethernet Switch; Internet; Flowsensor; 6polig 6polig; Methanisierung; MPX5100 GND; 5 OUT; V⁵P; HTY271; GND; 4 SDA; SCL; Raspberry PI; CH4-Speicher; 220VAC Switch Board (ACS); 6polig; Platine Power Switch Board (PSW1); 220VAC; Platine Steppermotor (STM2); == 10kOhm pull up; == 50kOhm pull up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

1 2 3 4 SCL V⁵P GND SDA

## I2C-Bus-Struktur P2G-Board

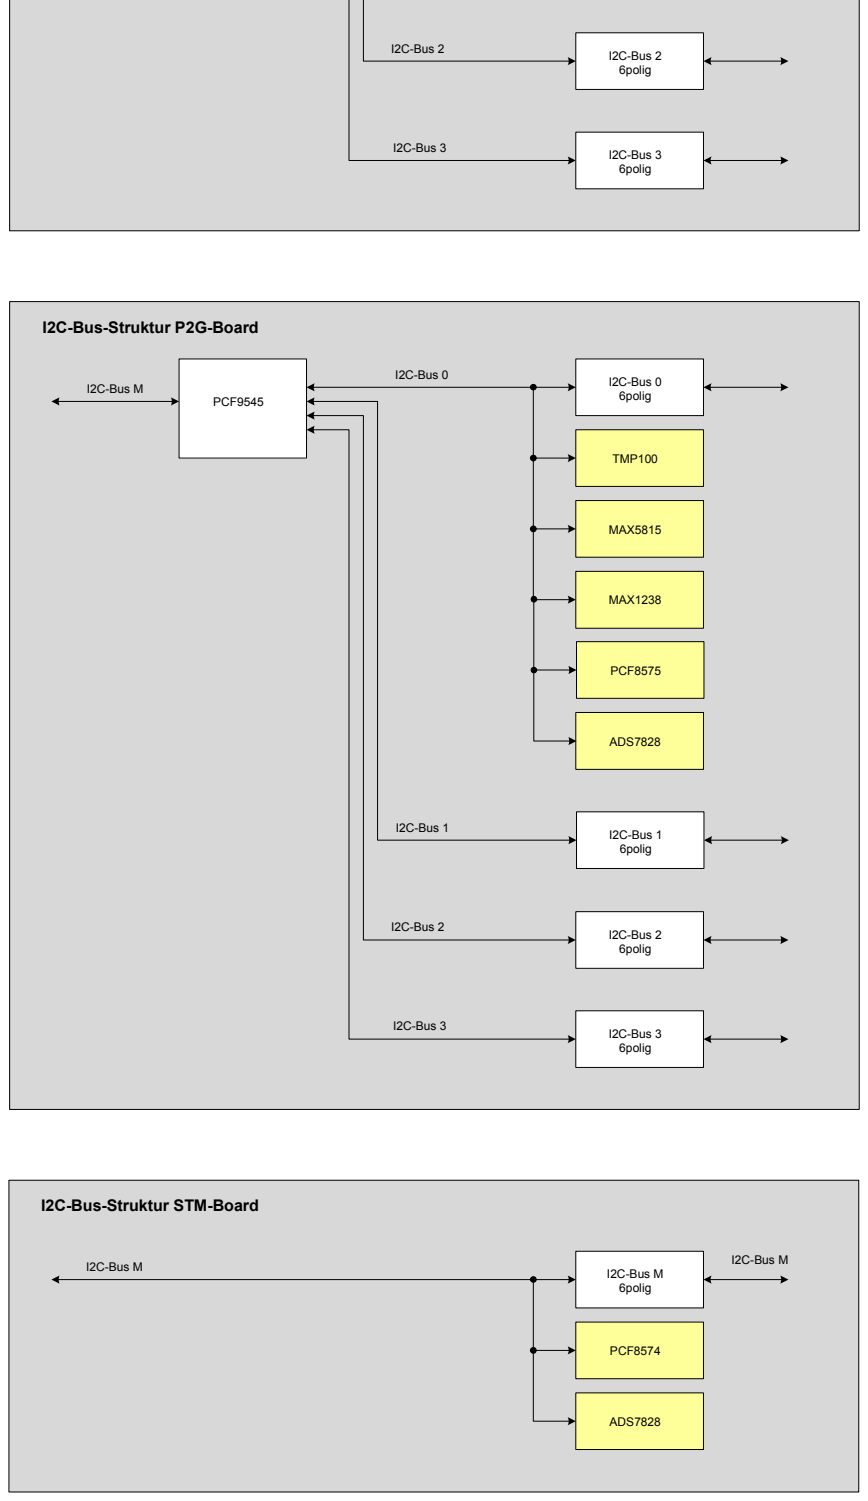
[picture p18: page 7]
I2C-Bus 2 6polig; I2C-Bus 3 6polig; I2C-Bus 2; I2C-Bus 3; MAX1238; ADS7828; MAX5815; TMP100; I2C-Bus 0 6polig; I2C-Bus 1 6polig; PCF9545; I2C-Bus M; I2C-Bus 0; I2C-Bus 1; PCF8575; I2C-Bus M 6polig; PCF8574

I2C-Bus-Struktur STM-Board

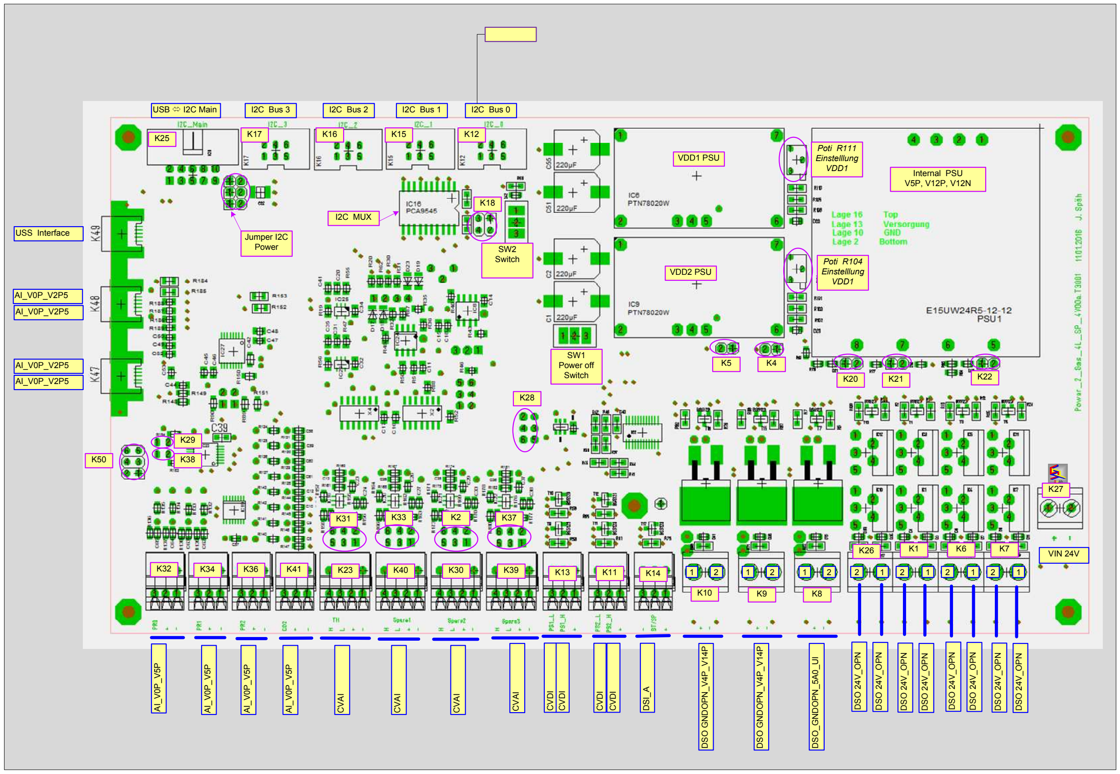
[picture p19: page 8]

AI_V0P_V5P

DSO GNDOPN_V4P_V14P
DSO_GNDOPN_5A0_UI

CVDI

CVDI
CVDI

CVDI

DSI_A

DSO 24V_OPN

CVAI

VIN 24V

AI_V0P_V2P5

USB | I2C Main | I2C Bus 3 | I2C Bus 2 | I2C Bus 1 | I2C Bus 0

USS Interface

I2C MUX

Jumper I2C
Power

VDD2 PSU

VDD1 PSU

Internal PSU
V5P, V12P, V12N

AI_V0P_V2P5

AI_V0P_V2P5

AI_V0P_V2P5

AI_V0P_V5P

AI_V0P_V5P

AI_V0P_V5P

CVAI

CVAI

CVAI

DSO GNDOPN_V4P_V14P
DSO 24V_OPN
DSO 24V_OPN
DSO 24V_OPN

DSO 24V_OPN
DSO 24V_OPN
DSO 24V_OPN
DSO 24V_OPN
K5 | K4
K20 | K21 | K22

K50

K32 | K34 | K36 | K41 | K23 | K40 | K30 | K39 | K13 | K11 | K14
K10 | K9 | K8
K26 | K1 | K6 | K7
1 | 2 | 1 | 2 | 1 | 2 | 2 | 1 | 2 | 1 | 2 | 1 | 2 | 1

SW1
Power off
Switch

K28

K29

K38

K18

K17 | K16 | K15 | K12 K25

K27

K31 | K33 | K2 | K37

Poti R111
Einstelllung
VDD1

Poti R104
Einstelllung
VDD1

SW2
Switch

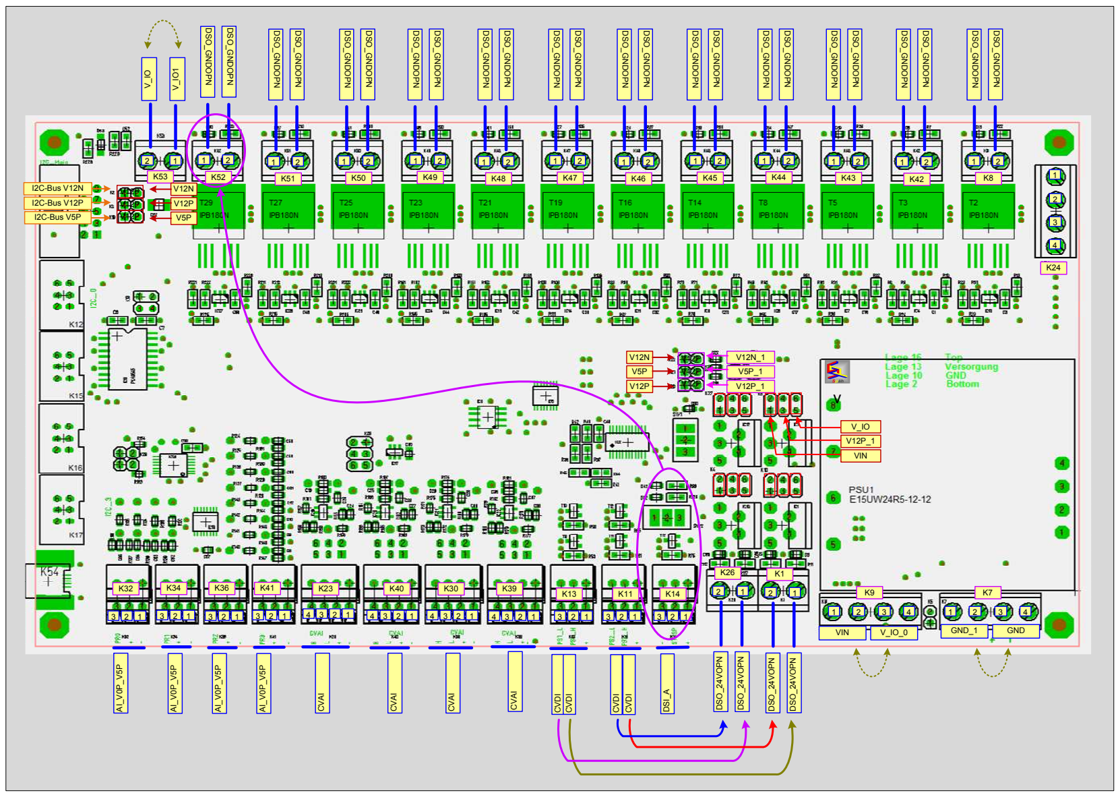
[picture p20: page 9]
DSO_GNDOPN; DSO_24VOPN; CVAI; CVDI; DSI_A; VIN; GND_1; GND; I2C-Bus V5P; I2C-Bus V12P; I2C-Bus V12N

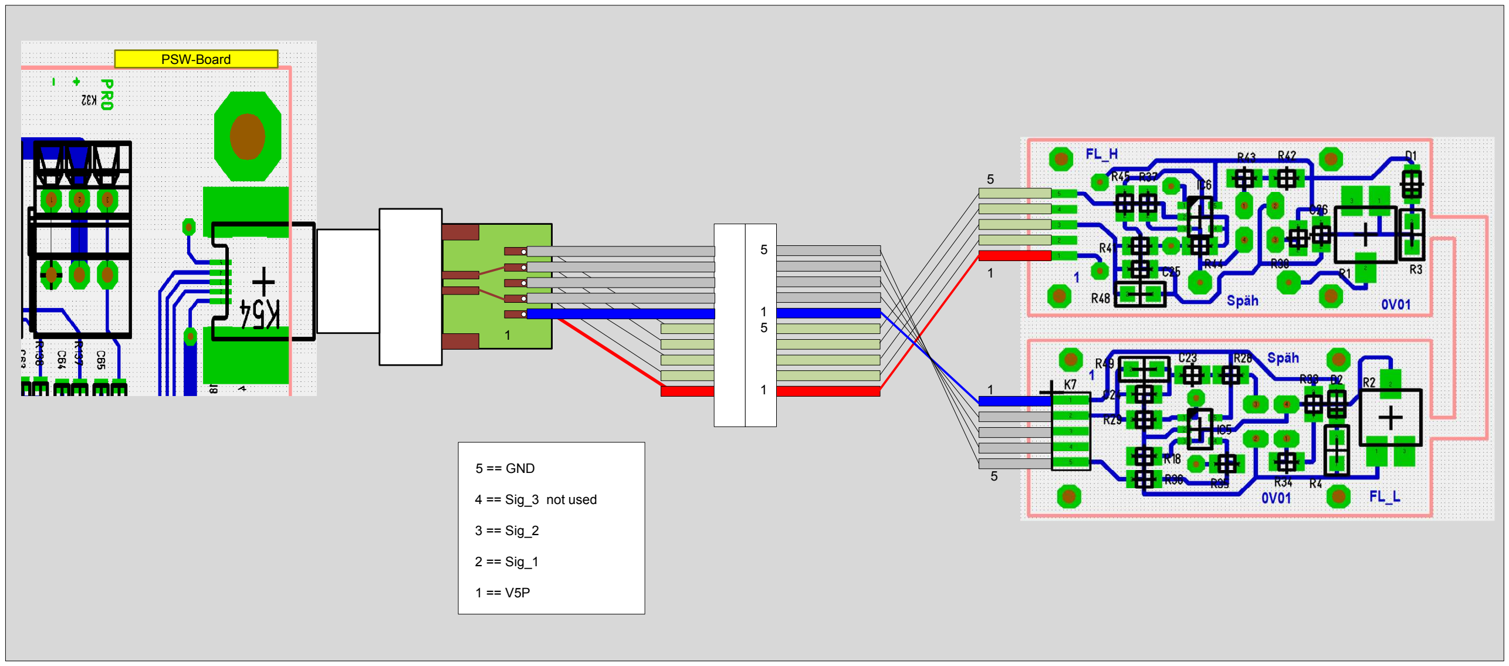
[picture p21: figure]
PSW-Board; 5 == GND; 4 == Sig_3 not used; 3 == Sig_2; 2 == Sig_1
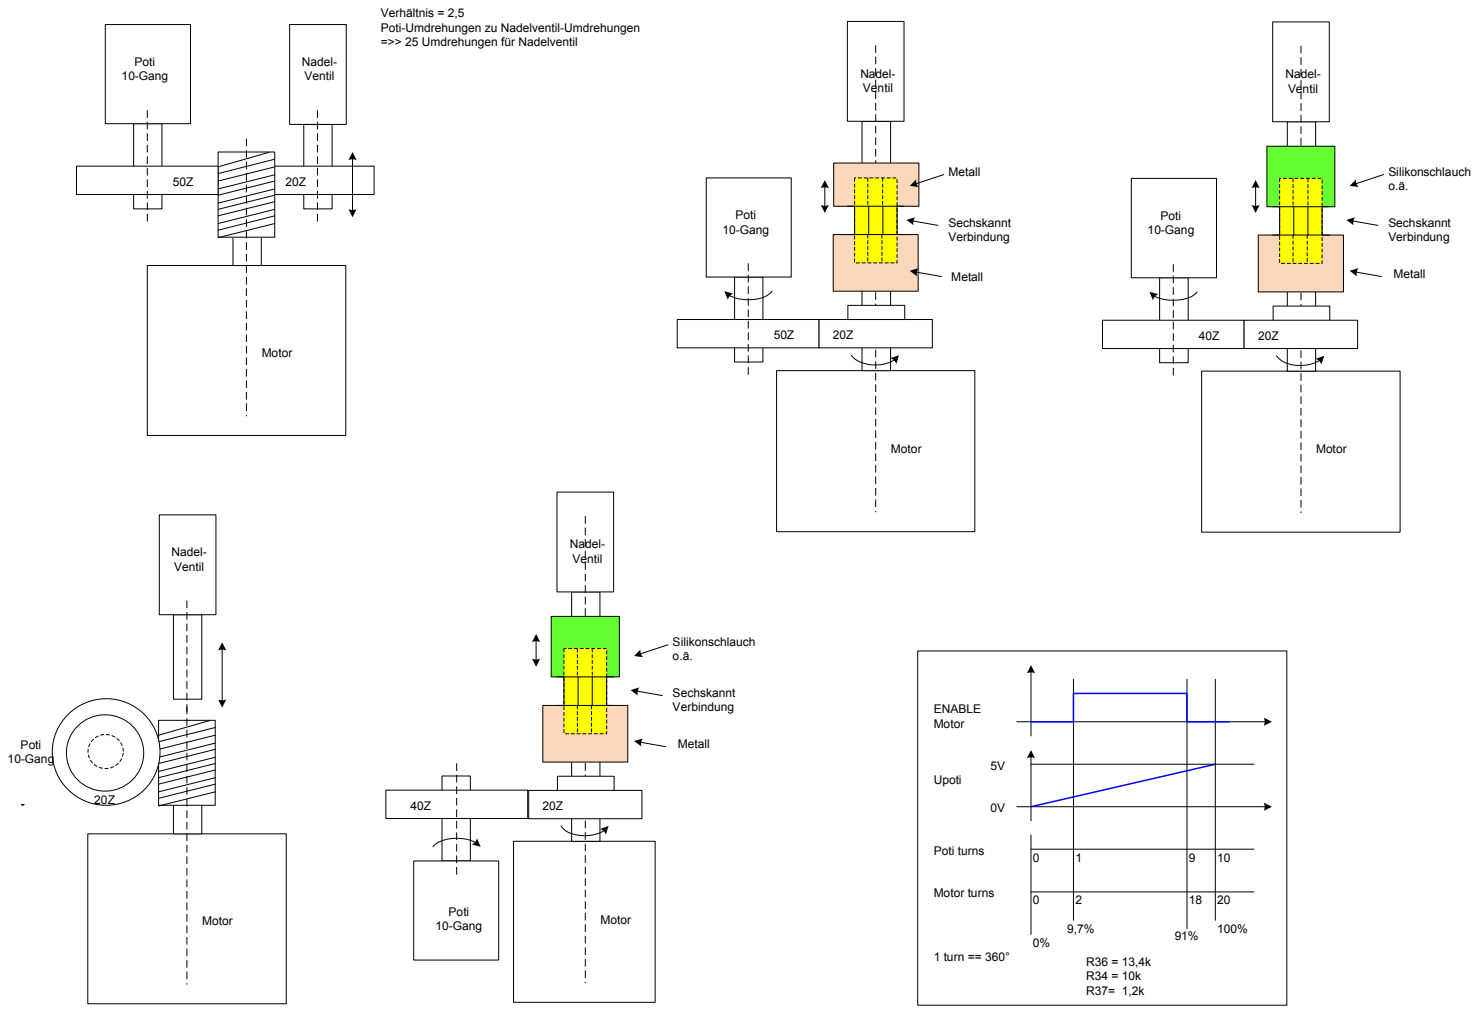
[picture p22: page 11]
Poti 10-Gang; Nadel- Ventil; Motor; Sechskannt Verbindung; Metall; Silikonschlauch o.ä.; Upoti; ENABLE Motor; Poti turns; 0 Motor turns; 1 turn == 360°

Verhältnis = 2,5
Poti-Umdrehungen zu Nadelventil-Umdrehungen
=>> 25 Umdrehungen für Nadelventil

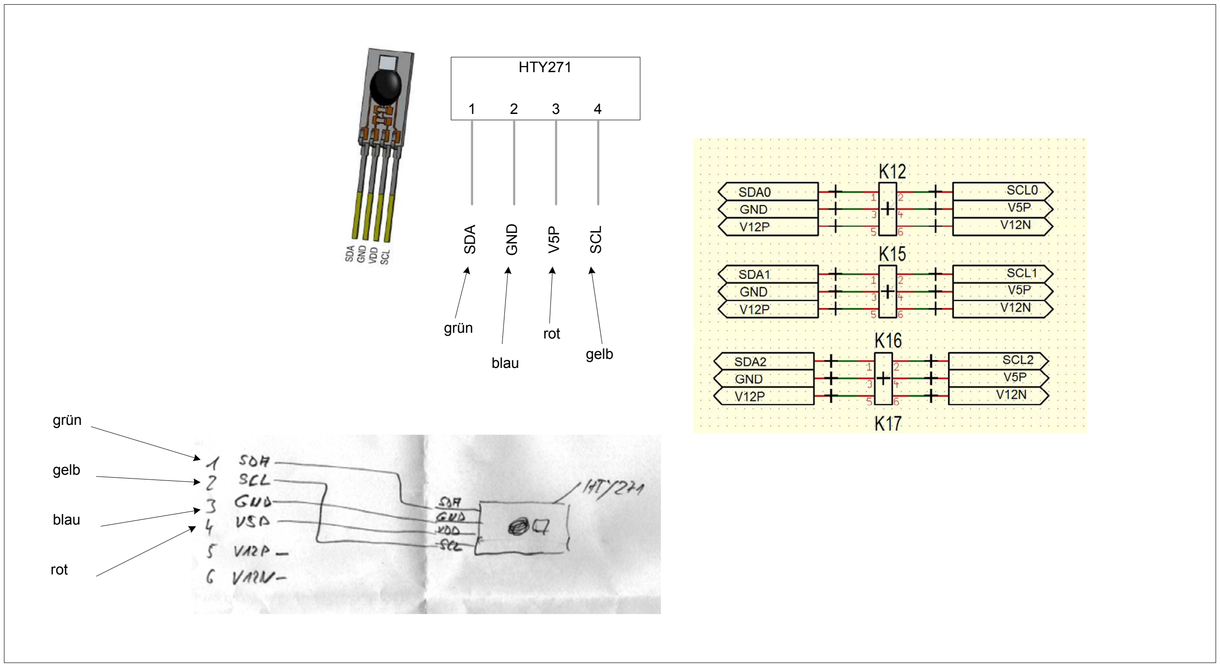
[picture p23: figure]
grün; gelb; blau; rot; HTY271; GND; 4 SDA; V⁵P; SCL

Methanisierung | Speicher | Gaskraftwerk

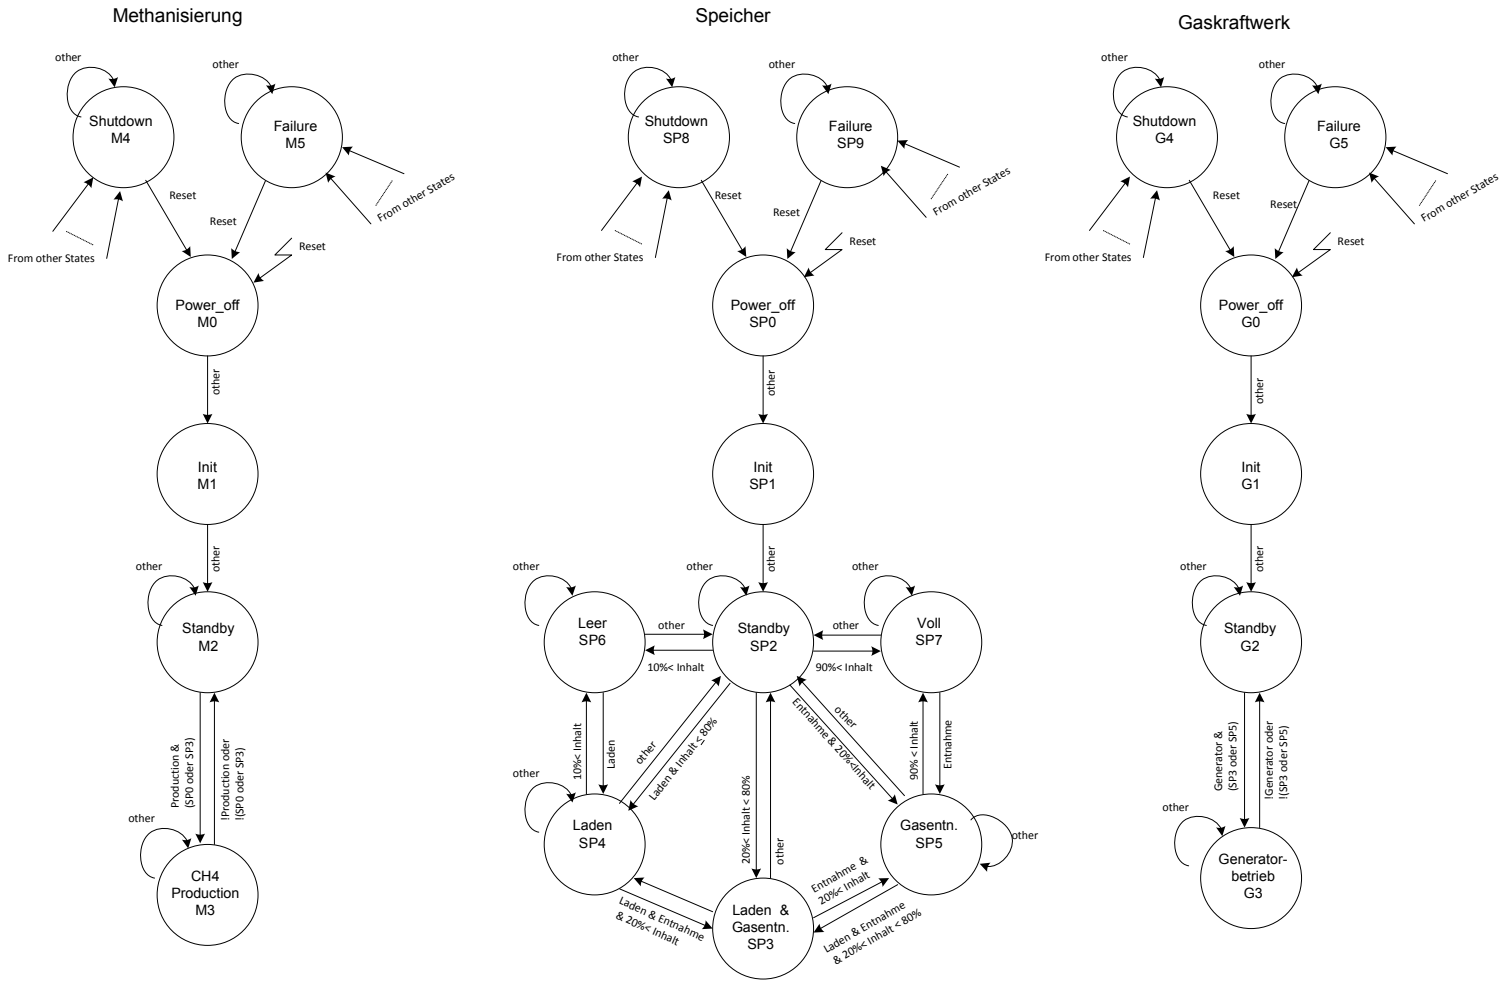
[picture p24: page 13]
Power_off M0; Failure M5; Init M1; Standby M2; CH4 Production M3; Shutdown M4; Power_off G0; Init G1; Standby G2; Generator- betrieb G3; Power_off SP0; Init SP1; Standby SP2; Laden & Gasentn. SP3; Failure SP9; Shutdown SP8; Failure G5; Shutdown G4; Laden SP4; Gasentn. SP5; Leer SP6; Voll SP7; Entnahme & 20%<Inhalt; 10%< Inhalt; 90% < Inhalt; Laden & Entnahme & 20%< Inhalt < 80%; Entnahme & 20%< Inhalt; other; Laden; 90%< Inhalt; other other; Reset; Production &; (SP0 oder SP3); Generator &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

From other States From other States From other States

From other States

Entnahme other other

20%< Inhalt < 80% Laden & Inhalt < 80%

Laden & Entnahme & 20%< Inhalt

# Übersicht Elektronik P

2

G

Switch

# Übersicht Elektronik P2G

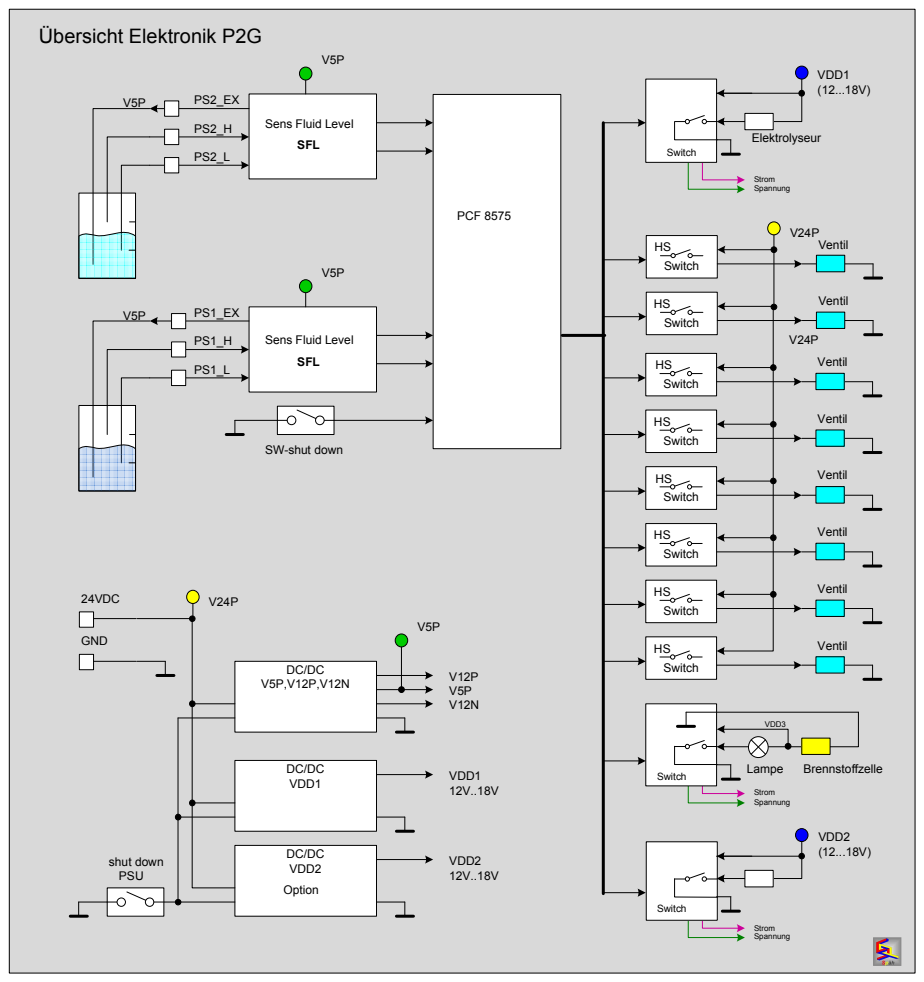
[picture p25: page 16]
Strom Spannung; Switch; Ventil; Elektrolyseur; VDD1 (12...18V); SFL; PCF 8575; VDD1; VDD1 12V..18V; Brennstoffzelle; VDD3; VDD2; VDD2 12V..18V; Option; shut down PSU; Lampe; VDD2 (12...18V); 24VDC; GND

Sens Fluid Level

SW-shut down

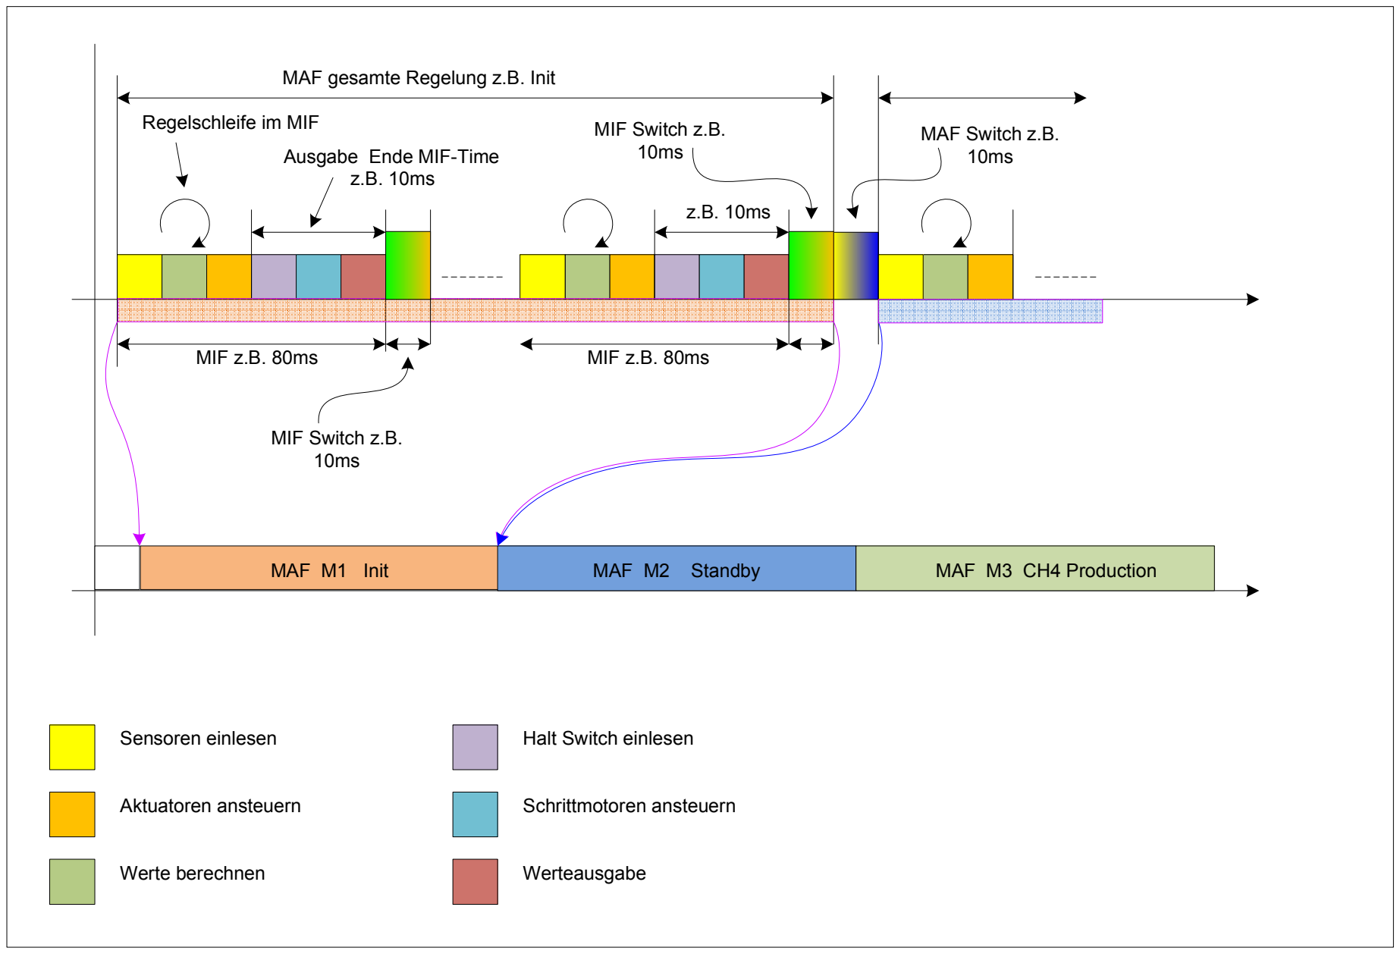
[picture p26: figure]
Sensoren einlesen; Aktuatoren ansteuern; Werte berechnen; Halt Switch einlesen; Schrittmotoren ansteuern; Werteausgabe; MAF gesamte Regelung z.B. Init; MIF z.B. 80ms; Regelschleife im MIF; Ausgabe Ende MIF-Time; MAF M1 Init; MAF M2 Standby; MAF M3 CH4 Production; MIF Switch z.B. 10ms; MAF Switch z.B. 10ms
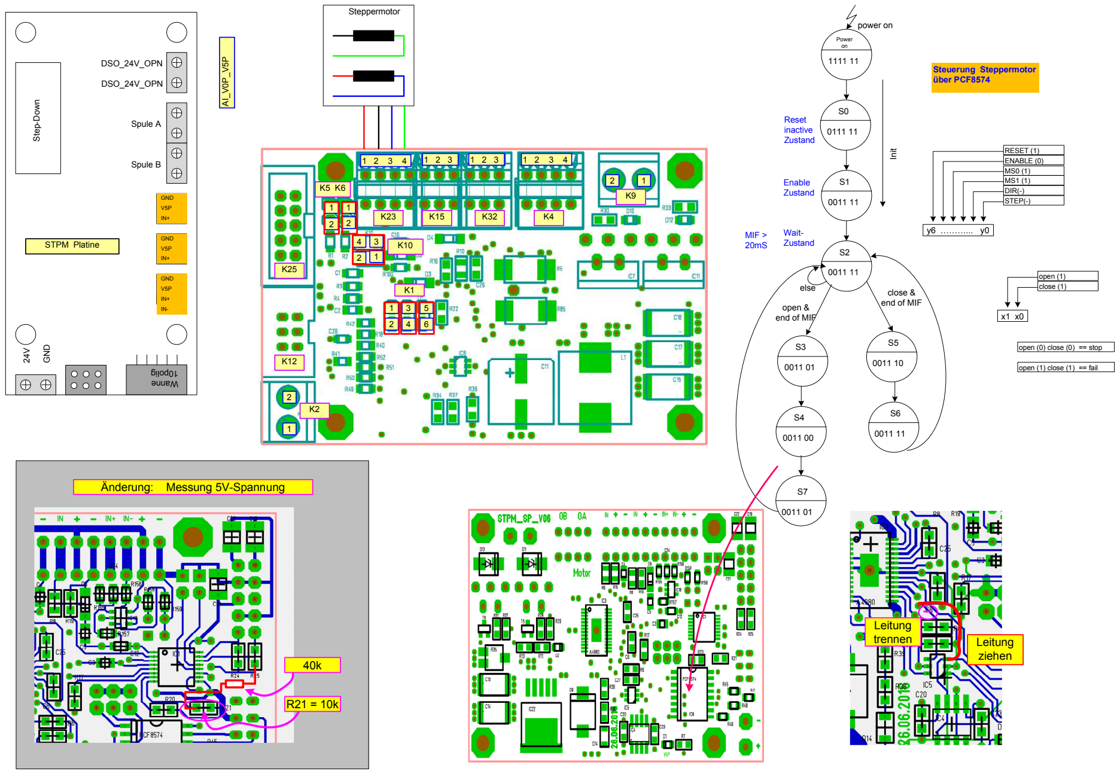
[picture p27: page 18]
GND; Spule A; Spule B; STPM Platine; DSO_24V_OPN; Step-Down; RESET (1) ENABLE (0); Init; DIR(-); STEP(-); y6 TTT... y0; power on; else; open (1); close (1); Enable Zustand; Reset inactive Zustand; Power on; Wait- Zustand; Steuerung Steppermotor über PCF8574; MIF > 20mS; Steppermotor; Leitung; trennen; ziehen

close &
end of MIF

open &

open (0) close (0) == stop

open (1) close (1) == fail

Änderung: Messung 5V-Spannung

## PSW-Board

## Test HS-Switch

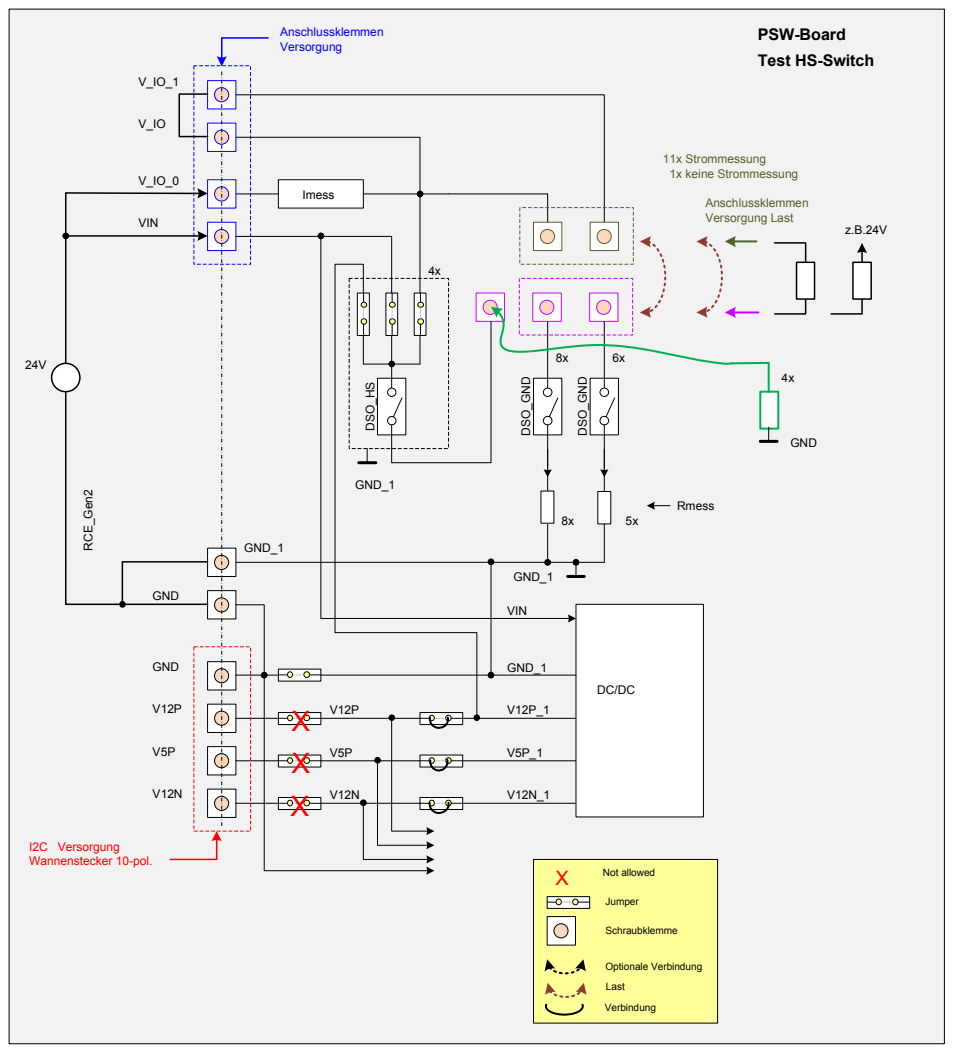
[picture p28: page 19]
VIN; Imess; GND_1; Anschlussklemmen Versorgung; DSO_HS; DSO_GND; Rmess; GND; I2C Versorgung Wannenstecker 10-pol.; RCE_Gen2 GND_1; Jumper; Schraubklemme; Optionale Verbindung; Last; Verbindung; X Not allowed; Anschlussklemmen Versorgung Last; 11x Strommessung 1x keine Strommessung

V5P | V12P

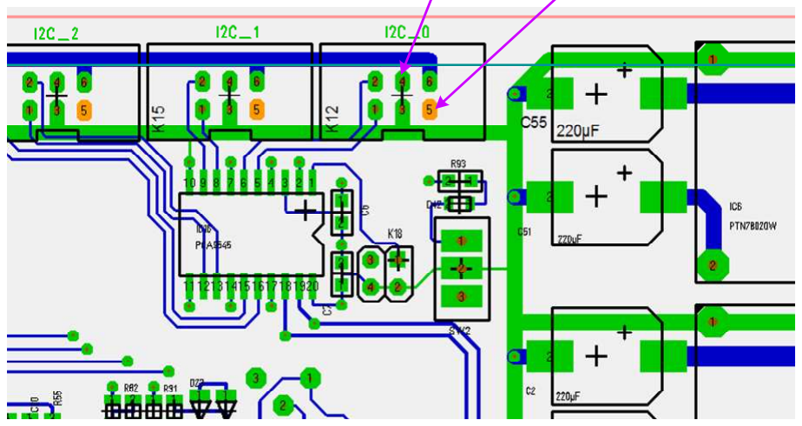
[picture p29: figure]

## PSW-Board

## PSW-Board

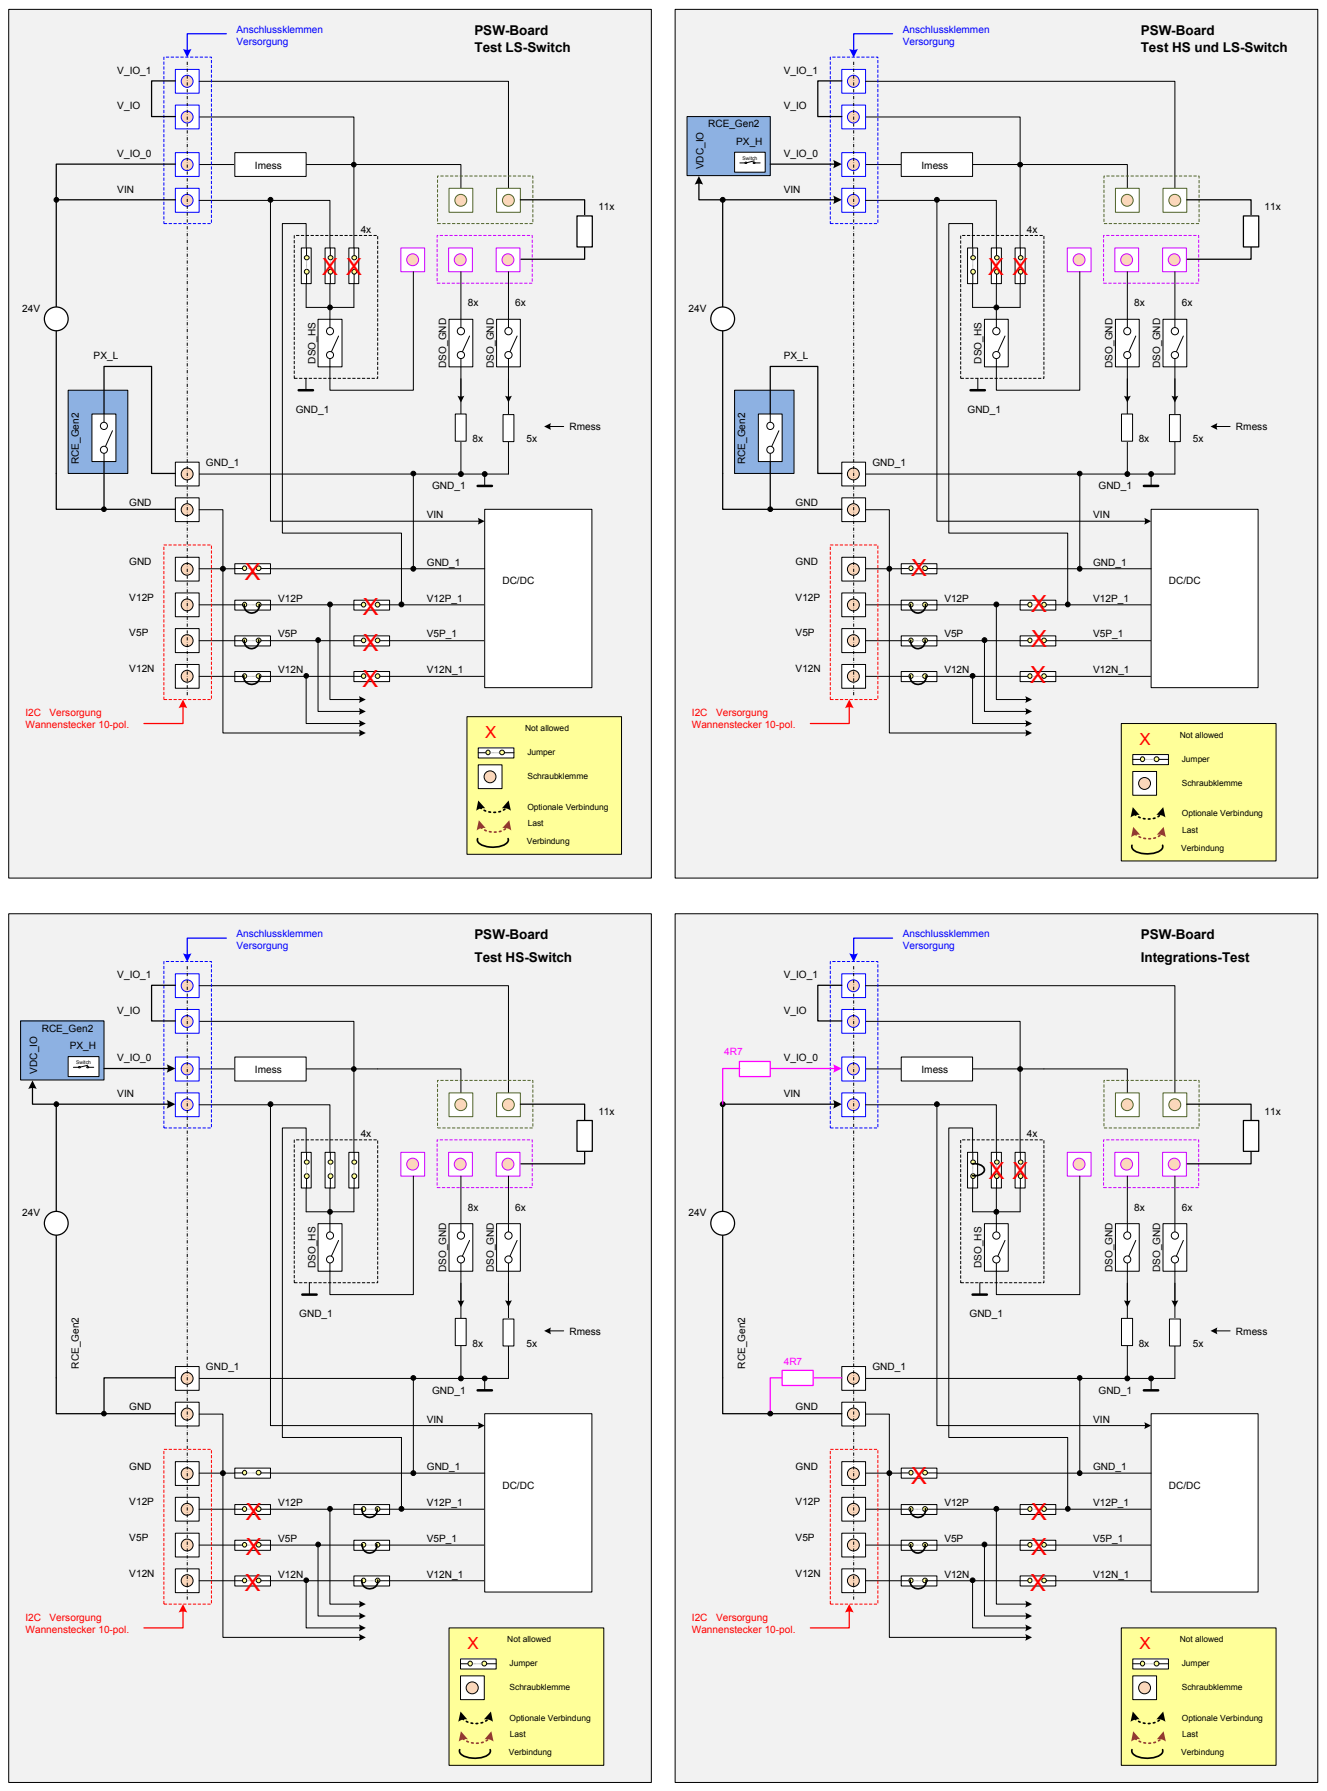
[picture p30: page 21]
VIN; Imess; GND_1; Anschlussklemmen Versorgung; DSO_HS; DSO_GND; Rmess; GND; I2C Versorgung Wannenstecker 10-pol.; RCE_Gen2; VDC_IO; Switch; Switch RCE_Gen2; Test LS-Switch; Test HS und LS-Switch; PSW-Board; Integrations-Test; Jumper; Schraubklemme; Optionale Verbindung; Last; Verbindung; Not allowed

PSW-Board
Test HS-Switch

# Konzept 1

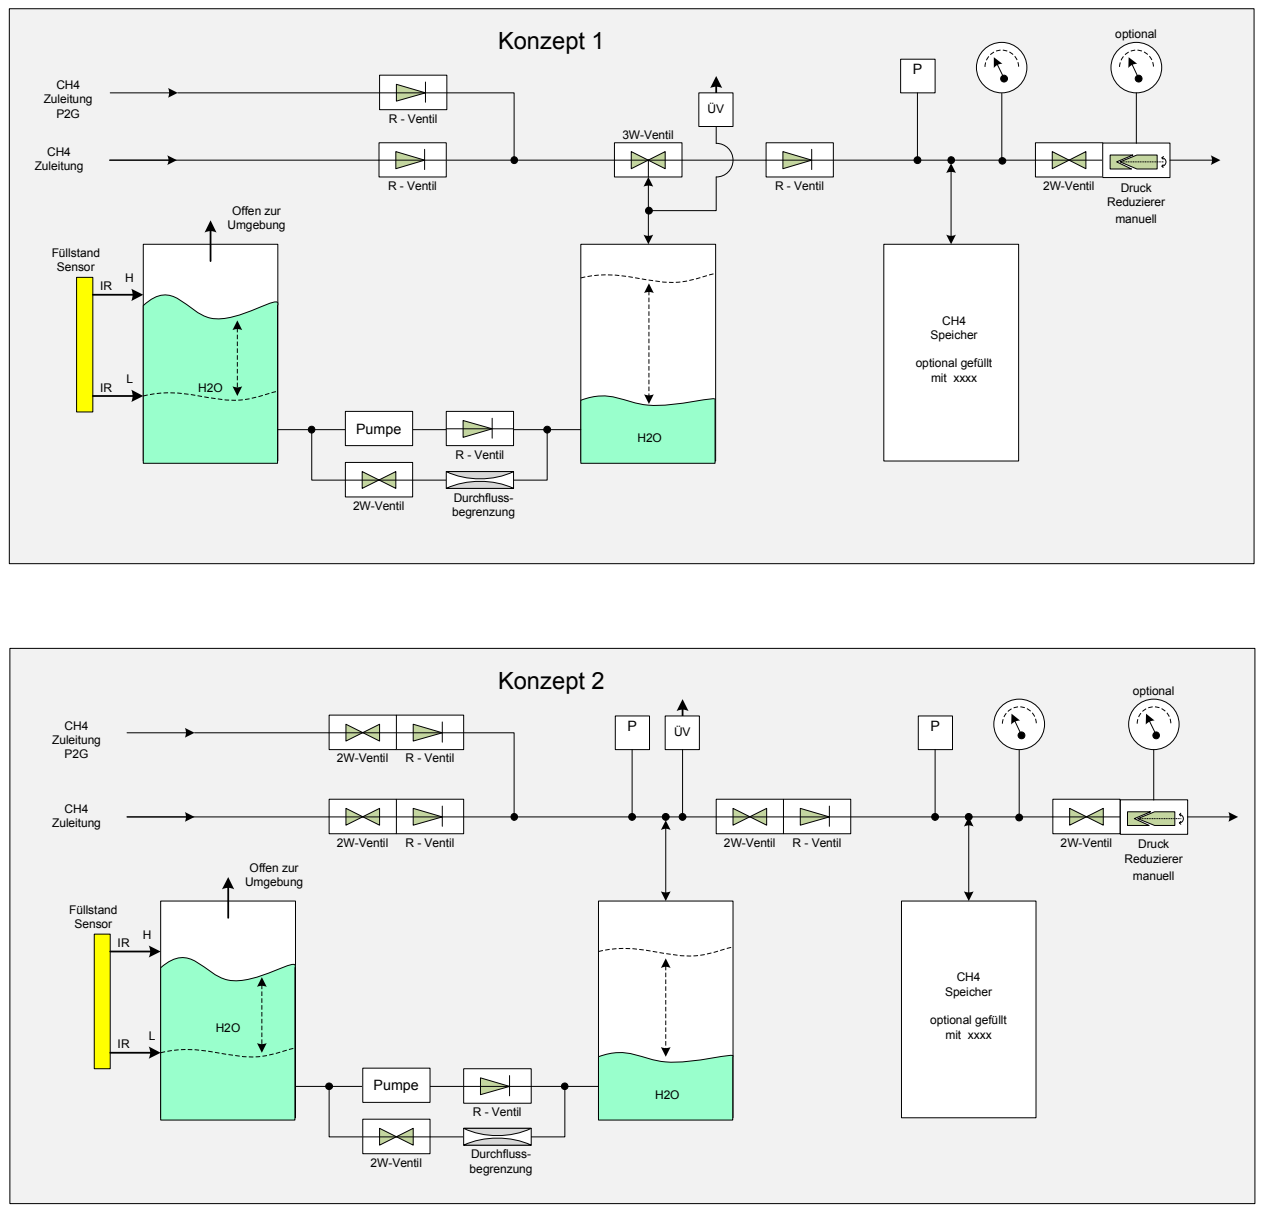
[picture p31: page 22]
2W-Ventil; Druck Reduzierer; manuell; H2O Pumpe; R - Ventil; 3W-Ventil; optional; CH4 Speicher; optional gefüllt mit xxxx; Offen zur Umgebung; Füllstand Sensor; CH4 Zuleitung; Durchfluss- begrenzung; Konzept 2

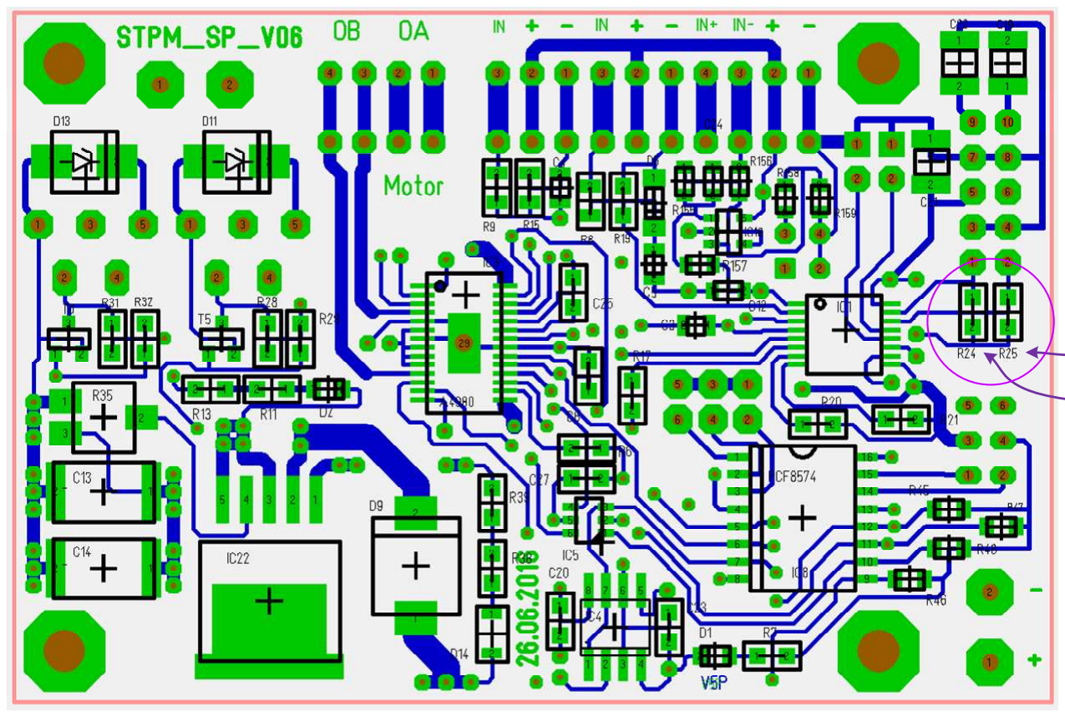
[picture p32: figure]

Widerstand R24 =>> 49k9

Widerstand R25 =>> 49k9

Modifikation von STM_SP_V06 =>> STM_SP_V06c

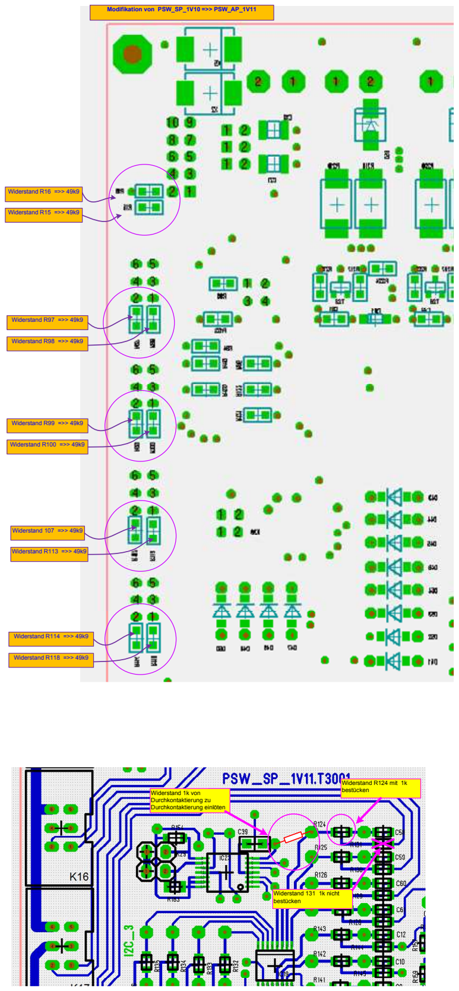
[picture p33: page 24]

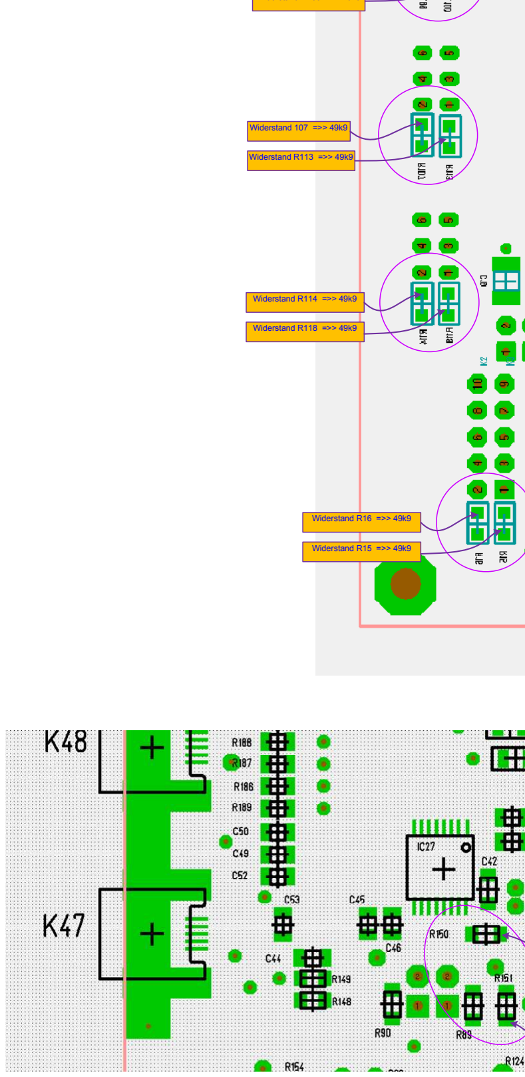
[picture p34: page 25]

Widerstand R100 =>> 49k9

Widerstand 107 =>> 49k9

Widerstand R113 =>> 49k9

Widerstand R114 =>> 49k9

Widerstand R118 =>> 49k9

Widerstand R16 =>> 49k9

Widerstand R15 =>> 49k9

# Stromversorgung Methanisierung

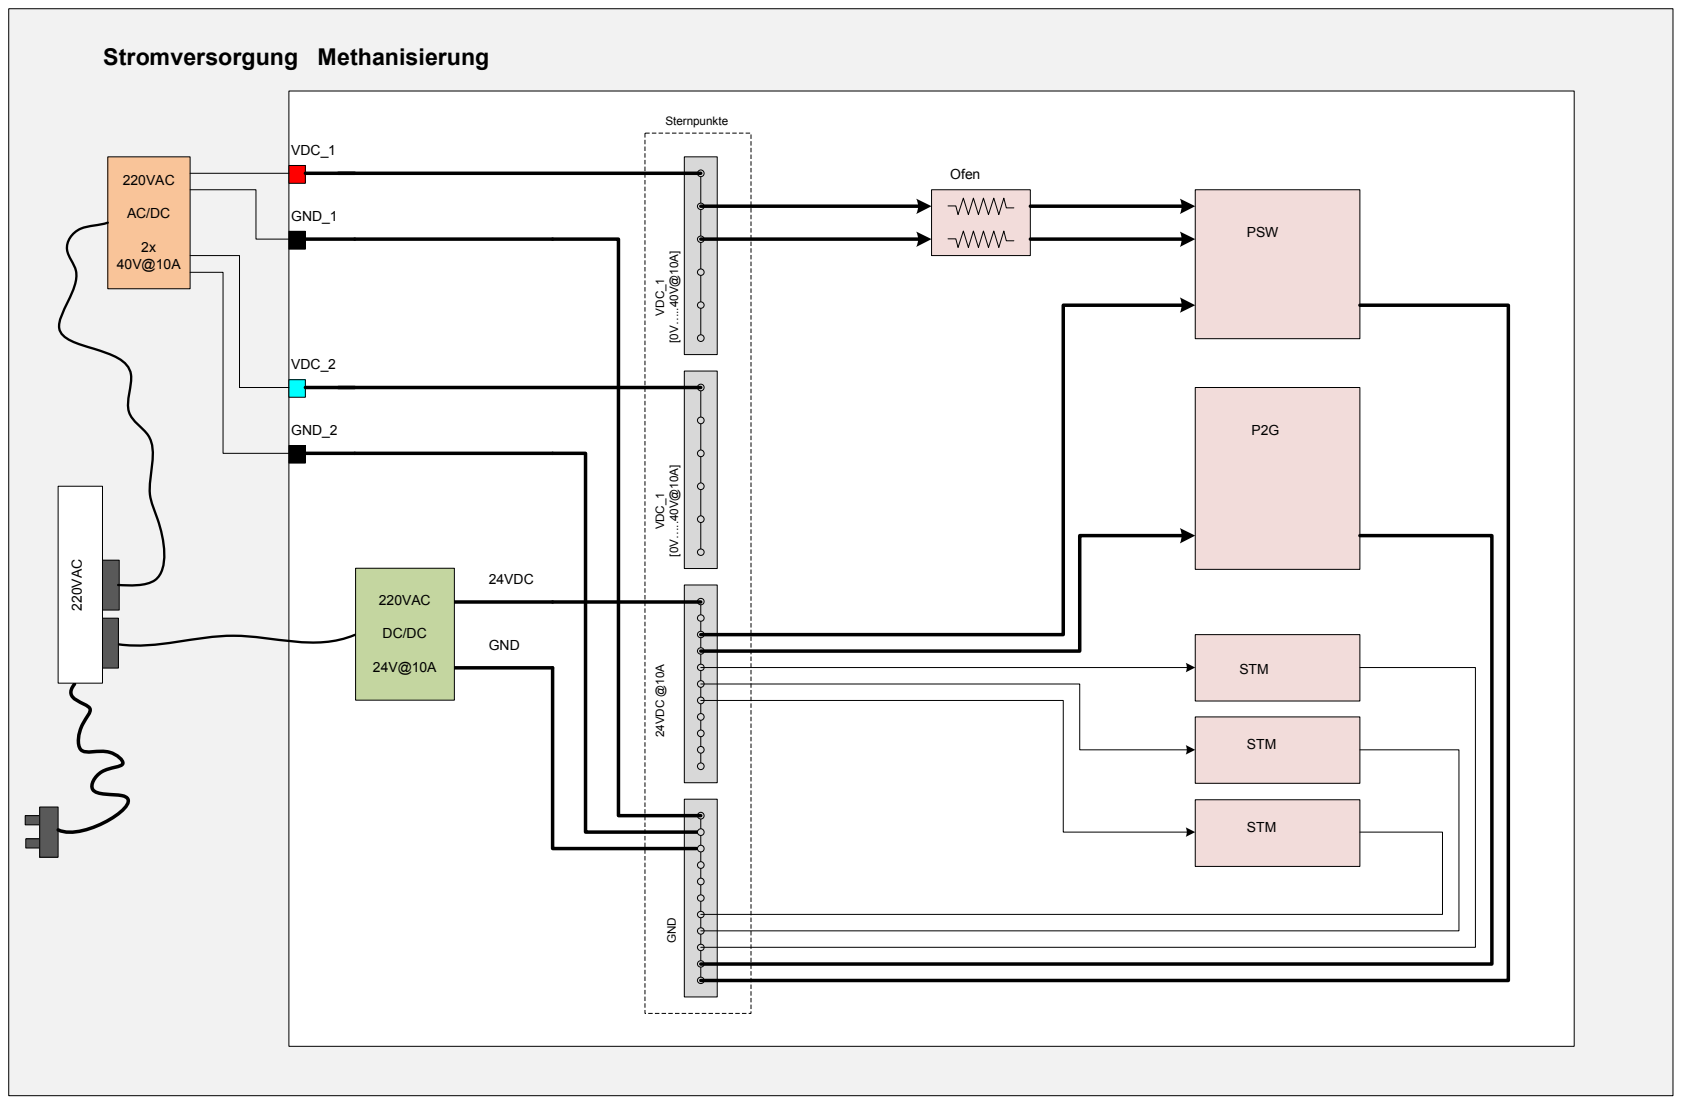
[picture p35: page 26]
VDC_1; GND_1; VDC_2; GND_2; 24VDC; 24VDC @10A; 220VAC; GND; PSW; Ofen; STM; Sternpunkte

GND

STM

# Stromversorgung Speicher & Motor

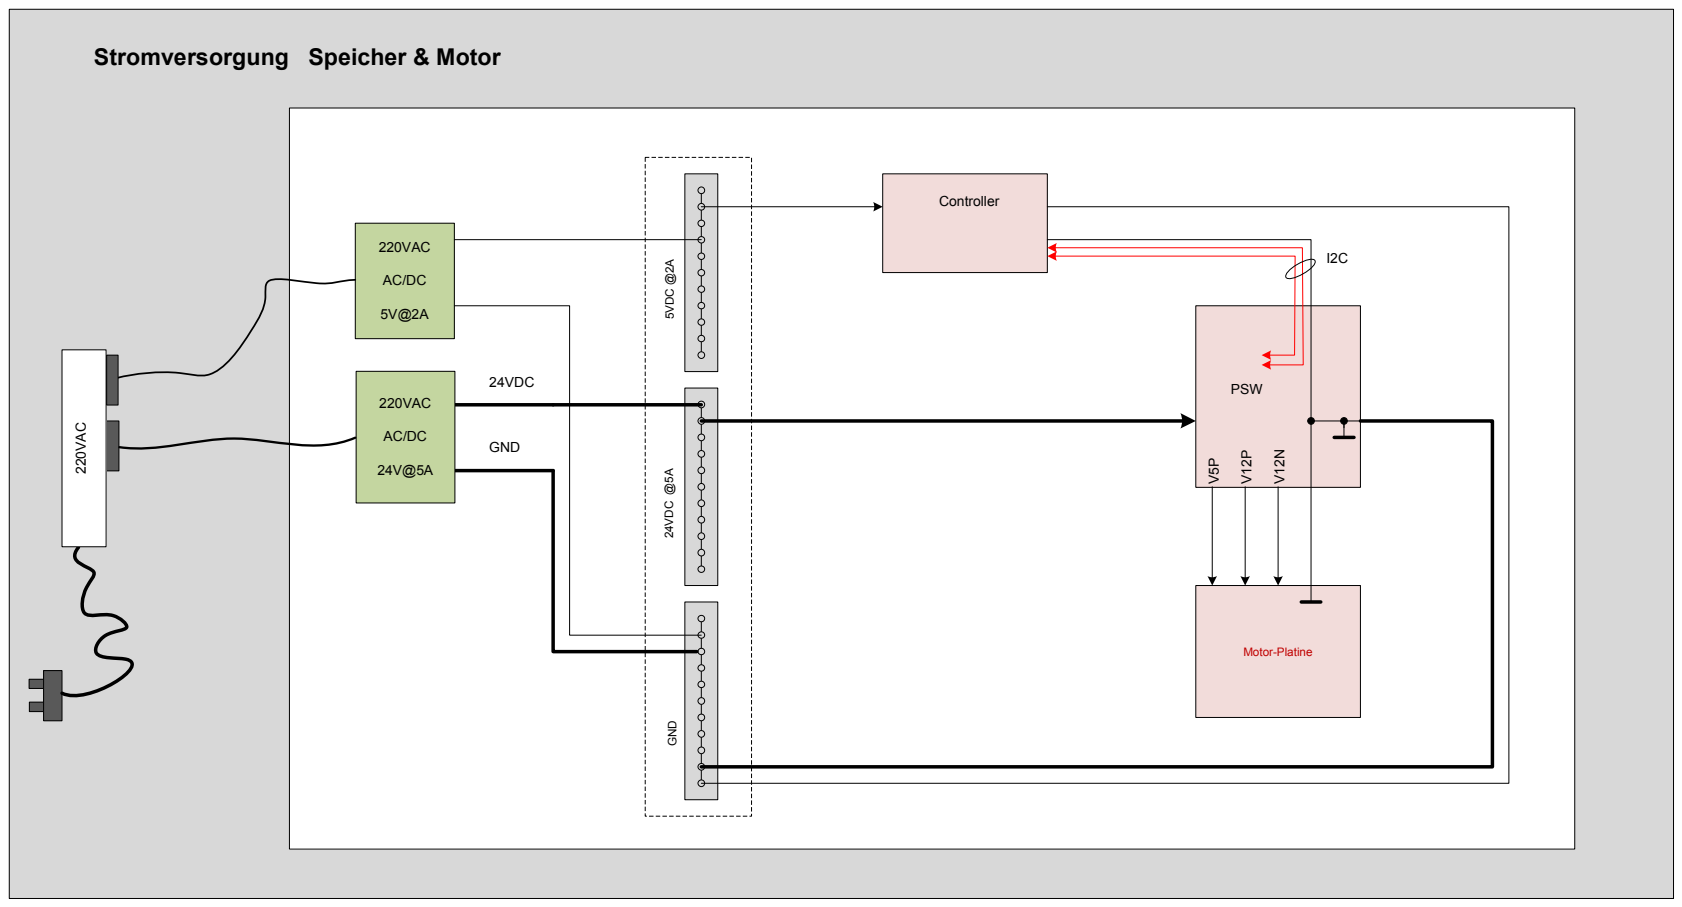
[picture p36: page 27]
24VDC; GND; 24VDC @5A; 220VAC; PSW; 5VDC @2A; Controller; Motor-Platine

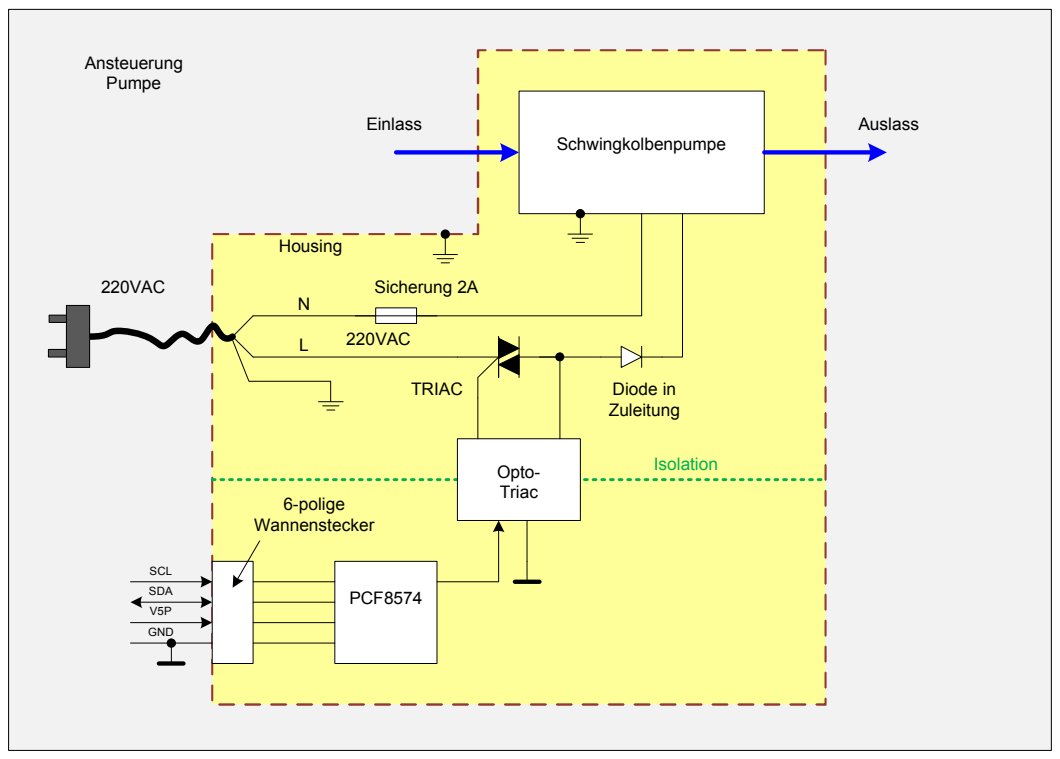
[picture p37: page 28]
Schwingkolbenpumpe; Opto- Triac; Housing; PCF8574; SCL; SDA; GND; 6-polige Wannenstecker; 220VAC; Isolation; Ansteuerung Pumpe; Einlass; Auslass; Sicherung 2A; TRIAC; Diode in; Zuleitung

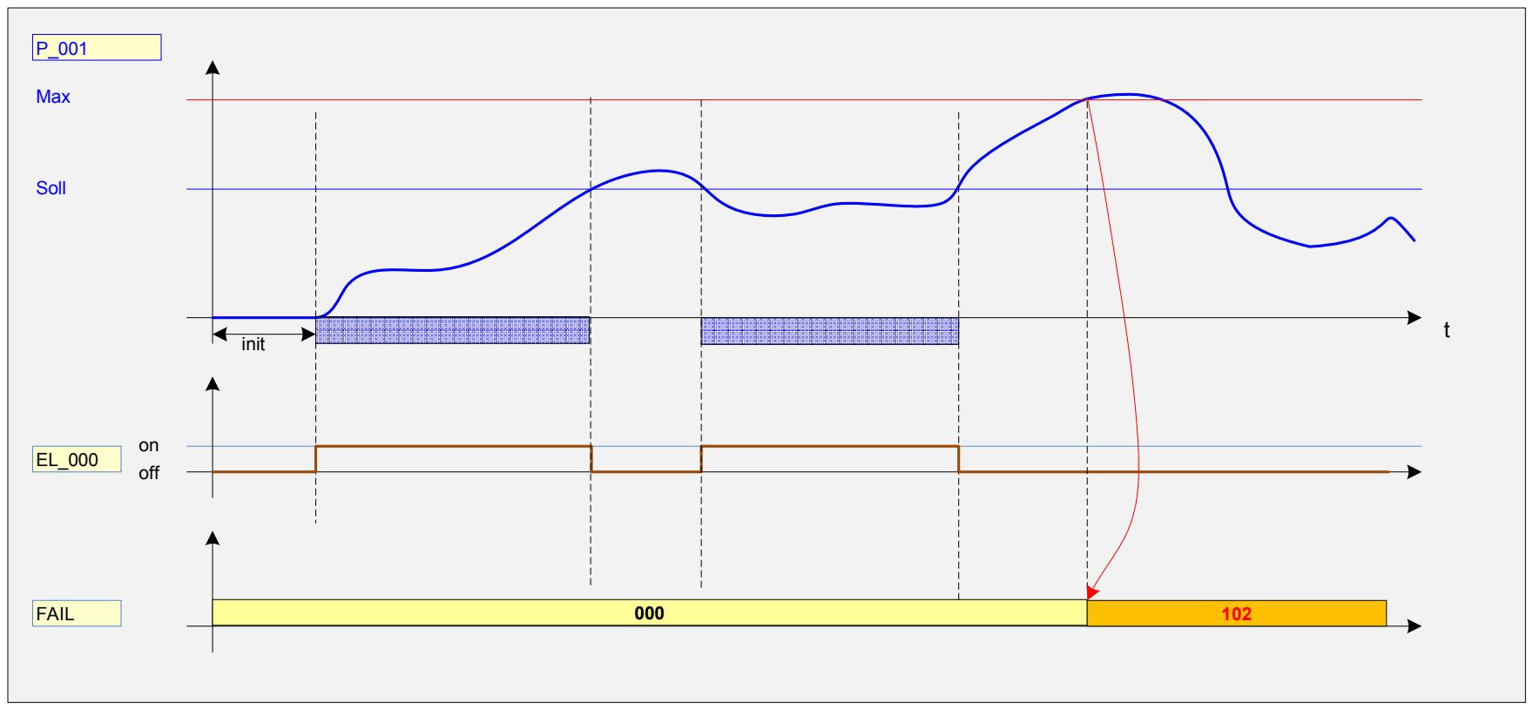
[picture p38: figure]
Soll; FAIL; off; init; Max
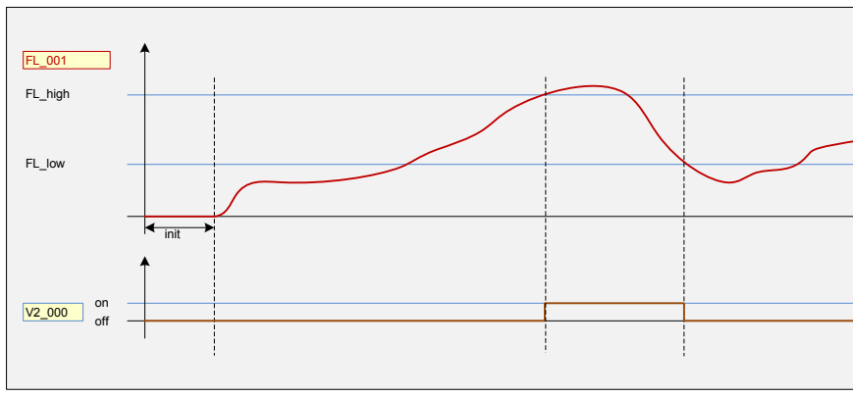
[picture p39: figure]
FL_high; FL_low; off; init
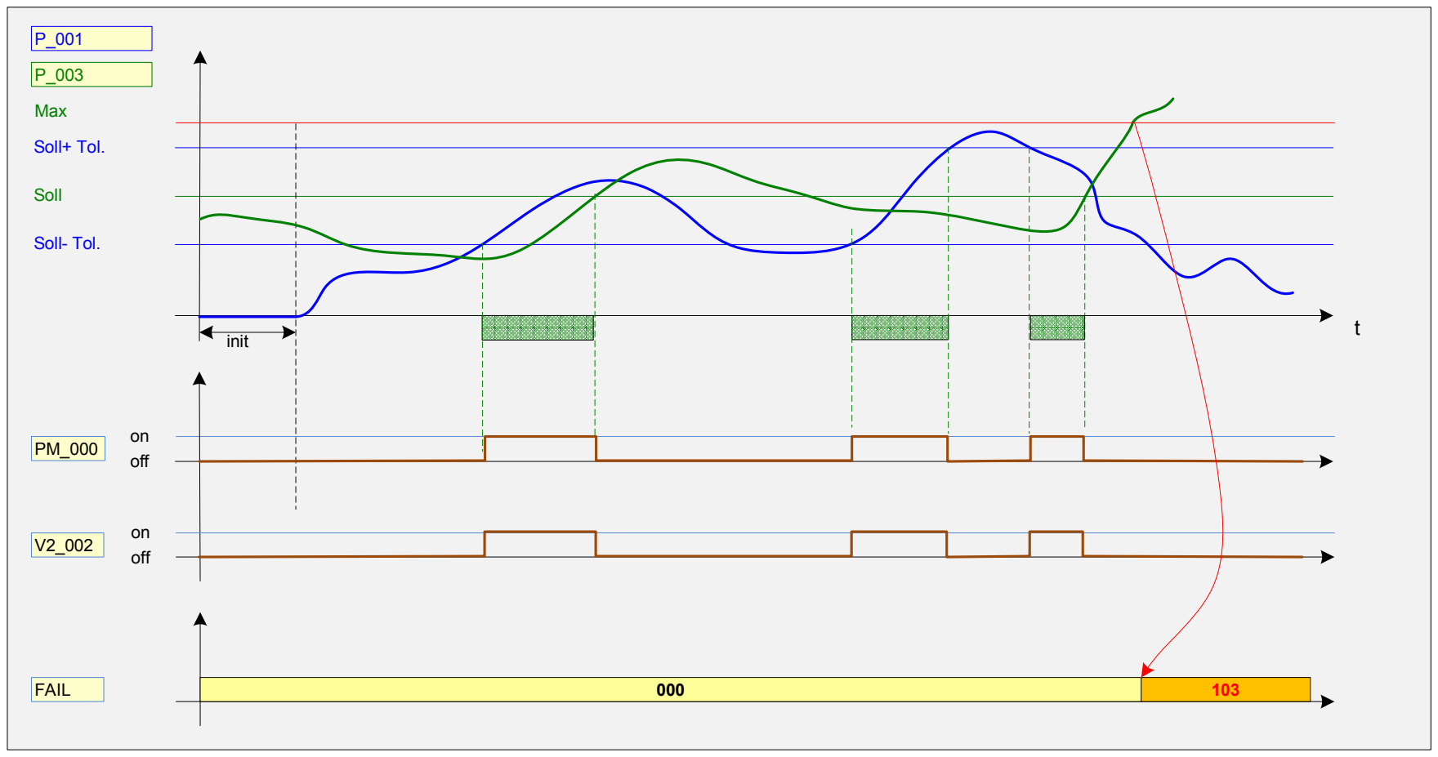
[picture p40: figure]
Soll; Soll+ Tol.; Soll- Tol.; FAIL; off; init; Max

t

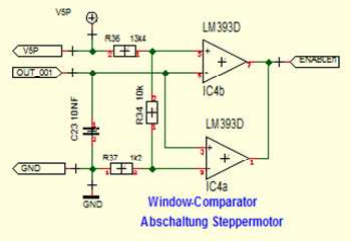
[picture p41: figure]
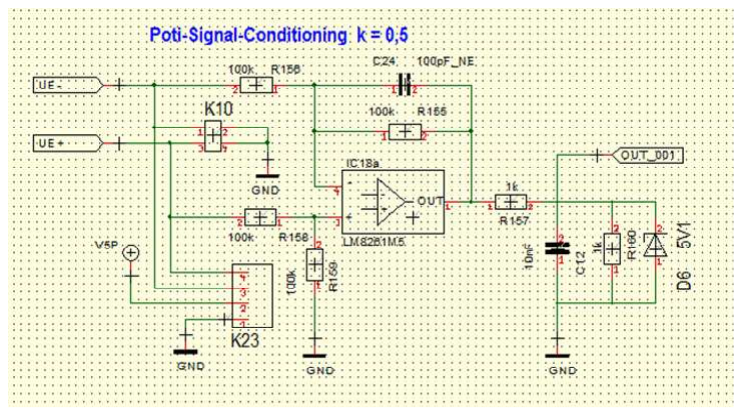
[picture p42: figure]

ENABLE

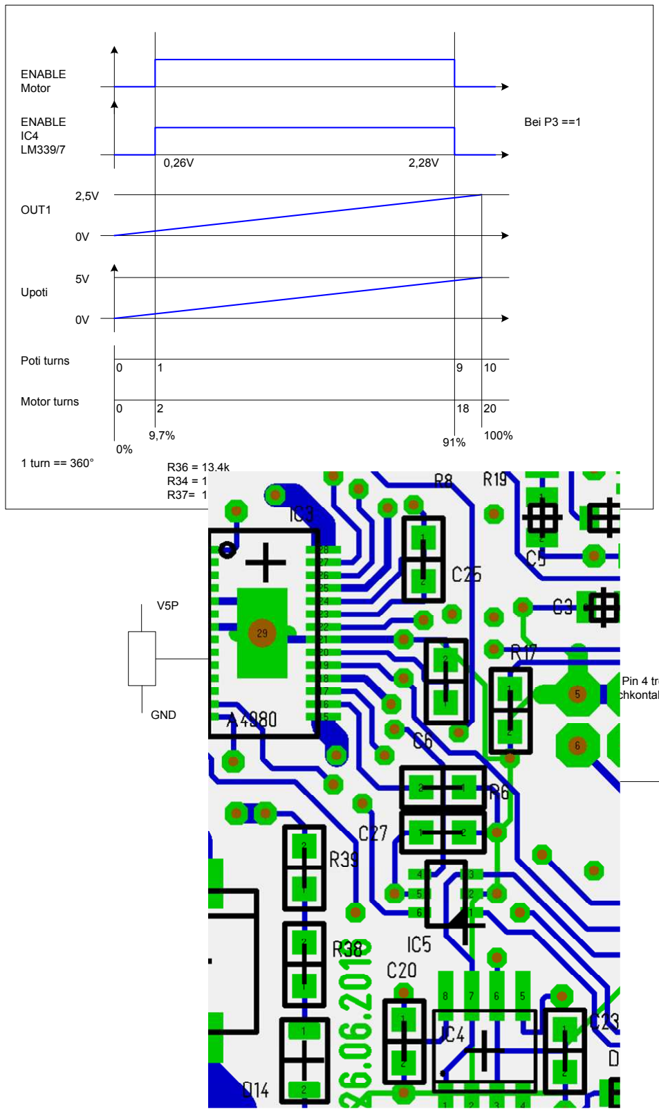
[picture p43: figure]
Upoti; ENABLE IC4 LM339/7; Poti turns; Motor turns; 1 turn == 360°; ENABLE Motor; OUT1; Bei P3 ==1; GND; ENABLEn

IC5 Pin 4 trennen und eitung von durchkontaktierung nach IC5 Pin 3 ziehen
