CodingGhost/CCIPN/CCMR/Docs/Visio_ZAYED_P2G_SP_2V00.pdf

# Übersicht Elektronik P2G

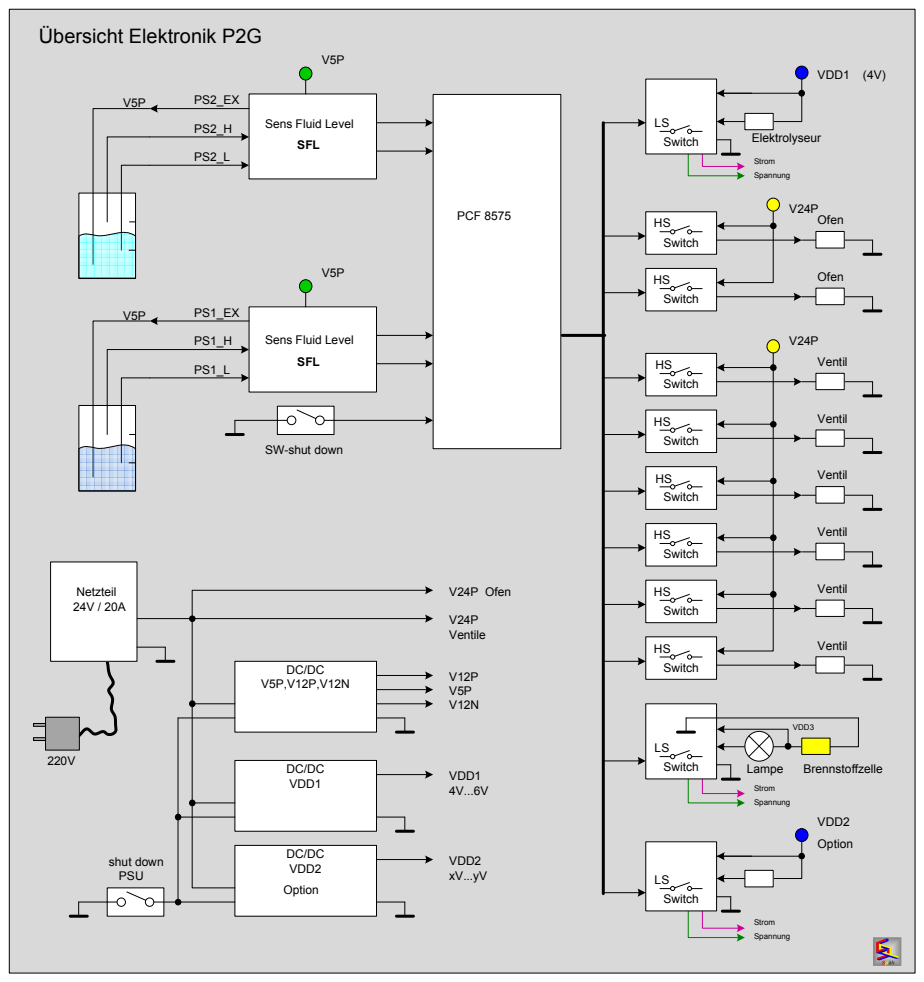
[picture p44: page 1]
Strom; Spannung; Switch; Ofen; Ventil; Elektrolyseur; VDD1 (4V); SFL; PCF 8575; Netzteil 24V / 20A; VDD1; VDD1 4V...6V; V24P Ofen; V24P Ventile; Brennstoffzelle; VDD2; Option; VDD3; VDD2 xV...yV; shut down PSU; Lampe 220V

Sens Fluid Level

SW-shut down

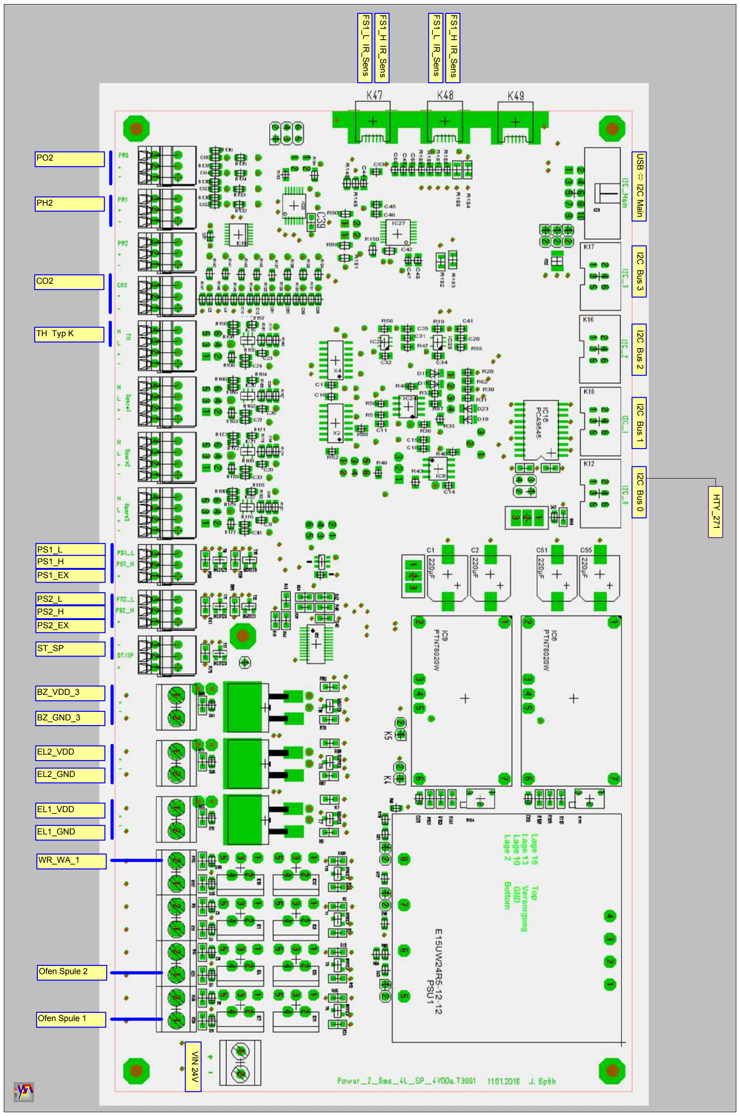
[picture p45: page 2]

PO2

PH2

BZ_VDD_3

BZ_GND_3

EL2_VDD

EL2_GND

EL1_VDD

EL1_GND

ST_SP

PS2_L
PS2_H

PS1_L
PS1_H

CO2

Ofen Spule 1

Ofen Spule 2

WR_WA_1

TH Typ K

VIN 24V

FS1_L IR_Sens

FS1_H IR_Sens

FS1_L IR_Sens

FS1_H IR_Sens

USB I2C Main I2C Bus 3 I2C Bus 2 I2C Bus 1 I2C Bus 0

HTY_271

PS1_EX

PS2_EX

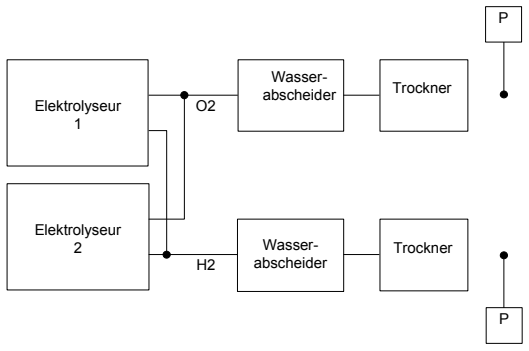
[picture p46: figure]
Elektrolyseur 2; Elektrolyseur 1; Wasser-; Trockner; abscheider

Trockner

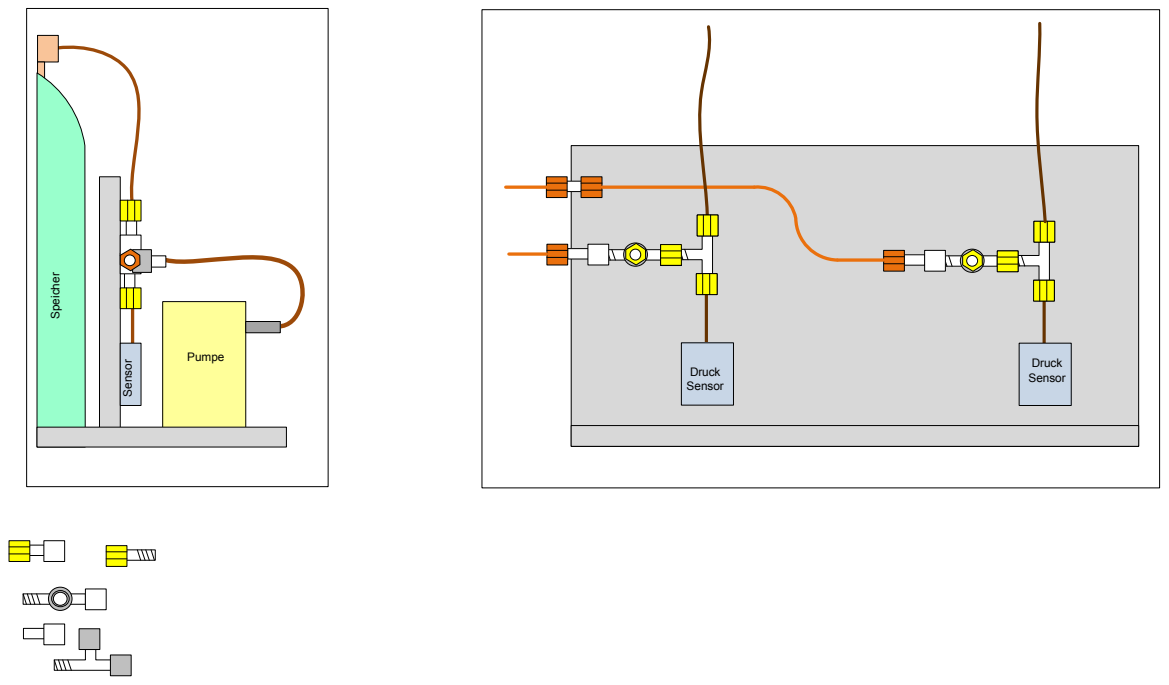
[picture p47: page 4]
Druck Sensor; SensorPumpe; Speicher

Methanisierung | Speicher | Gaskraftwerk

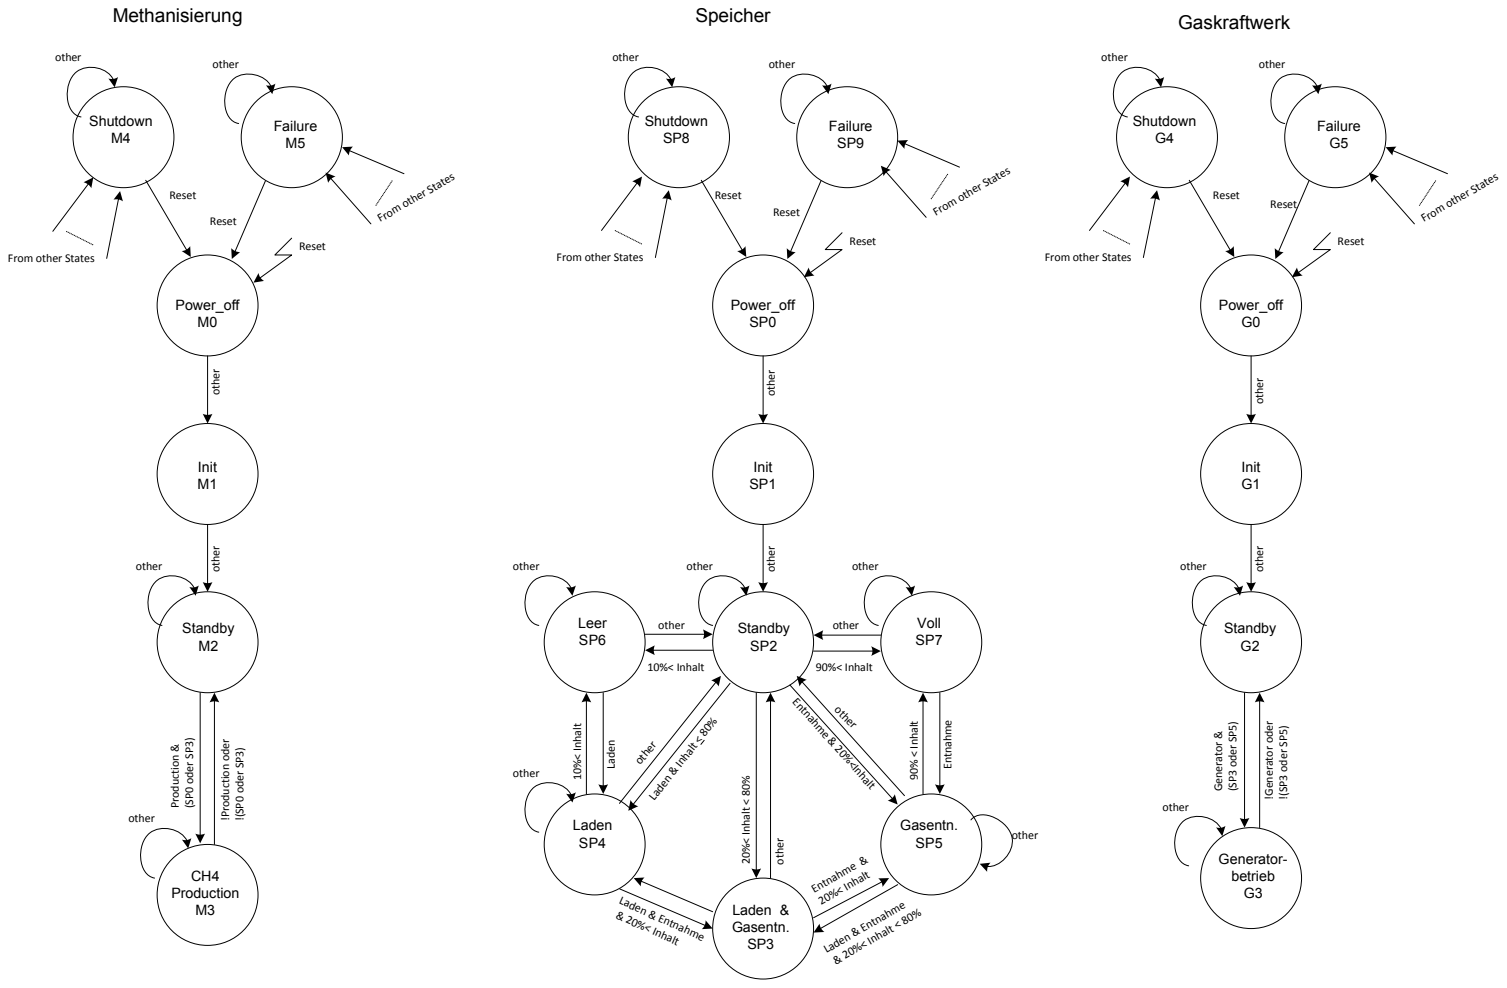
[picture p48: page 5]
Power_off M0; Failure M5; Init M1; Standby M2; CH4 Production M3; Shutdown M4; Power_off G0; Init G1; Standby G2; Generator- betrieb G3; Power_off SP0; Init SP1; Standby SP2; Laden & Gasentn. SP3; Failure SP9; Shutdown SP8; Failure G5; Shutdown G4; Laden SP4; Gasentn. SP5; Leer SP6; Voll SP7; Entnahme & 20%<Inhalt; 10%< Inhalt; 90% < Inhalt; Laden & Entnahme & 20%< Inhalt < 80%; Entnahme & 20%< Inhalt; other; Laden; 90%< Inhalt; other other; Reset; Production &; (SP0 oder SP3); Generator &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

From other States From other States From other States

From other States

Entnahme other other

20%< Inhalt < 80% Laden & Inhalt < 80%

Laden & Entnahme & 20%< Inhalt

# Schrittmotor in unipolarer Konfiguration

# - Ansteuerung über 4 CVHBs

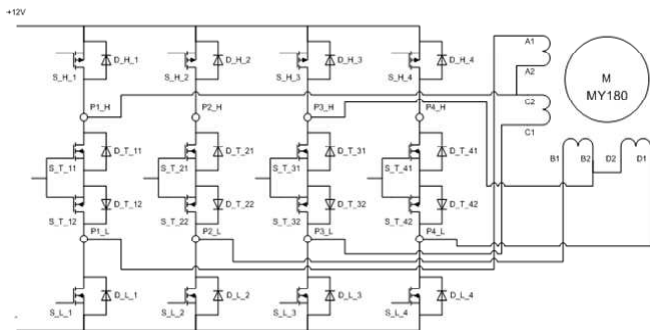
[picture p49: figure]
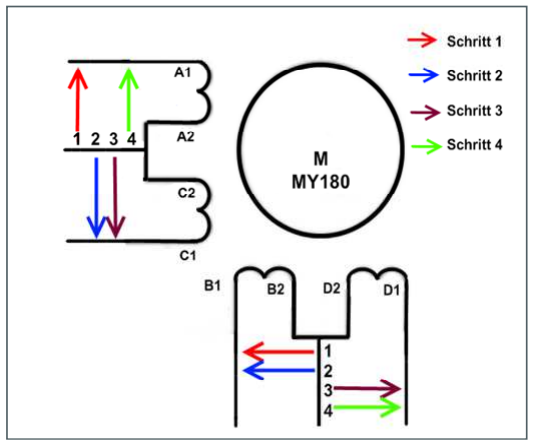
[picture p50: figure]

# Stromrichtung Schritt 1-4 • Trennschalter geöffnet

# - Geschwindigkeitsregelung durch Wartezeit zwischen Schritten - Drehrichtung durch Reihenfolge der Schritte - Schrittkombinationen in Datenblatt

A1 | = | weiß
B1 | = | rosa
C1 | = | grün
D1 | = | grün/gelb
B2 & D2 | = | organge
A2 & C2 | = | blau
Masse | = | schwarz
DSO_GNDOPN_1A5 | 1

V12P

V12P

Masse

Schritt 1 | = | A1 & B1
Schritt 2 | = | B1 & C1
Schritt 3 | = | C1 & D1
Schritt 4 | = | D1 & A1
DSO_GNDOPN_1A5 | 2
DSO_GNDOPN_1A5 | 3
DSO_GNDOPN_1A5 | 4
Rechts: | Schrittfolge | I 1,2,3,4,1,2 I..
Links: | Schrittfolge | I 3,2,1,4,3,2 I..
