CodingGhost/CCIPN/(commit log)

2016-04-18 Add Full Flowchart(Microsoft Visio)
2016-07-01 Add switch and PCF8575 functions
2016-07-04 add Spähsche dokumente
    [ICD_Zayed_SP_V02_sfz.xls]
2016-07-22 Delete ICD_Zayed_SP_V02_sfz.xls
    errors
    [ICD_Zayed_SP_V02_sfz.xls]
2016-11-28 new Communication functions
    [ICD_Zayed_SP_V09_sfz.xls]
2016-11-30 GUI Manual control functions(Blind)
    [ICD_Zayed_SP_V09_sfz.xls]
2016-12-02 ICD update
    [ICD_Zayed_SP_V11_sfz.xls]
2016-12-09 CHannels auf 0 resetten;
    For loops bei MAX1238
    add tooltip
    Flowrate sensor
    [CCMR.h, CCMR.ino, Communication.h]
2017-02-10 Valves and sensor
2017-02-12 Added V3_000
    new system image
    more Pressure sensors
    [ICD_Zayed_SP_V12_sfz.xls]
2017-04-28 add CCSEG
    [RSA.xlsx]
2017-05-26 oven + new items
    [ICD_Zayed_SP_V12_sfz.xls]
2017-06-02 IR sensors
    [ICD_Zayed_SP_V12_sfz.xls]
2017-07-16 Serial speed workaround (500ms)
    [CCMR.h, CCMR.ino]
